HASP-UMN/2015/Subsystem Tests/Detector Testing/Amplifier_Waveforms.png

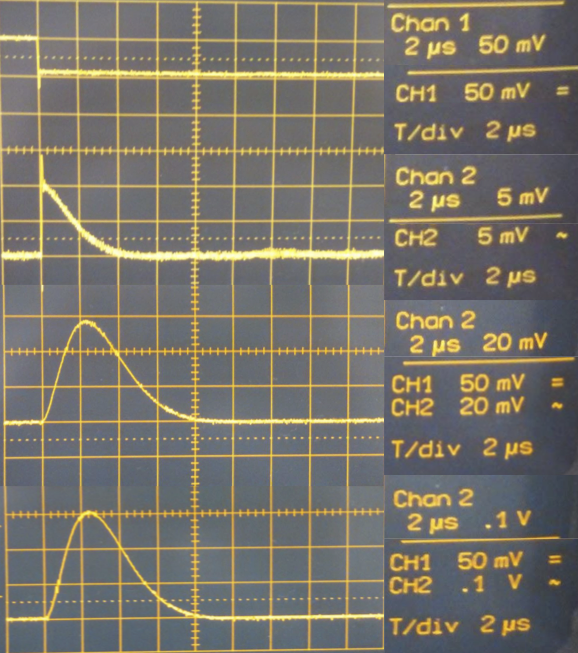
Subsystem Tests/Detector Testing/Amplifier_Waveforms.png
