HASP-UMN/2015/Hardware/TPP/timing_preprocessor.png

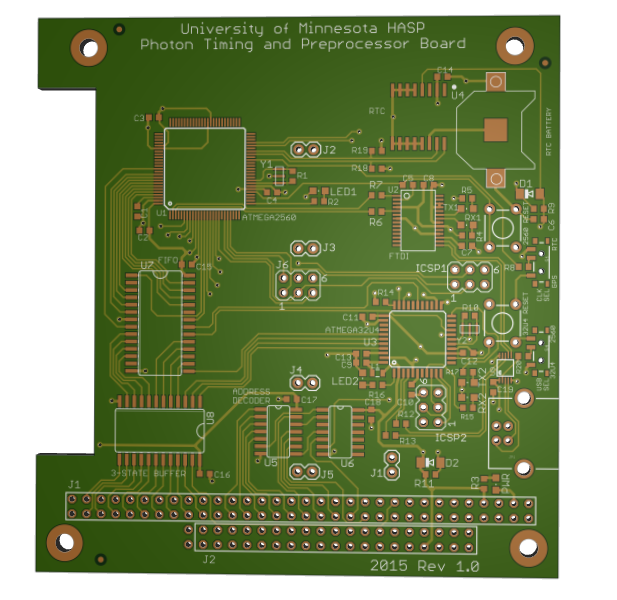
Hardware/TPP/timing_preprocessor.png
