HASP-UMN/2015/Hardware/Detector Front End/FE#1.png

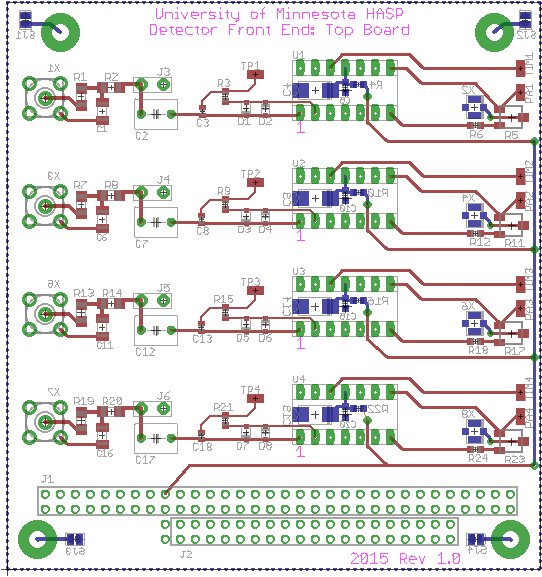
Hardware/Detector Front End/FE#1.png
