HASP-UMN/2015/Hardware/Detector Front End/FE#2.png

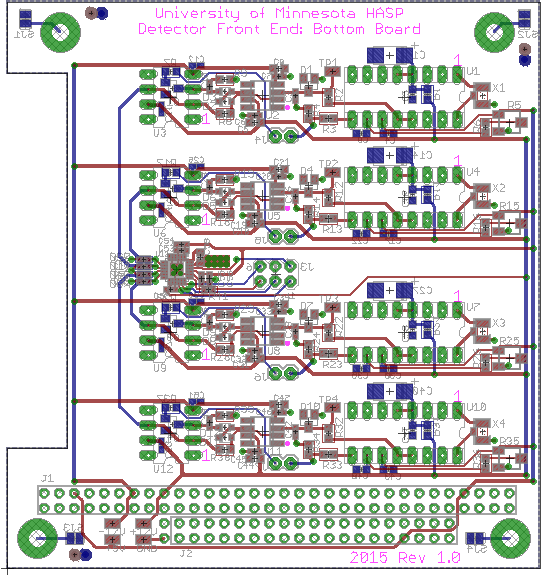
Hardware/Detector Front End/FE#2.png
