HASP-UMN/2015/Hardware/GNSS-IMU/GNSS_IMU.png

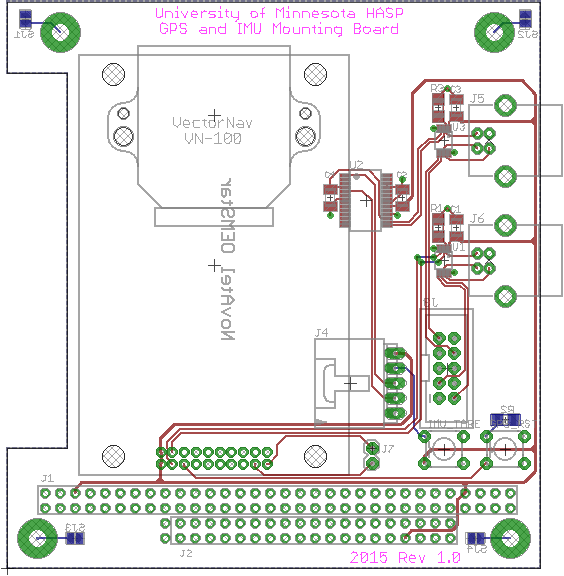
Hardware/GNSS-IMU/GNSS_IMU.png
