HASP-UMN/2015/Hardware/HVPS/HVPS.png

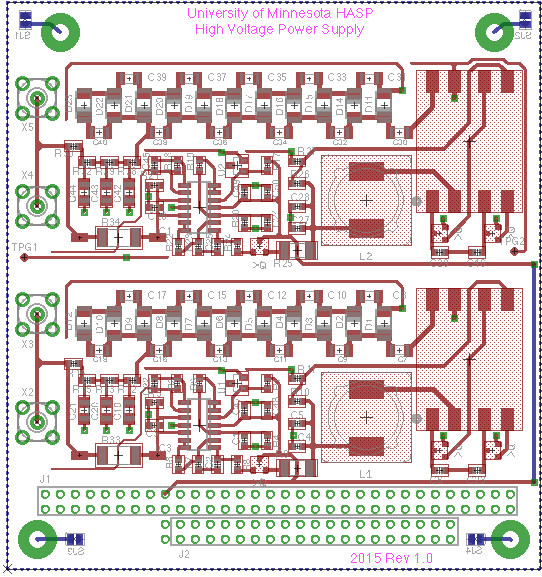
Hardware/HVPS/HVPS.png
