HASP-UMN/2015/Hardware/TPP/TPP.png

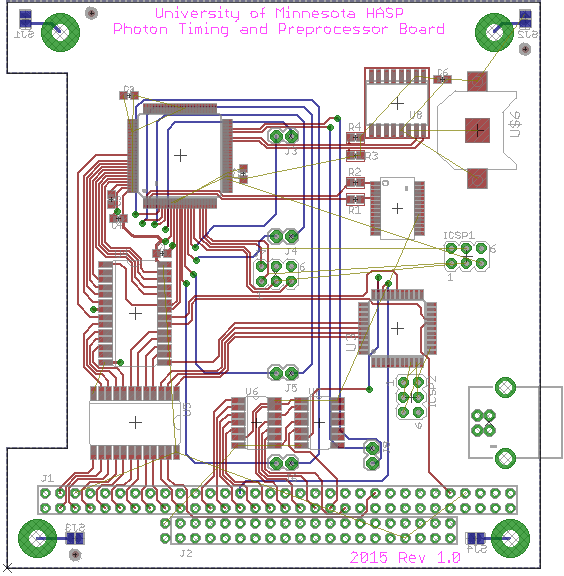
Hardware/TPP/TPP.png
