HASP-UMN/2015/Subsystem Tests/Detector Testing/Source Spectra/Am-241_1.png

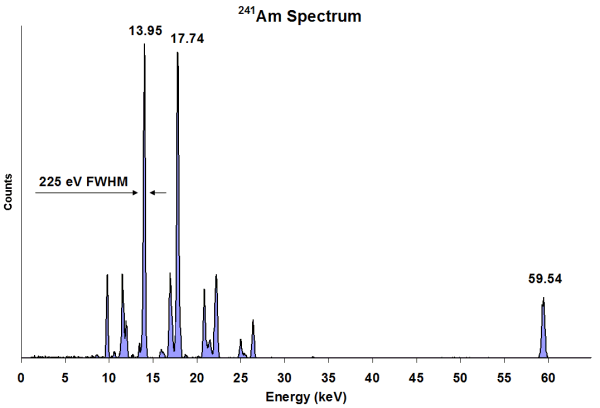
Subsystem Tests/Detector Testing/Source Spectra/Am-241_1.png
