HASP-UMN/2015/Subsystem Tests/Detector Testing/Source Spectra/Am-241_2.png

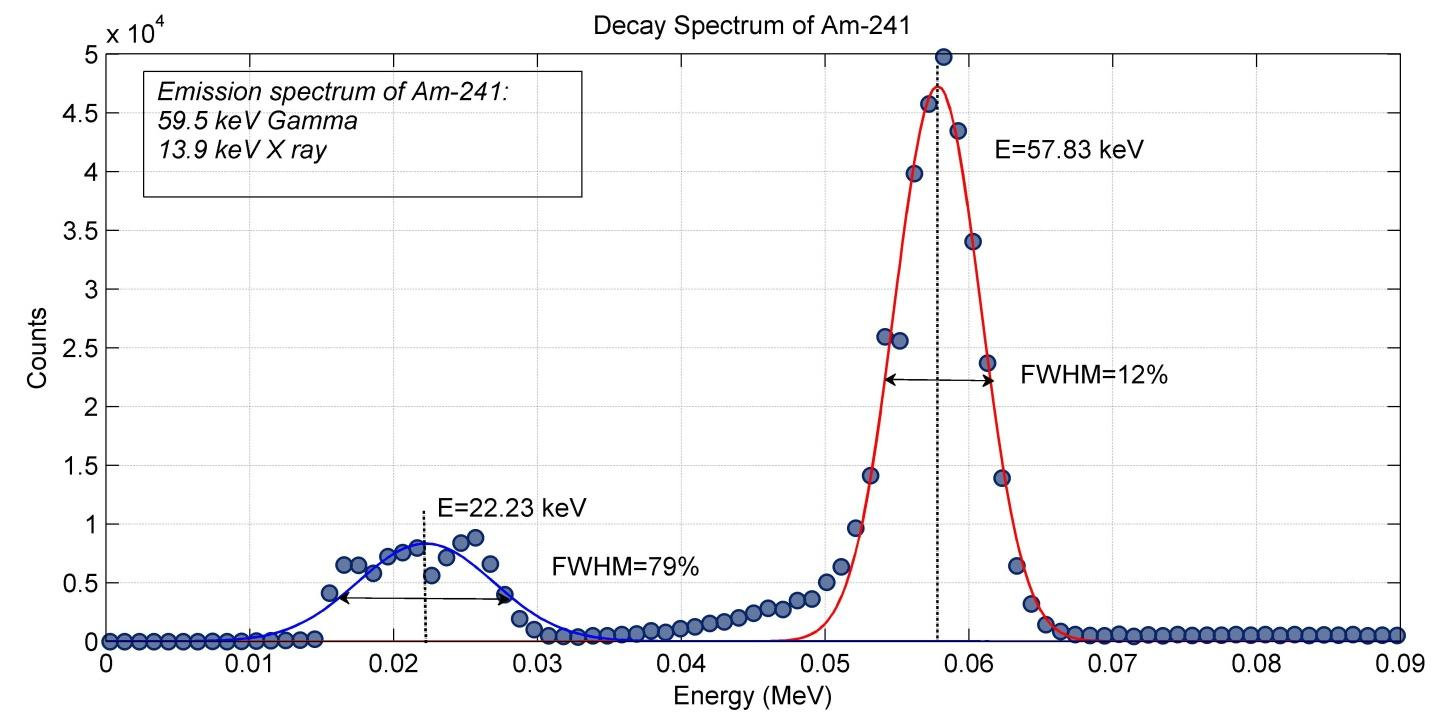
Subsystem Tests/Detector Testing/Source Spectra/Am-241_2.png
