HASP-UMN/2015/Subsystem Tests/Detector Testing/Source Spectra/Co-60_1.gif

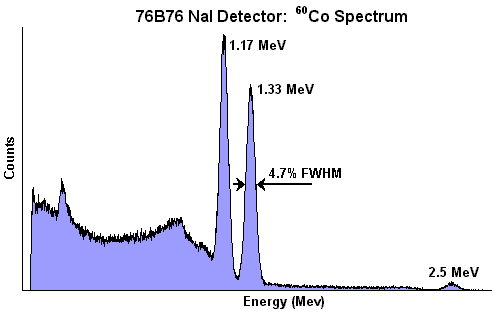
Subsystem Tests/Detector Testing/Source Spectra/Co-60_1.gif
