HASP-UMN/2015/Subsystem Tests/Detector Testing/Source Spectra/Cs-137_1.gif

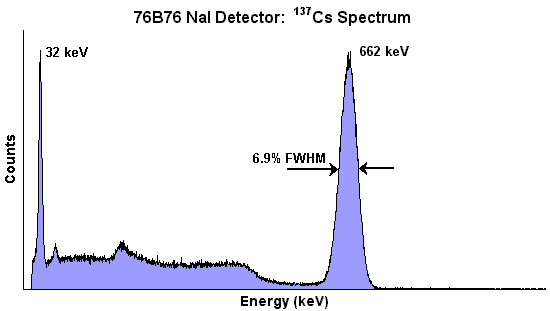
Subsystem Tests/Detector Testing/Source Spectra/Cs-137_1.gif
