HASP-UMN/2015/Subsystem Tests/Detector Testing/Cesium137.png

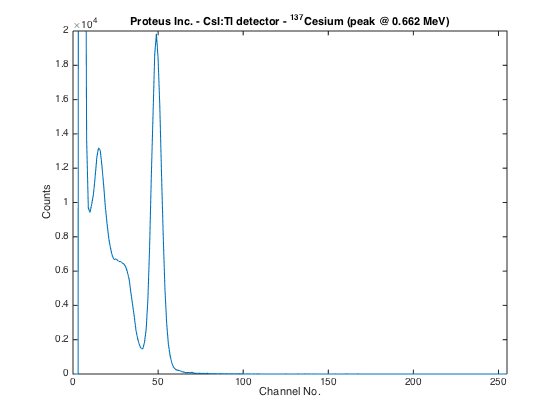
Subsystem Tests/Detector Testing/Cesium137.png
