HASP-UMN/2015/Subsystem Tests/Detector Testing/Cobalt60.png

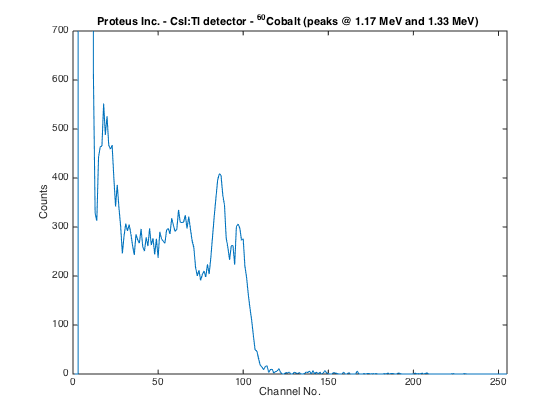
Subsystem Tests/Detector Testing/Cobalt60.png
