HASP-UMN/2015/Subsystem Tests/Detector Testing/GainFactor1.png

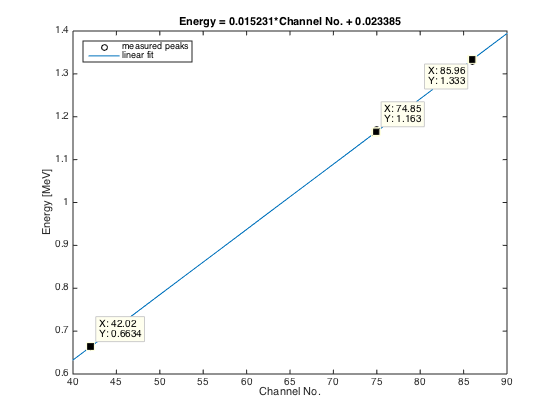
Subsystem Tests/Detector Testing/GainFactor1.png
