HASP-UMN/2015/Subsystem Tests/Detector Testing/Source Spectra/Am-241_3.pdf

## Page -1-

10⁶

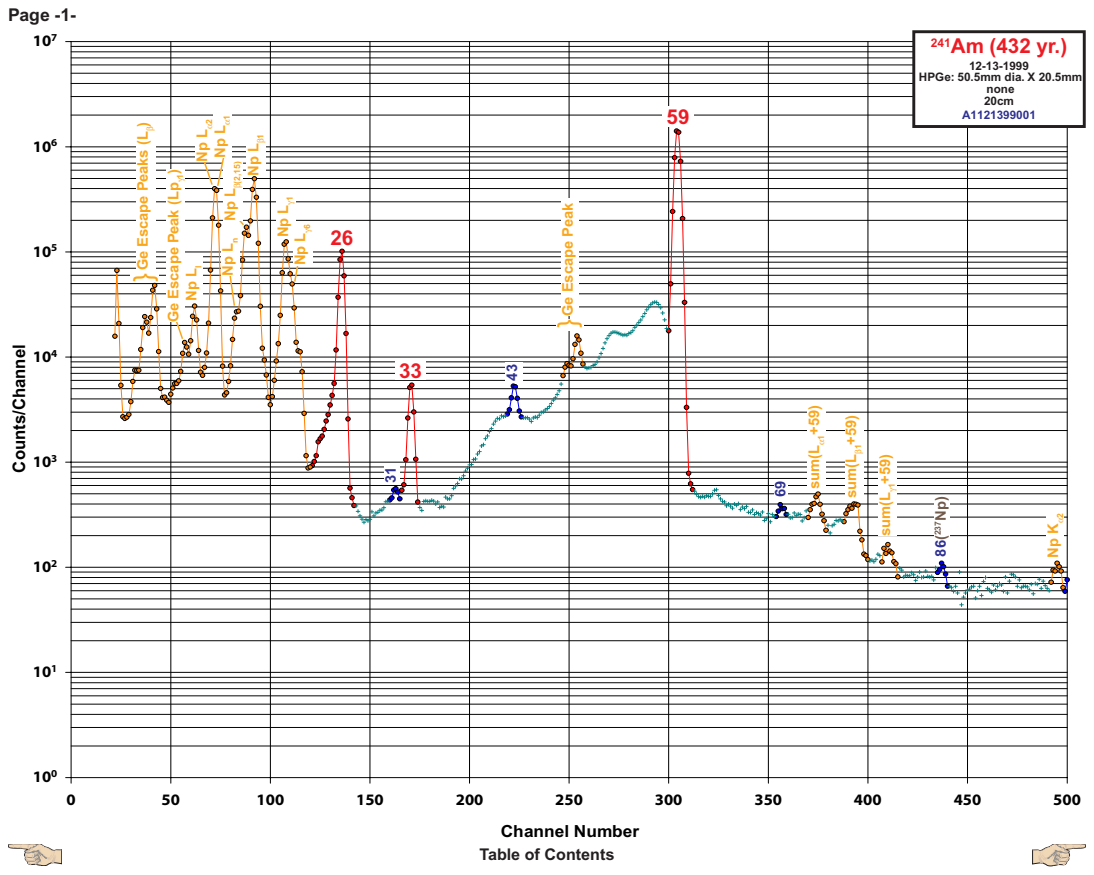
[picture p16: page 1]
Counts/Channel; 12-13-1999 HPGe: 50.5mm dia. X 20.5mm; sum(L

none
A1121399001 | 20cm

Ge Escape Peaks (L

Ge Escape Peak (Lp

Ge Escape Peak

Channel Number
Table of Contents

## Page -2-

## 241Am (432 yr.)

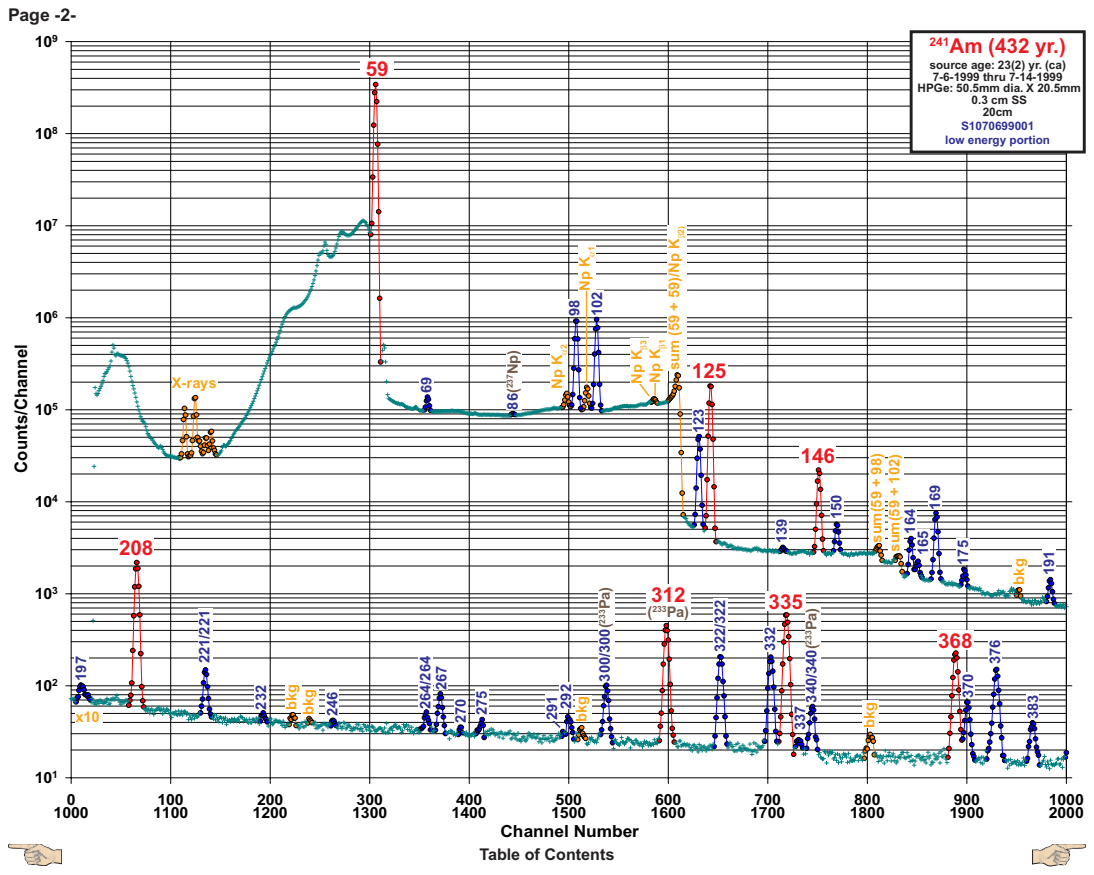
[picture p17: page 2]
Channel Number; Counts/Channel; HPGe: 50.5mm dia. X 20.5mm; X-rays; sum (59 + 59)/Np K; sum(59 + 98); sum(59 + 102); bkg

59 | source age: 23(2) yr. (ca)

7-6-1999 thru 7-14-1999

0.3 cm SS
S1070699001 | 20cm

low energy portion

## Page -3-

10⁴

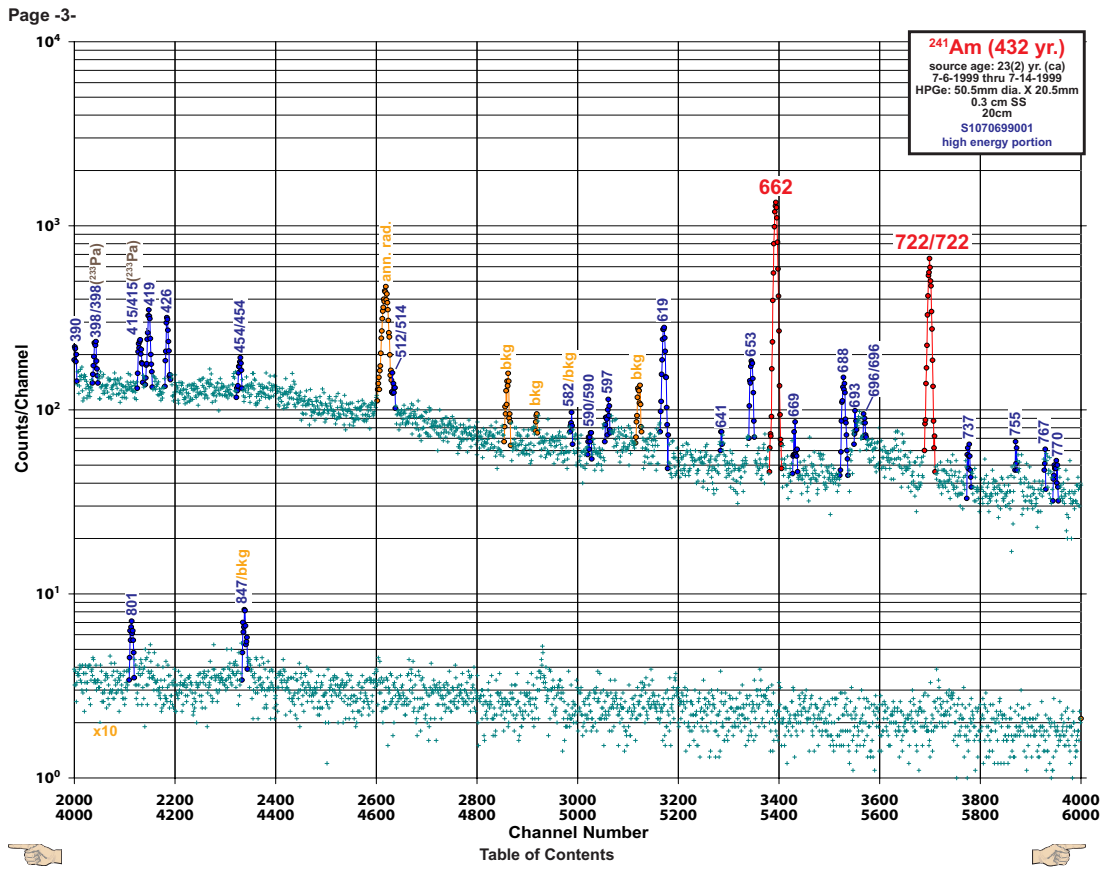
[picture p18: page 3]
Channel Number; Counts/Channel; ann. rad.; bkg; 582/bkg; 847/bkg

source age: 23(2) yr. (ca)
7-6-1999 thru 7-14-1999
HPGe: 50.5mm dia. X 20.5mm

S1070699001
high energy portion

## Page -4-

10⁵

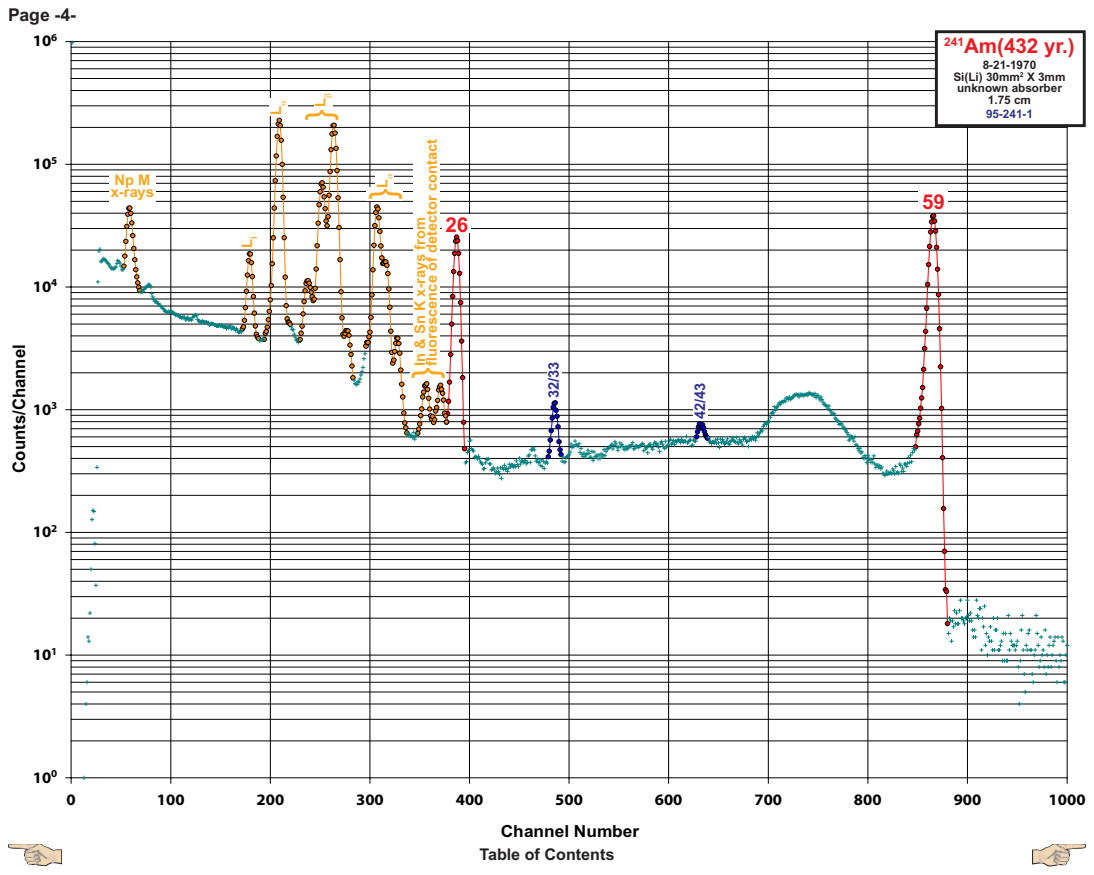
[picture p19: page 4]
Channel Number; Counts/Channel

8-21-1970
Si(Li) 30mm² X 3mm
unknown absorber
1.75 cm
95-241-1

In & Sn K x-rays from fl uorescence of detector contact

x-rays

## Page -5-

10⁶

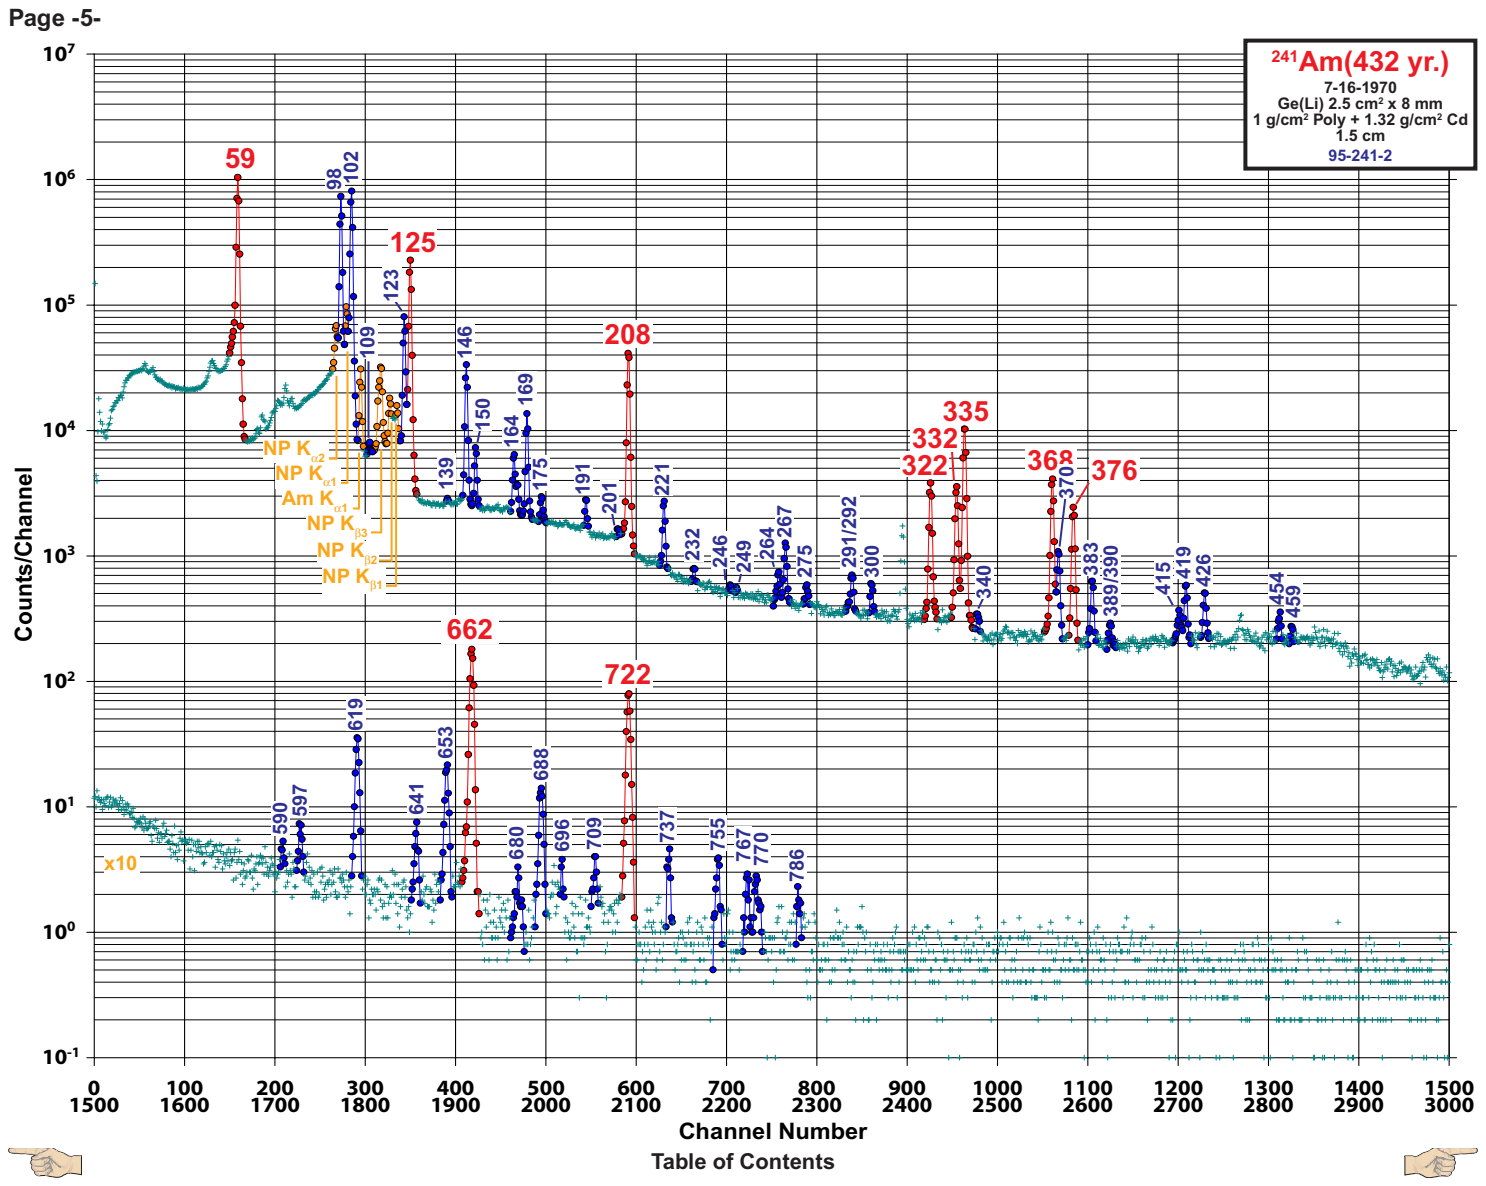
[picture p20: page 5]
Channel Number; Counts/Channel

Ge(Li) 2.5 cm² x 8 mm

1 g/cm² Poly + 1.32 g/cm² Cd

335
332
322 | | 376

NP K

## Page -6-

# 241Am Decay Chain

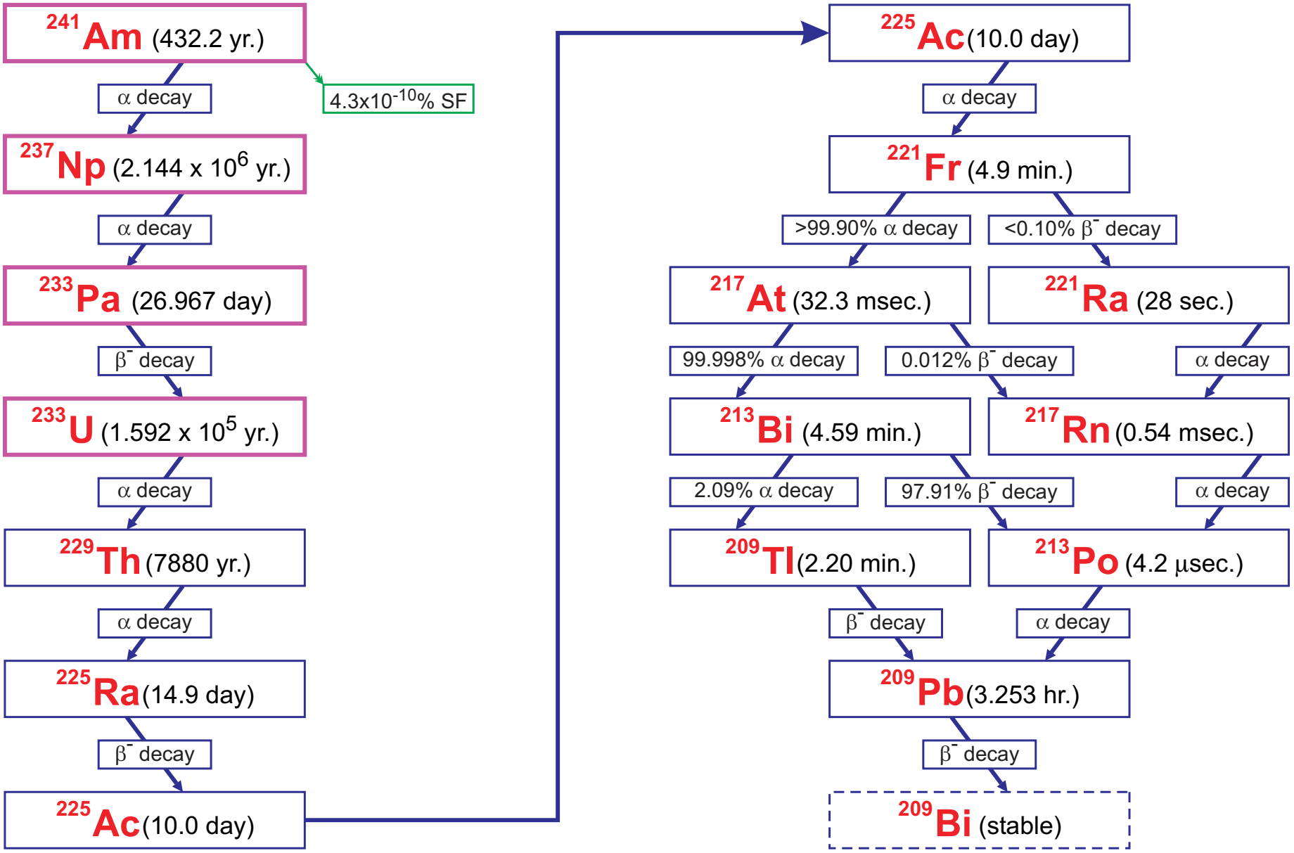
[picture p21: figure]
<0.10% -  decay; 0.012% -  decay; 97.91% -  decay; decay -; - decay; decay; Am ²⁴¹; Ra ²²¹; (28 sec.); Rn ²¹⁷; (0.54 msec.); Po ²¹³; (4.2 sec.) ; Np ²³⁷; Pa ²³³; (26.967 day); U ²³³ (1.592 x 10 yr.) ⁵; Th ²²⁹; Ra ²²⁵; (14.9 day); Ac ²²⁵; (10.0 day); Fr ²²¹; (4.9 min.); At ²¹⁷; (32.3 msec.); Bi ²¹³; (4.59 min.); Tl ²⁰⁹ (2.20 min.); Pb ²⁰⁹; Bi ²⁰⁹; (stable)

## Page -7-

432.2 yr.

# 241Am (432.2 yr.) Decay Scheme

## Part 1 of 4

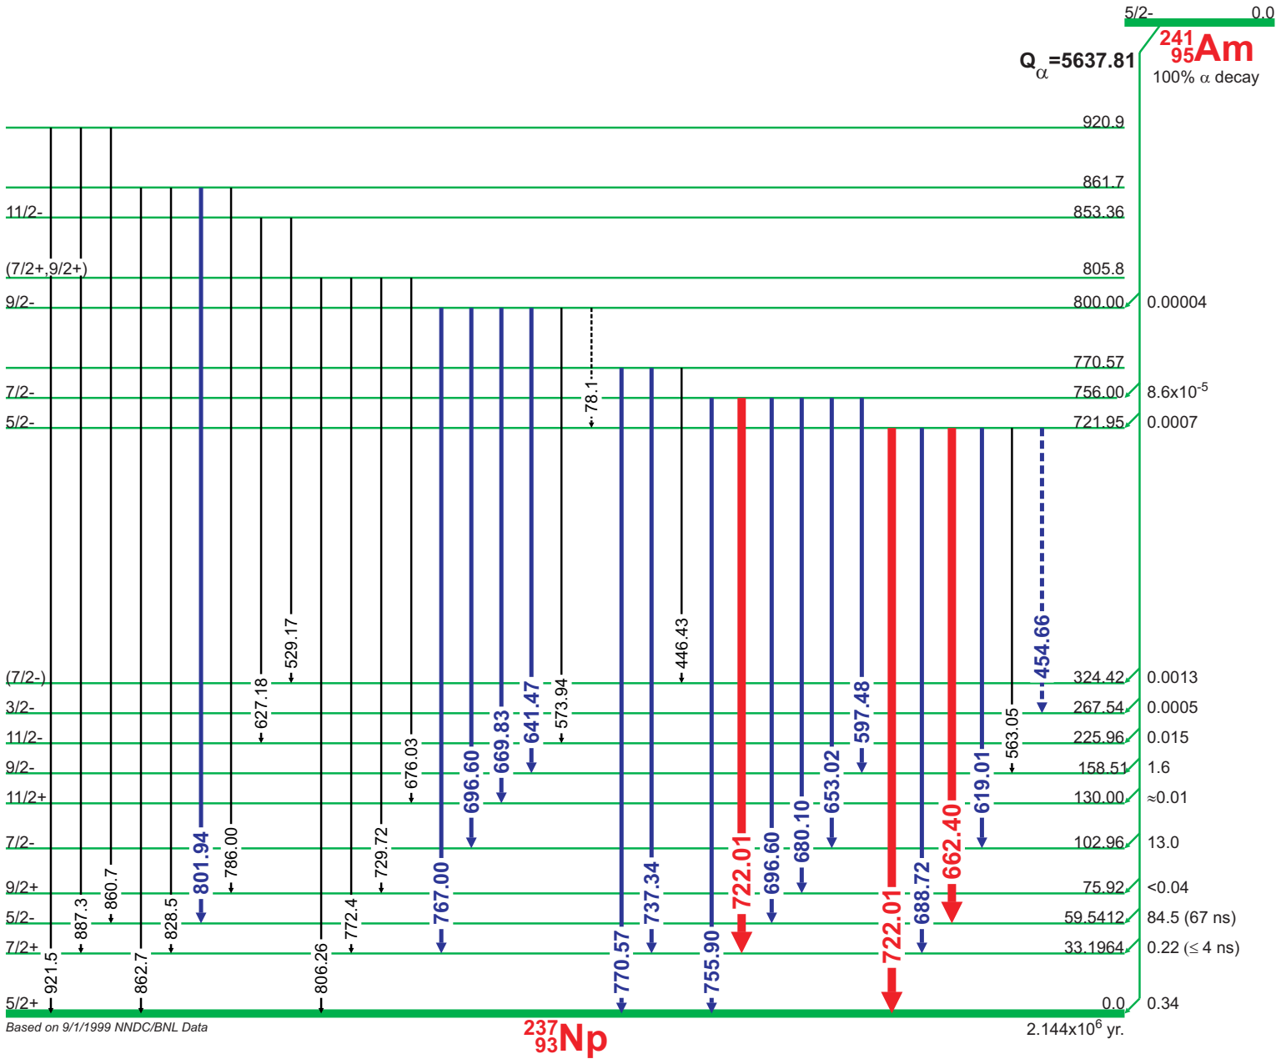
[picture p22: figure]
Np ²³⁷93; decay ; Based on 9/1/1999 NNDC/BNL Data

## Page -8-

432.2 yr.

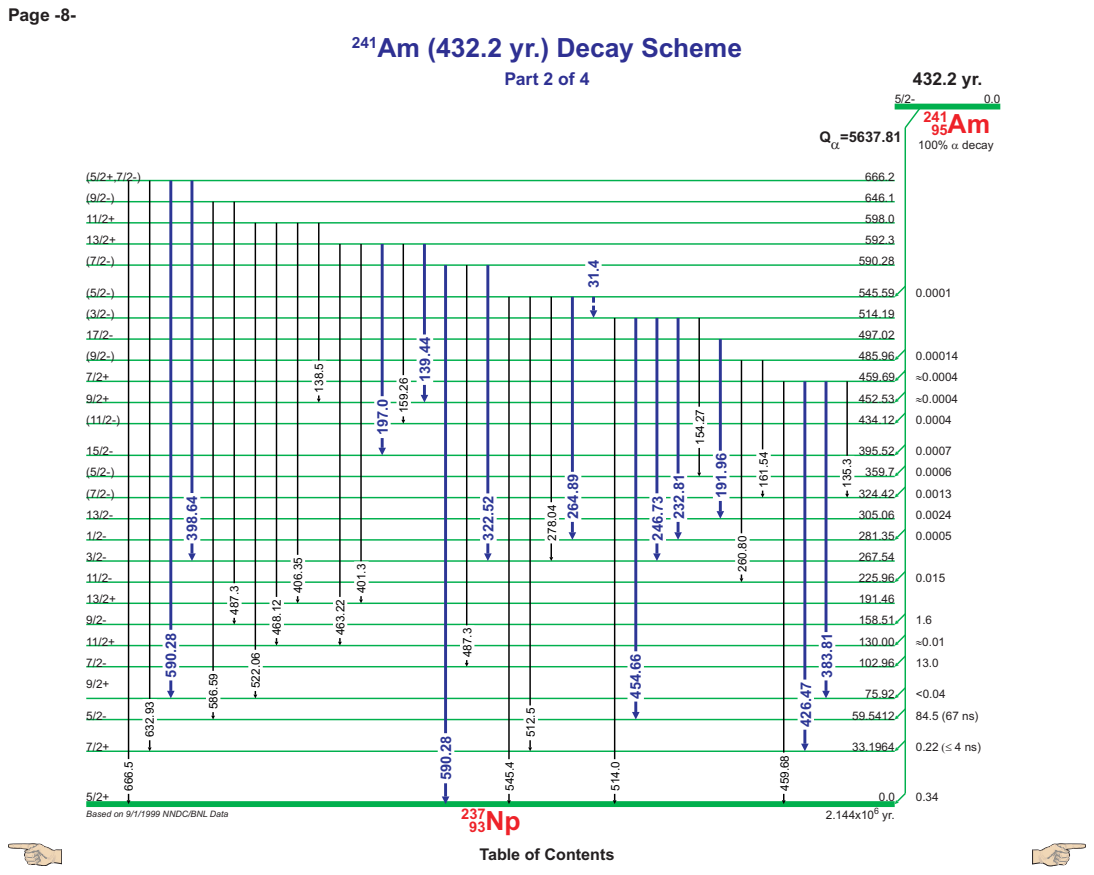
[picture p23: page 8]
decay ; Np ²³⁷93; Part 2 of 4

241Am (432.2 yr.) Decay Scheme

Based on 9/1/1999 NNDC/BNL Data

## Page -9-

432.2 yr.

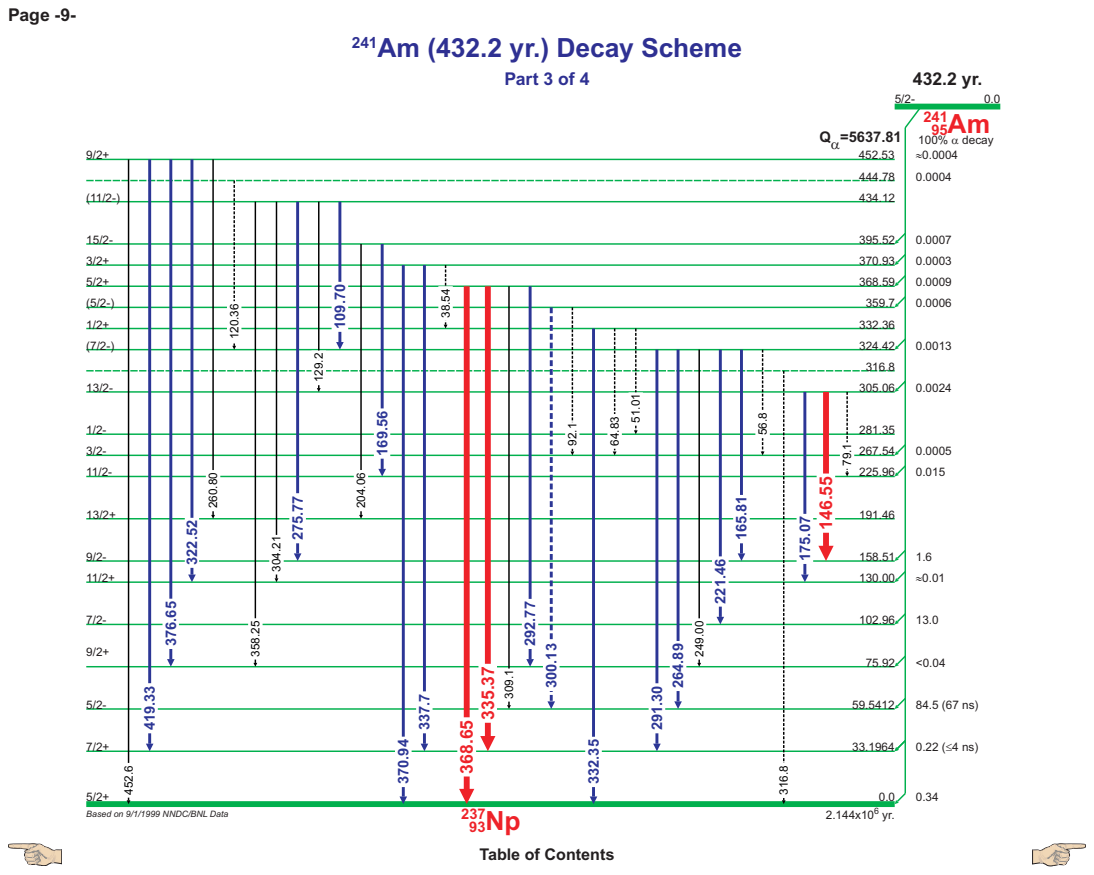
[picture p24: page 9]
decay ; Np ²³⁷93; Part 3 of 4

241Am (432.2 yr.) Decay Scheme

Based on 9/1/1999 NNDC/BNL Data

## Page -10-

432.2 yr.

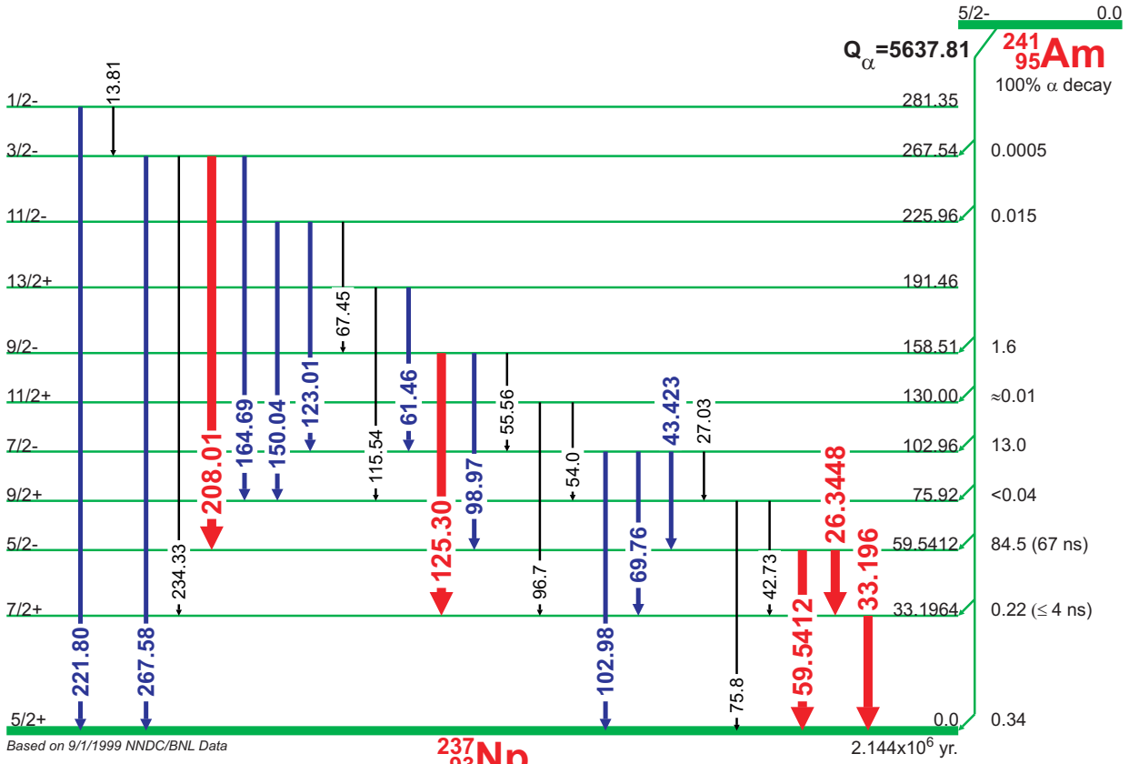
[picture p25: figure]
decay ; Based on 9/1/1999 NNDC/BNL Data

# Np ²³⁷93

# 241Am (432.2 yr.) Decay Scheme

## Part 4 of 4

## Page -11-

### GAMMA-RAY ENERGIES AND INTENSITIES (page 1 of 3)

Nuclide: 241Am | Eγ, σEγ, Iγ, σIγ, Levels- from ENSDF Database as of September 1, 1999 | Half Life: 432.2(7) yr.
Eγ ⁽keV) | σ Eγ | Iγ | -
σ Iγ | Level | Eγ ⁽keV) | σ Eγ | Iγ | -
σ Iγ | Level

These Iγ are per 100 Decays of 241Am.

For total uncertainty add systematic component of 1% in quadrature, based on the normalization factor 1.00x10⁻⁵(1)

13.81 | 0.02 | | | 281.35 | α
26.344 8 | 0.000 2 | 2.40 | 0.02 | 59.541 2 | α
27.03 | | | | 102.96 | α
31.4 | | | | 545.59 | α
32.183 | | 0.017 4 | 0.000 4 | | α
33.196 | 0.001 | 0.126 | 0.003 | 33.196 4 | α
38.54 | 0.03 | | | 370.93 | α
42.73 | 0.05 | 0.005 5 | 0.001 1 | 75.92 | α
43.423 | 0.010 | 0.073 | 0.008 | 102.96 | α
51.01 | 0.03 | 0.000 026 | 0.000 012 | 332.36 | α
54.0 | | | | 130 | α
55.56 | 0.02 | 0.018 1 | 0.001 8 | 158.51 | α
56.8 | | | | 324.42 | α
57.85 | 0.05 | 0.005 2 | 0.001 5 | | α
59.541 2 | 0.000 1 | 35.9 | 0.4 | 59.541 2 | α
61.46 | | | | 191.46 | α
64.83 | 0.02 | 0.000 145 | 0.000 018 | 332.36 | α
67.45 | 0.05 | 0.000 42 | 0.000 10 | 225.96 | α
69.76 | 0.03 | 0.002 90 | 0.000 40 | 102.96 | α
75.8 | 0.2 | 0.000 59 | ≈ | 75.92 | α
78.1 | | | | 800 | α
79.1 | | | | 305.06 | α
92.1 | | | | 359.7 | α
96.7 | 0.2 | | | 130 | α
98.97 | 0.02 | 0.020 3 | 0.000 4 | 158.51 | α
102.98 | 0.02 | 0.019 5 | 0.000 4 | 102.96 | α
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
912.4 | | 0.000 000 25 | 0.000 000 05 | | α
921.5 | 0.3 | 0.000 000 19 | 0.000 000 04 | 920.9 | α
928.8 | | 0.000 000 055 | 0.000 000 028 | | α
945.7 | | 0.000 000 056 | 0.000 000 028 | | α
955.7 | | 0.000 000 58 | 0.000 000 06 | | α
1,014.7 | 0.5 | 0.000 000 064 | 0.000 000 010 | | α
