HASP-UMN/2015/Hardware/GNSS-IMU/FT232R-Breakout_v37/FT232R-Breakout_v37.brd

## EAGLE design Hardware/GNSS-IMU/FT232R-Breakout_v37/FT232R-Breakout_v37.brd (2015-06-22)

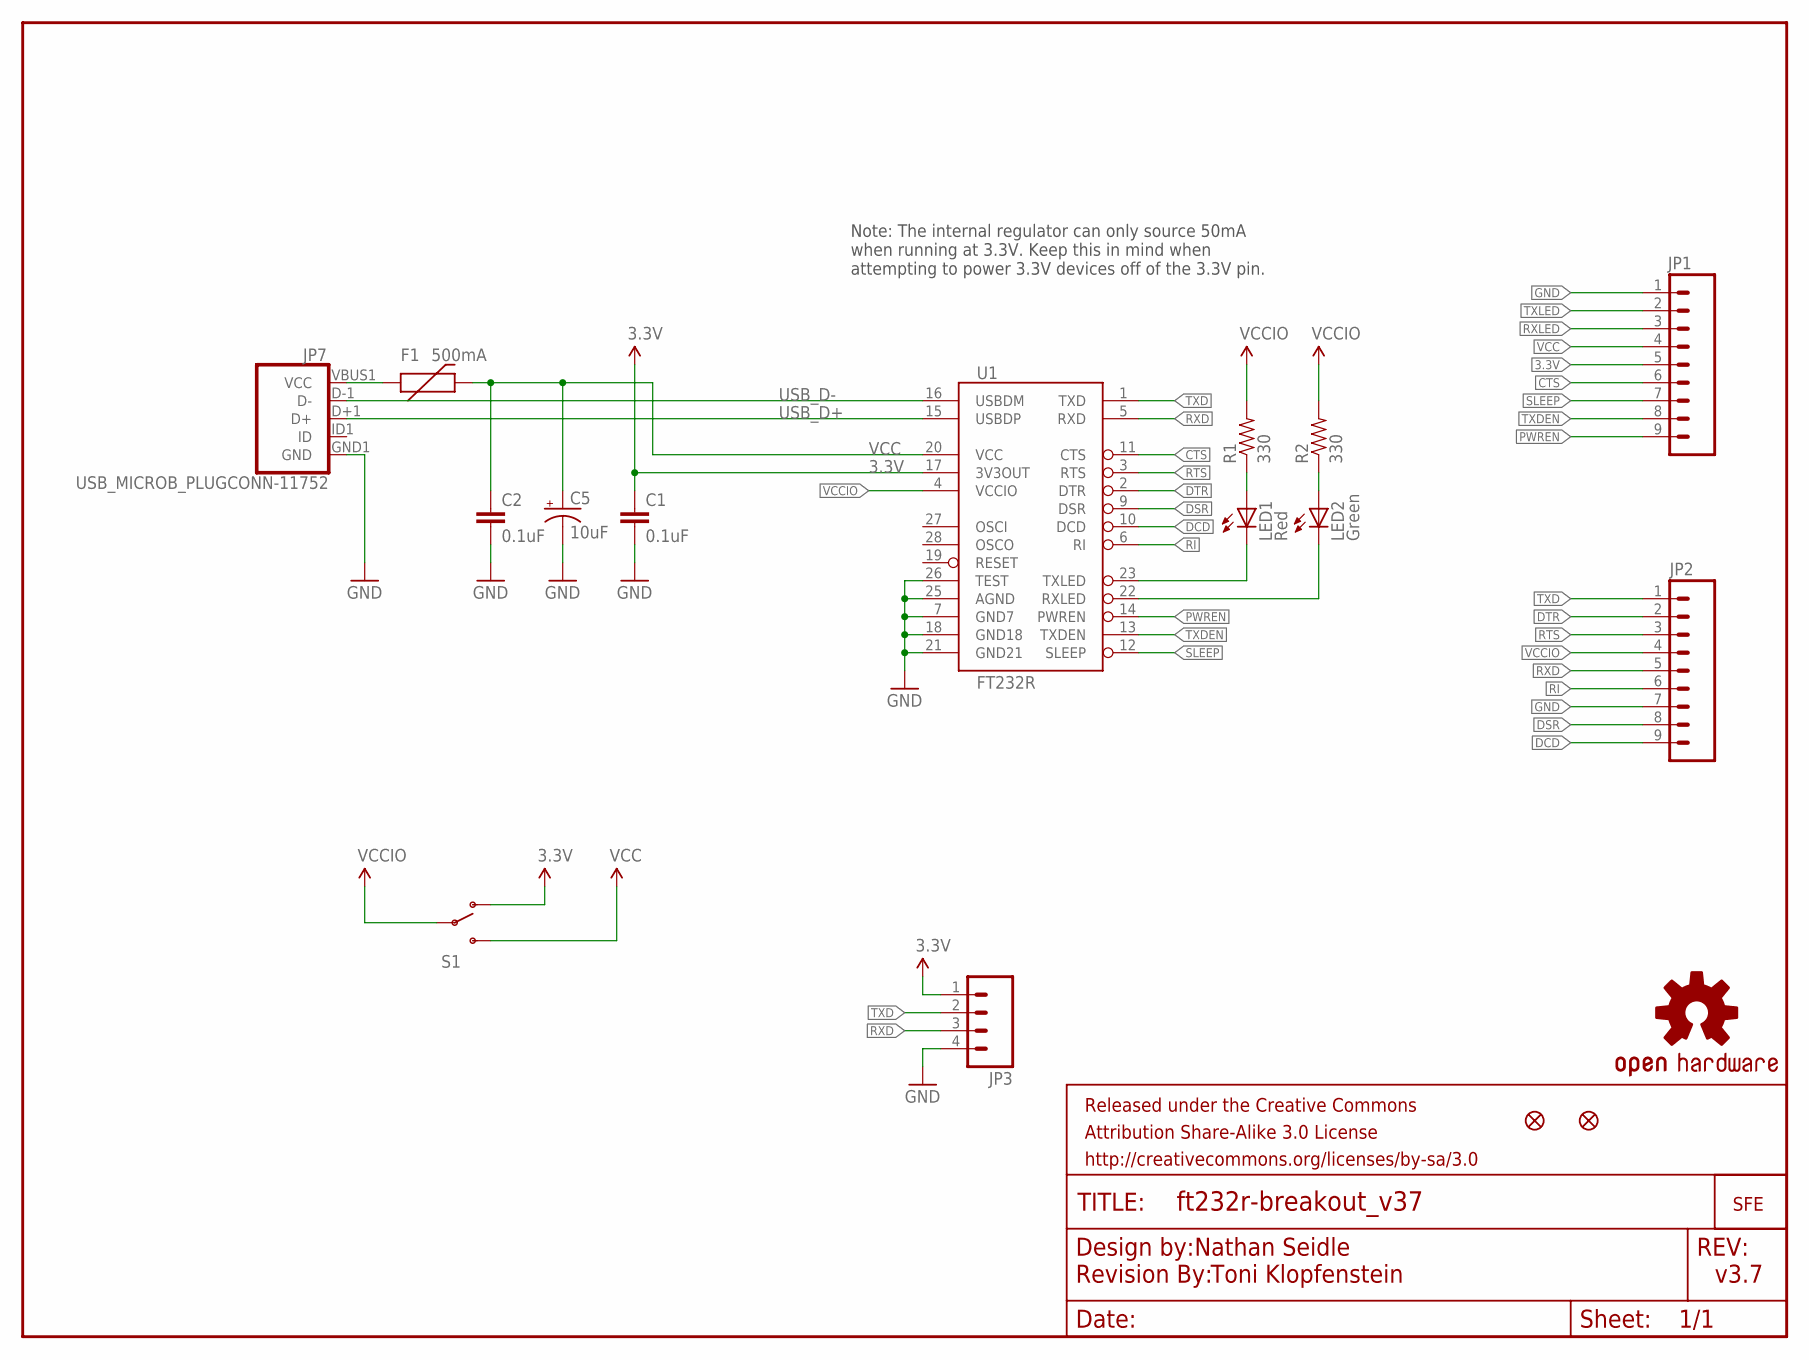
[picture p26: schematic FT232R-Breakout_v37.sch]

Parts:
C1, C2: 0.1uF; 0603-CAP
C5: 10uF; EIA3216
F1: 500mA; PTC-1206
FRAME1: FRAME-LETTER; CREATIVE_COMMONS
JP1, JP2: M09; 1X09
JP3: M04PTH; 1X04
JP5, JP6: FIDUCIAL1X2; FIDUCIAL-1X2
JP7: USB_MICROB_PLUGCONN-11752; USB-B-MICRO-SMD_V03
LED1: Red; LED-0603
LED2: Green; LED-0603
LOGO1: OSHW-LOGOS; OSHW-LOGO-S
R1, R2: 330; 0603-RES
S1: SWITCH-SPDTSMD; AYZ0202
U1: FT232R; SSOP28DB
U$1: REVISION
U$2: LOGO-SFENEW; SFE-NEW-WEBLOGO

Connections:
3.3V: C1.1, JP1.5, JP3.1, S1.1 (O), U1.17 (3V3OUT)
CTS: JP1.6, U1.11 (CTS)
DCD: JP2.9, U1.10 (DCD)
DSR: JP2.8, U1.9 (DSR)
DTR: JP2.2, U1.2 (DTR)
GND: C1.2, C2.2, C5.C (-), JP1.1, JP2.7, JP3.4, JP7.GND1 (GND), U1.7 (GND7), U1.18 (GND18), U1.21 (GND21), U1.25 (AGND), U1.26 (TEST)
unnamed: LED1.A, R1.1
unnamed: LED2.A, R2.1
unnamed: F1.1, JP7.VBUS1 (VCC)
PWREN: JP1.9, U1.14 (PWREN)
RI: JP2.6, U1.6 (RI)
RTS: JP2.3, U1.3 (RTS)
RXD: JP2.5, JP3.3, U1.5 (RXD)
RXLED: JP1.3, LED2.C, U1.22 (RXLED)
SLEEP: JP1.7, U1.12 (SLEEP)
TXD: JP2.1, JP3.2, U1.1 (TXD)
TXDEN: JP1.8, U1.13 (TXDEN)
TXLED: JP1.2, LED1.C, U1.23 (TXLED)
USB_D+: JP7.D+1 (D+), U1.15 (USBDP)
USB_D-: JP7.D-1 (D-), U1.16 (USBDM)
VCC: C2.1, C5.A (+), F1.2, JP1.4, S1.3 (S), U1.20 (VCC)
VCCIO: JP2.4, R1.2, R2.2, S1.2, U1.4 (VCCIO)

Notes on the sheet:
v3.7
Nathan Seidle
Toni Klopfenstein
Note: The internal regulator can only source 50mA when running at 3.3V. Keep this in mind when attempting to power 3.3V devices off of the 3.3V pin.

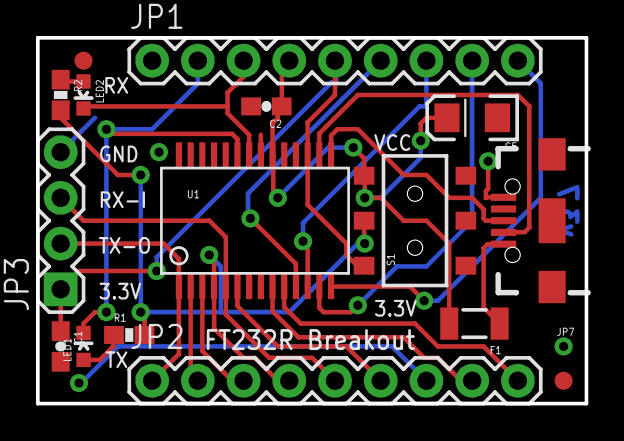
[picture p27: board FT232R-Breakout_v37.brd from above]

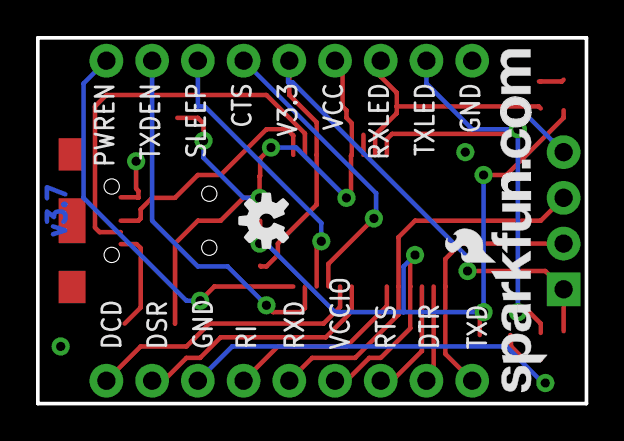
[picture p28: board FT232R-Breakout_v37.brd from below]

Board: 2 copper layers, 30.5 x 20.3 mm, 20 parts (2 on the bottom side), 22 nets.
