HASP-UMN/2015/Hardware/Detector Front End/UMN_HASP_2015_Front_End_Board2.brd

## EAGLE design Hardware/Detector Front End/UMN_HASP_2015_Front_End_Board2.brd (2015-06-22)

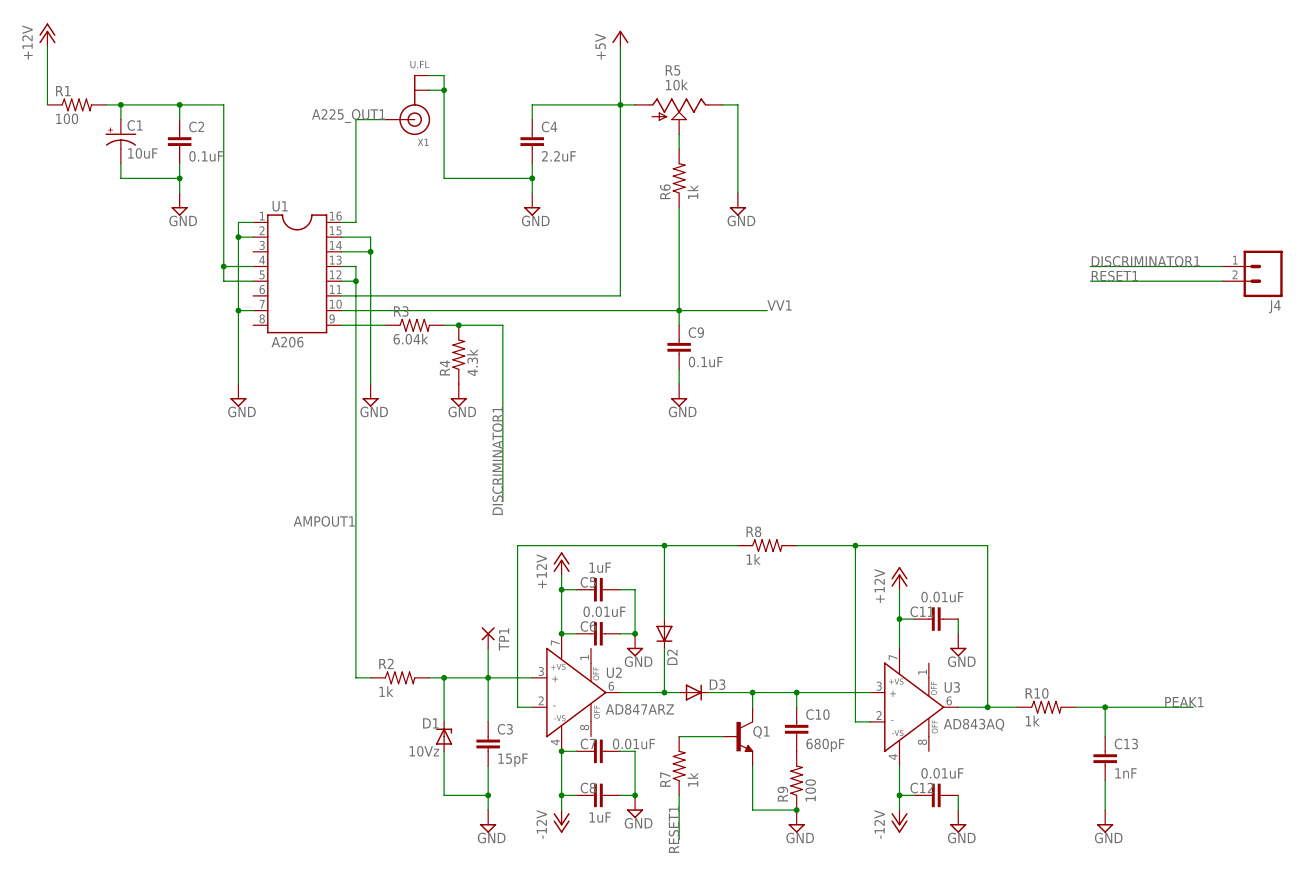
[picture p29: schematic UMN_HASP_2015_Front_End_Board2.sch, sheet 1, Channel 1]

Parts:
C1: 10uF; C/6032-28R
C2, C9: 0.1uF; C0603K
C3: 15pF; C0402K
C4: 2.2uF; C0603K
C5, C8: 1uF; C0603K
C6, C7, C11, C12: 0.01uF; C0402K
C10: 680pF; C0402K
C13: 1nF; C0402K
D1: 10Vz; SOT23
D2, D3: DIODE-SOD323-R; SOD323-R
J4: M02PTH; 1X02
Q1: -NPN-SOT23-EBC; SOT23-EBC
R1, R9: 100; R0603
R2, R6, R7, R8: 1k; R0603
R3: 6.04k; R0603
R4: 4.3k; R0603
R5: 10k; 3223J
R10: 1k; R0402
TP1: SMD2; SMD1,27-2,54
U1: A206; SOCKET-16
U2: AD847ARZ; SO8
U3: AD843AQ; DIL08
X1: U.FL

Connections:
+5V: C4.1, R5.1 (A), U1.11; also elsewhere on the board
+12V: C5.1, C6.1, C11.1, R1.1, U2.7 (+VS), U3.7 (+VS); also elsewhere on the board
-12V: C7.1, C8.1, C12.1, U2.4 (-VS), U3.4 (-VS); also elsewhere on the board
A225_OUT1: U1.16, X1.3 (SIGNAL)
AMPOUT1: R2.1, U1.12, U1.13
DISCRIMINATOR1: J4.1, R3.2, R4.2
GND: C1.-, C2.2, C3.2, C4.2, C5.2, C6.2, C7.2, C8.2, C9.2, C11.2, C12.2, C13.2, D1.1 (A), Q1.E, R4.1, R5.3 (E), R9.1, U1.1, U1.2, U1.7, U1.14, U1.15, X1.1 (GND), X1.2 (GND); also elsewhere on the board
unnamed: C1.+, C2.1, R1.2, U1.4, U1.5
unnamed: C3.1, D1.3 (C), R2.2, TP1.1, U2.3 (IN+)
unnamed: R3.1, U1.9
unnamed: D2.C, D3.A, U2.6 (OUT)
unnamed: R5.2 (S), R6.2
unnamed: D2.A, R8.1, U2.2 (IN-)
unnamed: C10.1, D3.C, Q1.C, U3.3 (IN+)
unnamed: C10.2, R9.2
unnamed: Q1.B, R7.2
unnamed: R8.2, R10.1, U3.2 (IN-), U3.6 (OUT)
PEAK1: C13.1, R10.2; also elsewhere on the board
RESET1: J4.2, R7.1
VV1: C9.1, R6.1, U1.10

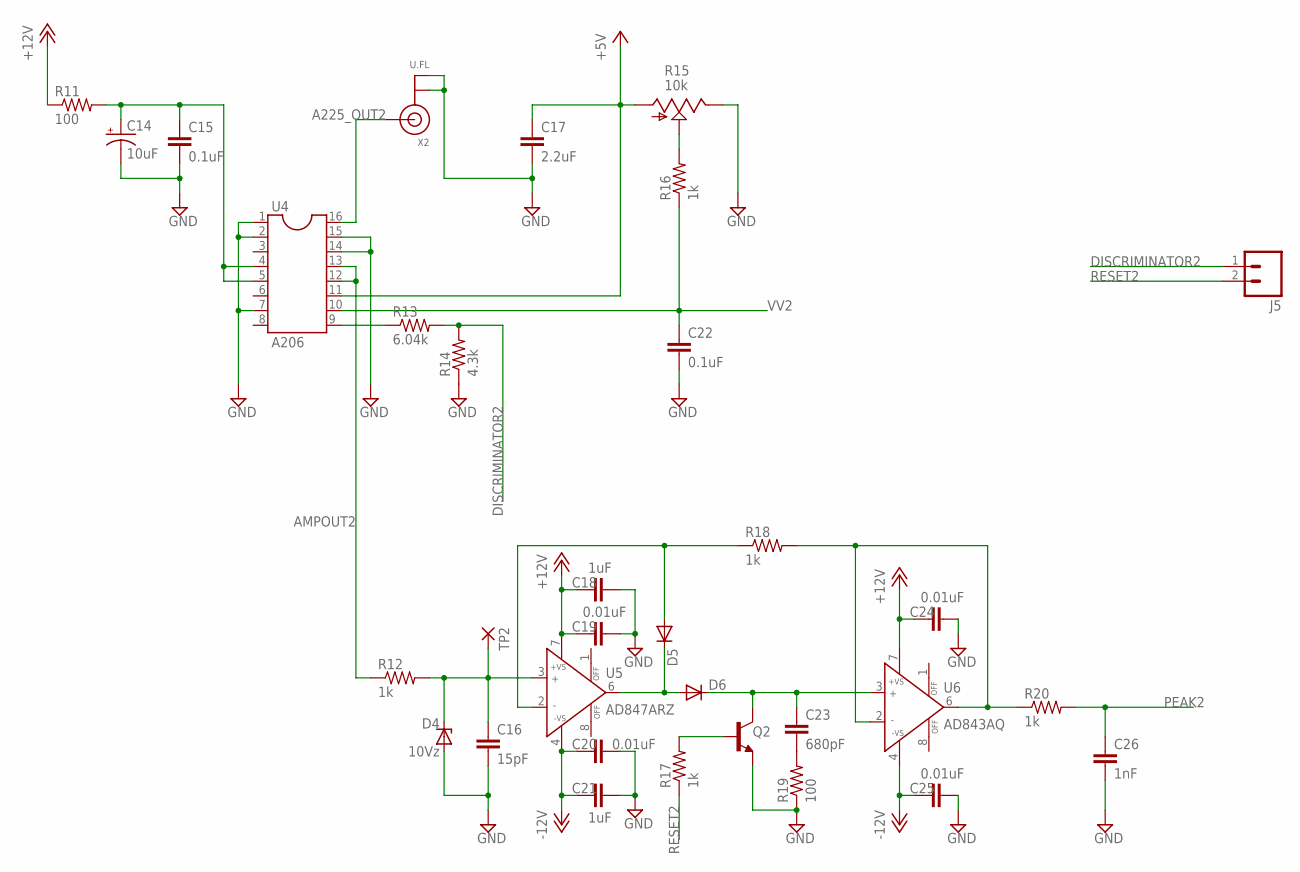
[picture p30: schematic UMN_HASP_2015_Front_End_Board2.sch, sheet 2, Channel 2]

Parts:
C14: 10uF; C/6032-28R
C15, C22: 0.1uF; C0603K
C16: 15pF; C0402K
C17: 2.2uF; C0603K
C18, C21: 1uF; C0603K
C19, C20, C24, C25: 0.01uF; C0402K
C23: 680pF; C0402K
C26: 1nF; C0402K
D4: 10Vz; SOT23
D5, D6: DIODE-SOD323-R; SOD323-R
J5: M02PTH; 1X02
Q2: -NPN-SOT23-EBC; SOT23-EBC
R11, R19: 100; R0603
R12, R16, R17, R18: 1k; R0603
R13: 6.04k; R0603
R14: 4.3k; R0603
R15: 10k; 3223J
R20: 1k; R0402
TP2: SMD2; SMD1,27-2,54
U4: A206; SOCKET-16
U5: AD847ARZ; SO8
U6: AD843AQ; DIL08
X2: U.FL

Connections:
+5V: C17.1, R15.1 (A), U4.11; also elsewhere on the board
+12V: C18.1, C19.1, C24.1, R11.1, U5.7 (+VS), U6.7 (+VS); also elsewhere on the board
-12V: C20.1, C21.1, C25.1, U5.4 (-VS), U6.4 (-VS); also elsewhere on the board
A225_OUT2: U4.16, X2.3 (SIGNAL)
AMPOUT2: R12.1, U4.12, U4.13
DISCRIMINATOR2: J5.1, R13.2, R14.2
GND: C14.-, C15.2, C16.2, C17.2, C18.2, C19.2, C20.2, C21.2, C22.2, C24.2, C25.2, C26.2, D4.1 (A), Q2.E, R14.1, R15.3 (E), R19.1, U4.1, U4.2, U4.7, U4.14, U4.15, X2.1 (GND), X2.2 (GND); also elsewhere on the board
unnamed: C14.+, C15.1, R11.2, U4.4, U4.5
unnamed: R13.1, U4.9
unnamed: R15.2 (S), R16.2
unnamed: C16.1, D4.3 (C), R12.2, TP2.1, U5.3 (IN+)
unnamed: D5.C, D6.A, U5.6 (OUT)
unnamed: D5.A, R18.1, U5.2 (IN-)
unnamed: C23.1, D6.C, Q2.C, U6.3 (IN+)
unnamed: C23.2, R19.2
unnamed: Q2.B, R17.2
unnamed: R18.2, R20.1, U6.2 (IN-), U6.6 (OUT)
PEAK2: C26.1, R20.2; also elsewhere on the board
RESET2: J5.2, R17.1
VV2: C22.1, R16.1, U4.10

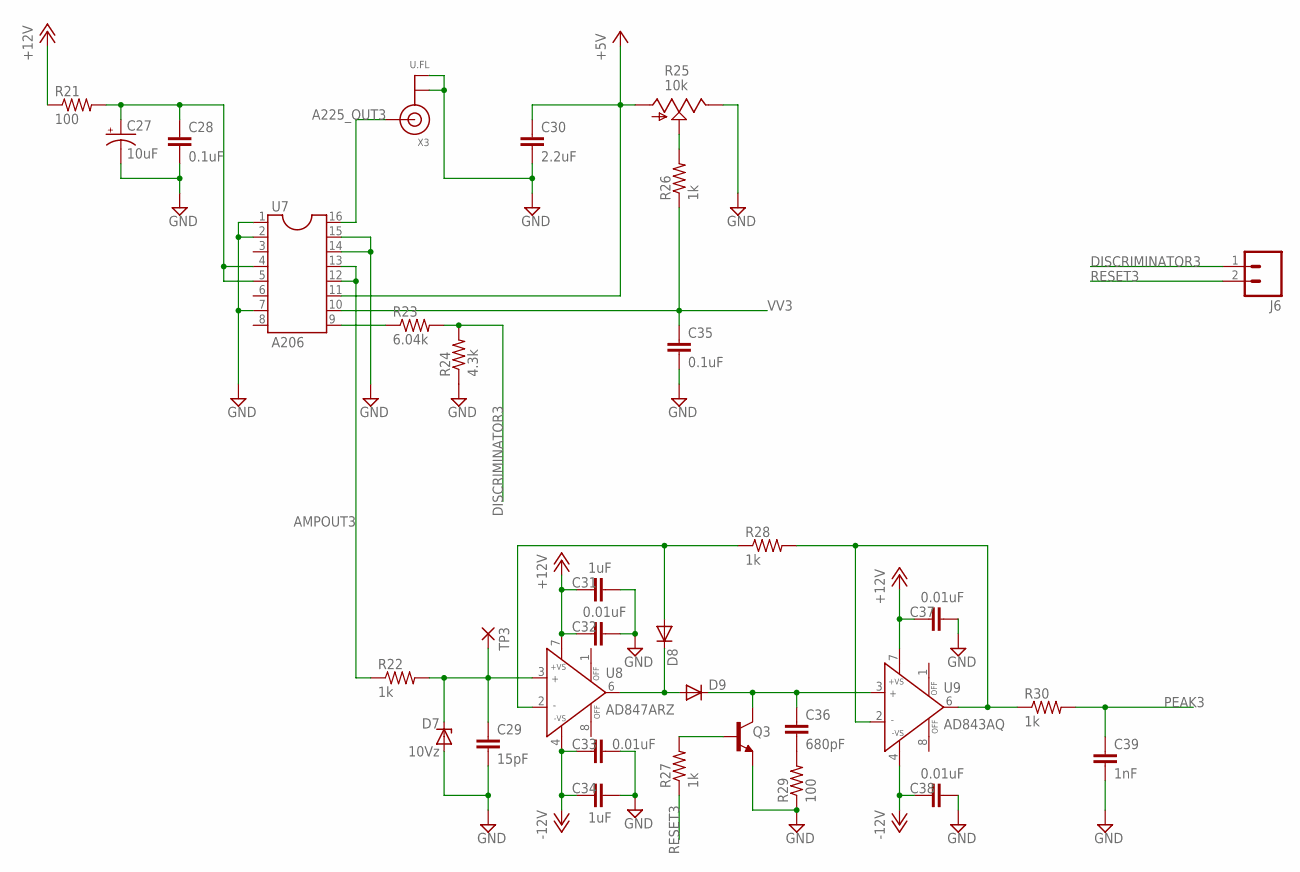
[picture p31: schematic UMN_HASP_2015_Front_End_Board2.sch, sheet 3, Channel 3]

Parts:
C27: 10uF; C/6032-28R
C28, C35: 0.1uF; C0603K
C29: 15pF; C0402K
C30: 2.2uF; C0603K
C31, C34: 1uF; C0603K
C32, C33, C37, C38: 0.01uF; C0402K
C36: 680pF; C0402K
C39: 1nF; C0402K
D7: 10Vz; SOT23
D8, D9: DIODE-SOD323-R; SOD323-R
J6: M02PTH; 1X02
Q3: -NPN-SOT23-EBC; SOT23-EBC
R21, R29: 100; R0603
R22, R26, R27, R28: 1k; R0603
R23: 6.04k; R0603
R24: 4.3k; R0603
R25: 10k; 3223J
R30: 1k; R0402
TP3: SMD2; SMD1,27-2,54
U7: A206; SOCKET-16
U8: AD847ARZ; SO8
U9: AD843AQ; DIL08
X3: U.FL

Connections:
+5V: C30.1, R25.1 (A), U7.11; also elsewhere on the board
+12V: C31.1, C32.1, C37.1, R21.1, U8.7 (+VS), U9.7 (+VS); also elsewhere on the board
-12V: C33.1, C34.1, C38.1, U8.4 (-VS), U9.4 (-VS); also elsewhere on the board
A225_OUT3: U7.16, X3.3 (SIGNAL)
AMPOUT3: R22.1, U7.12, U7.13
DISCRIMINATOR3: J6.1, R23.2, R24.2
GND: C27.-, C28.2, C29.2, C30.2, C31.2, C32.2, C33.2, C34.2, C35.2, C37.2, C38.2, C39.2, D7.1 (A), Q3.E, R24.1, R25.3 (E), R29.1, U7.1, U7.2, U7.7, U7.14, U7.15, X3.1 (GND), X3.2 (GND); also elsewhere on the board
unnamed: C27.+, C28.1, R21.2, U7.4, U7.5
unnamed: R23.1, U7.9
unnamed: R25.2 (S), R26.2
unnamed: C29.1, D7.3 (C), R22.2, TP3.1, U8.3 (IN+)
unnamed: D8.C, D9.A, U8.6 (OUT)
unnamed: D8.A, R28.1, U8.2 (IN-)
unnamed: C36.1, D9.C, Q3.C, U9.3 (IN+)
unnamed: C36.2, R29.2
unnamed: Q3.B, R27.2
unnamed: R28.2, R30.1, U9.2 (IN-), U9.6 (OUT)
PEAK3: C39.1, R30.2; also elsewhere on the board
RESET3: J6.2, R27.1
VV3: C35.1, R26.1, U7.10

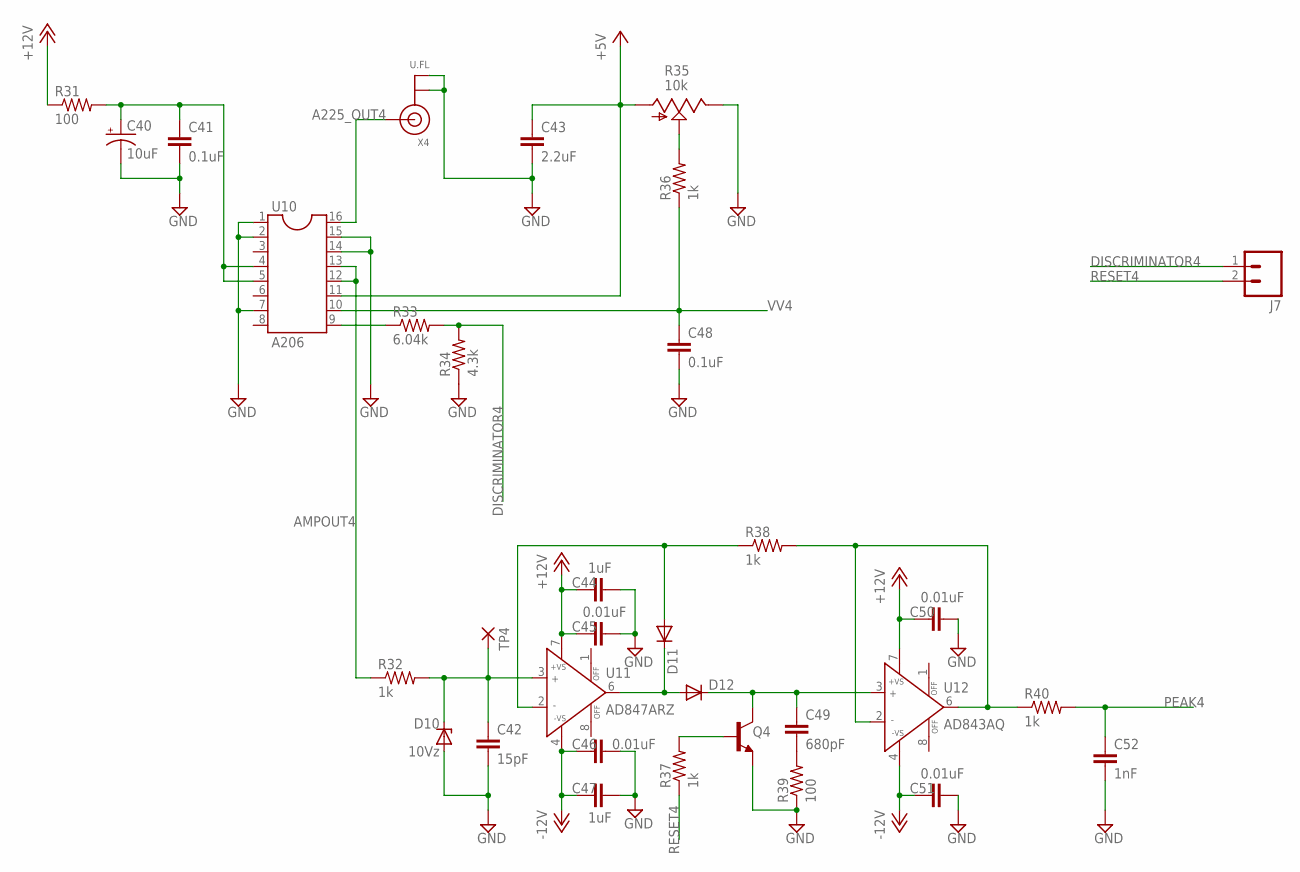
[picture p32: schematic UMN_HASP_2015_Front_End_Board2.sch, sheet 4, Channel 4]

Parts:
C40: 10uF; C/6032-28R
C41, C48: 0.1uF; C0603K
C42: 15pF; C0402K
C43: 2.2uF; C0603K
C44, C47: 1uF; C0603K
C45, C46, C50, C51: 0.01uF; C0402K
C49: 680pF; C0402K
C52: 1nF; C0402K
D10: 10Vz; SOT23
D11, D12: DIODE-SOD323-R; SOD323-R
J7: M02PTH; 1X02
Q4: -NPN-SOT23-EBC; SOT23-EBC
R31, R39: 100; R0603
R32, R36, R37, R38: 1k; R0603
R33: 6.04k; R0603
R34: 4.3k; R0603
R35: 10k; 3223J
R40: 1k; R0402
TP4: SMD2; SMD1,27-2,54
U10: A206; SOCKET-16
U11: AD847ARZ; SO8
U12: AD843AQ; DIL08
X4: U.FL

Connections:
+5V: C43.1, R35.1 (A), U10.11; also elsewhere on the board
+12V: C44.1, C45.1, C50.1, R31.1, U11.7 (+VS), U12.7 (+VS); also elsewhere on the board
-12V: C46.1, C47.1, C51.1, U11.4 (-VS), U12.4 (-VS); also elsewhere on the board
A225_OUT4: U10.16, X4.3 (SIGNAL)
AMPOUT4: R32.1, U10.12, U10.13
DISCRIMINATOR4: J7.1, R33.2, R34.2
GND: C40.-, C41.2, C42.2, C43.2, C44.2, C45.2, C46.2, C47.2, C48.2, C50.2, C51.2, C52.2, D10.1 (A), Q4.E, R34.1, R35.3 (E), R39.1, U10.1, U10.2, U10.7, U10.14, U10.15, X4.1 (GND), X4.2 (GND); also elsewhere on the board
unnamed: C40.+, C41.1, R31.2, U10.4, U10.5
unnamed: R33.1, U10.9
unnamed: R35.2 (S), R36.2
unnamed: C42.1, D10.3 (C), R32.2, TP4.1, U11.3 (IN+)
unnamed: D11.C, D12.A, U11.6 (OUT)
unnamed: D11.A, R38.1, U11.2 (IN-)
unnamed: C49.1, D12.C, Q4.C, U12.3 (IN+)
unnamed: C49.2, R39.2
unnamed: Q4.B, R37.2
unnamed: R38.2, R40.1, U12.2 (IN-), U12.6 (OUT)
PEAK4: C52.1, R40.2; also elsewhere on the board
RESET4: J7.2, R37.1
VV4: C48.1, R36.1, U10.10

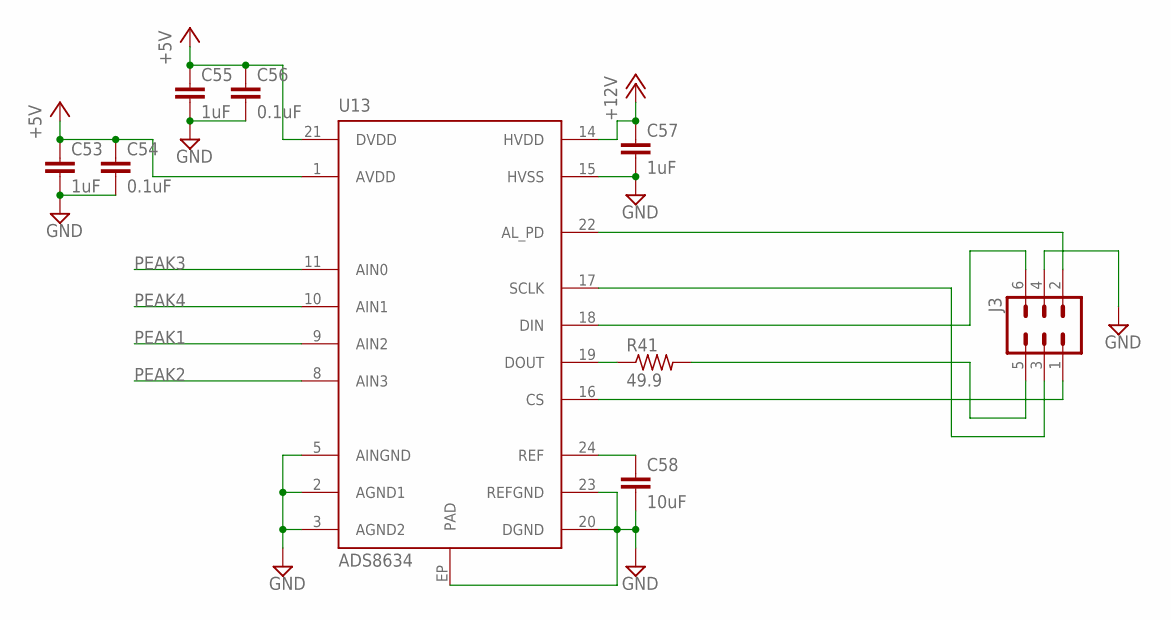
[picture p33: schematic UMN_HASP_2015_Front_End_Board2.sch, sheet 5, A/D Converter]

Parts:
C53, C55, C57: 1uF; C0402K
C54, C56: 0.1uF; C0402K
C58: 10uF; C0603K
J3: MA03-2
R41: 49.9; R0402
U13: ADS8634; QFN24

Connections:
+5V: C53.1, C54.1, C55.1, C56.1, U13.1 (AVDD), U13.21 (DVDD); also elsewhere on the board
+12V: C57.1, U13.14 (HVDD); also elsewhere on the board
AL_PD: J3.2, U13.22 (AL_PD)
CS: J3.1, U13.16 (CS)
DIN: J3.6, U13.18 (DIN)
DOUT: J3.5, R41.2
GND: C53.2, C54.2, C55.2, C56.2, C57.2, C58.2, J3.4, U13.2 (AGND1), U13.3 (AGND2), U13.5 (AINGND), U13.15 (HVSS), U13.20 (DGND), U13.23 (REFGND), U13.EP (PAD); also elsewhere on the board
unnamed: R41.1, U13.19 (DOUT)
PEAK1: U13.9 (AIN2); also elsewhere on the board
PEAK2: U13.8 (AIN3); also elsewhere on the board
PEAK3: U13.11 (AIN0); also elsewhere on the board
PEAK4: U13.10 (AIN1); also elsewhere on the board
REF: C58.1, U13.24 (REF)
SCLK: J3.3, U13.17 (SCLK)

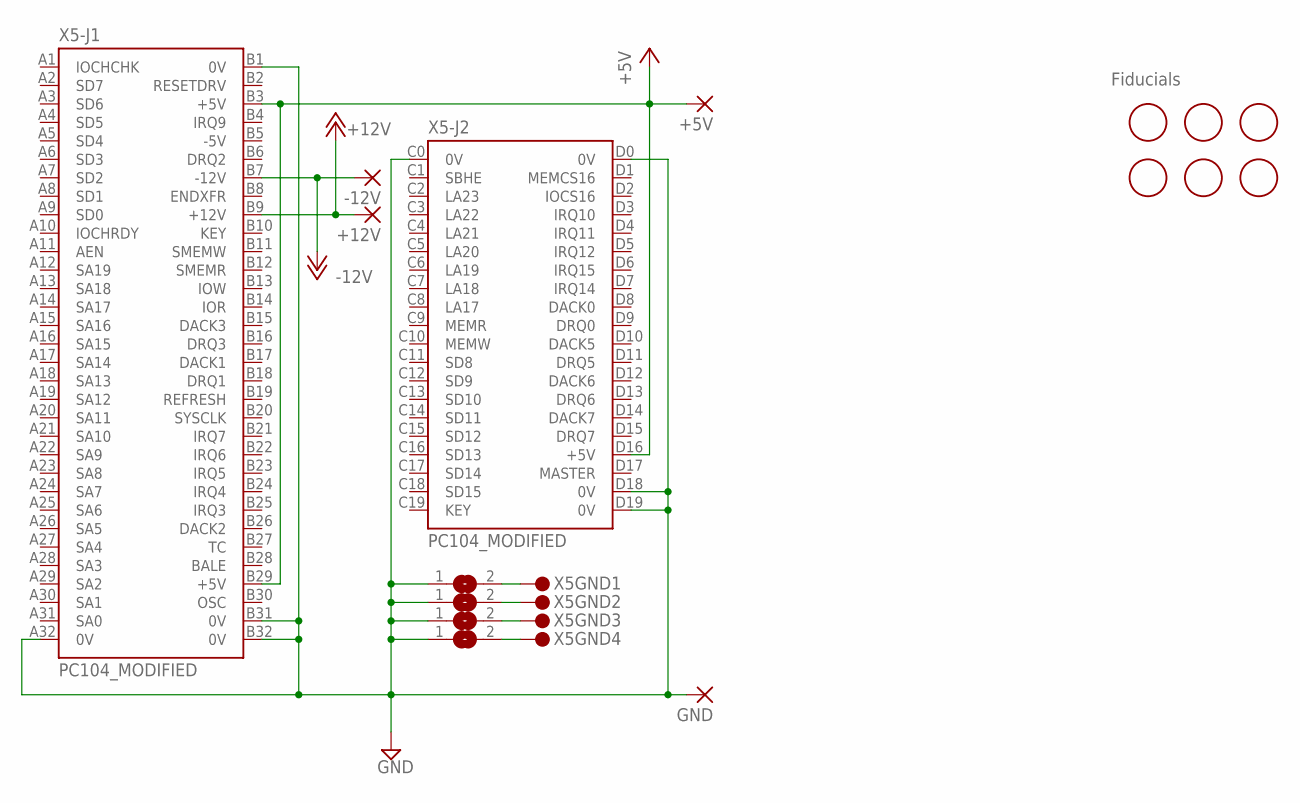
[picture p34: schematic UMN_HASP_2015_Front_End_Board2.sch, sheet 6, PC/104]

Parts:
+5V, +12V: SMD2; SMD1,27-2,54
-12V: SMD2; SMD1,27-2,54
F1, F2, F3, F4, F5, F6: FIDUCIAL; FIDUCIAL_1MM
GND: SMD2; SMD1,27-2,54
SJ1, SJ2, SJ3, SJ4: SJ
X5: PC104_MODIFIED

Connections:
+5V: +5V.1, X5.B3 (+5V), X5.B29 (+5V), X5.D16 (+5V); also elsewhere on the board
+12V: +12V.1, X5.B9 (+12V); also elsewhere on the board
-12V: -12V.1, X5.B7 (-12V); also elsewhere on the board
GND: GND.1, SJ1.1, SJ2.1, SJ3.1, SJ4.1, X5.A32 (0V), X5.B1 (0V), X5.B31 (0V), X5.B32 (0V), X5.C0 (0V), X5.D0 (0V), X5.D18 (0V), X5.D19 (0V); also elsewhere on the board
unnamed: SJ1.2, X5.GND@1 (1)
unnamed: SJ2.2, X5.GND@2 (1)
unnamed: SJ3.2, X5.GND@3 (1)
unnamed: SJ4.2, X5.GND@4 (1)

Notes on the sheet:
Fiducials

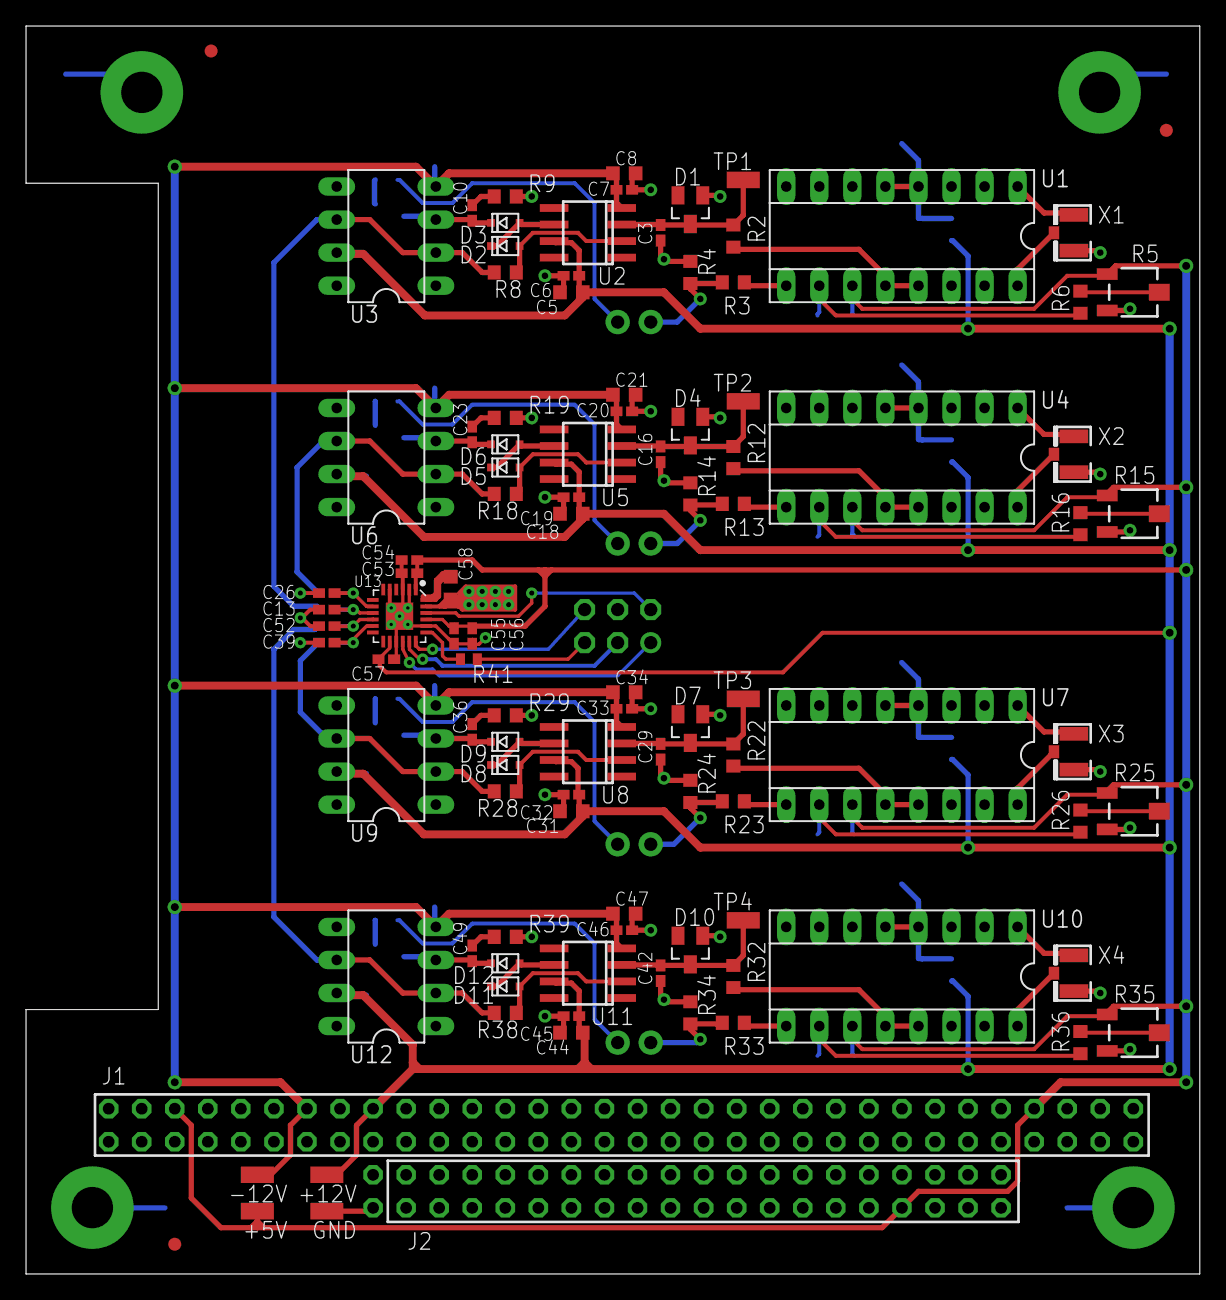
[picture p35: board UMN_HASP_2015_Front_End_Board2.brd from above]

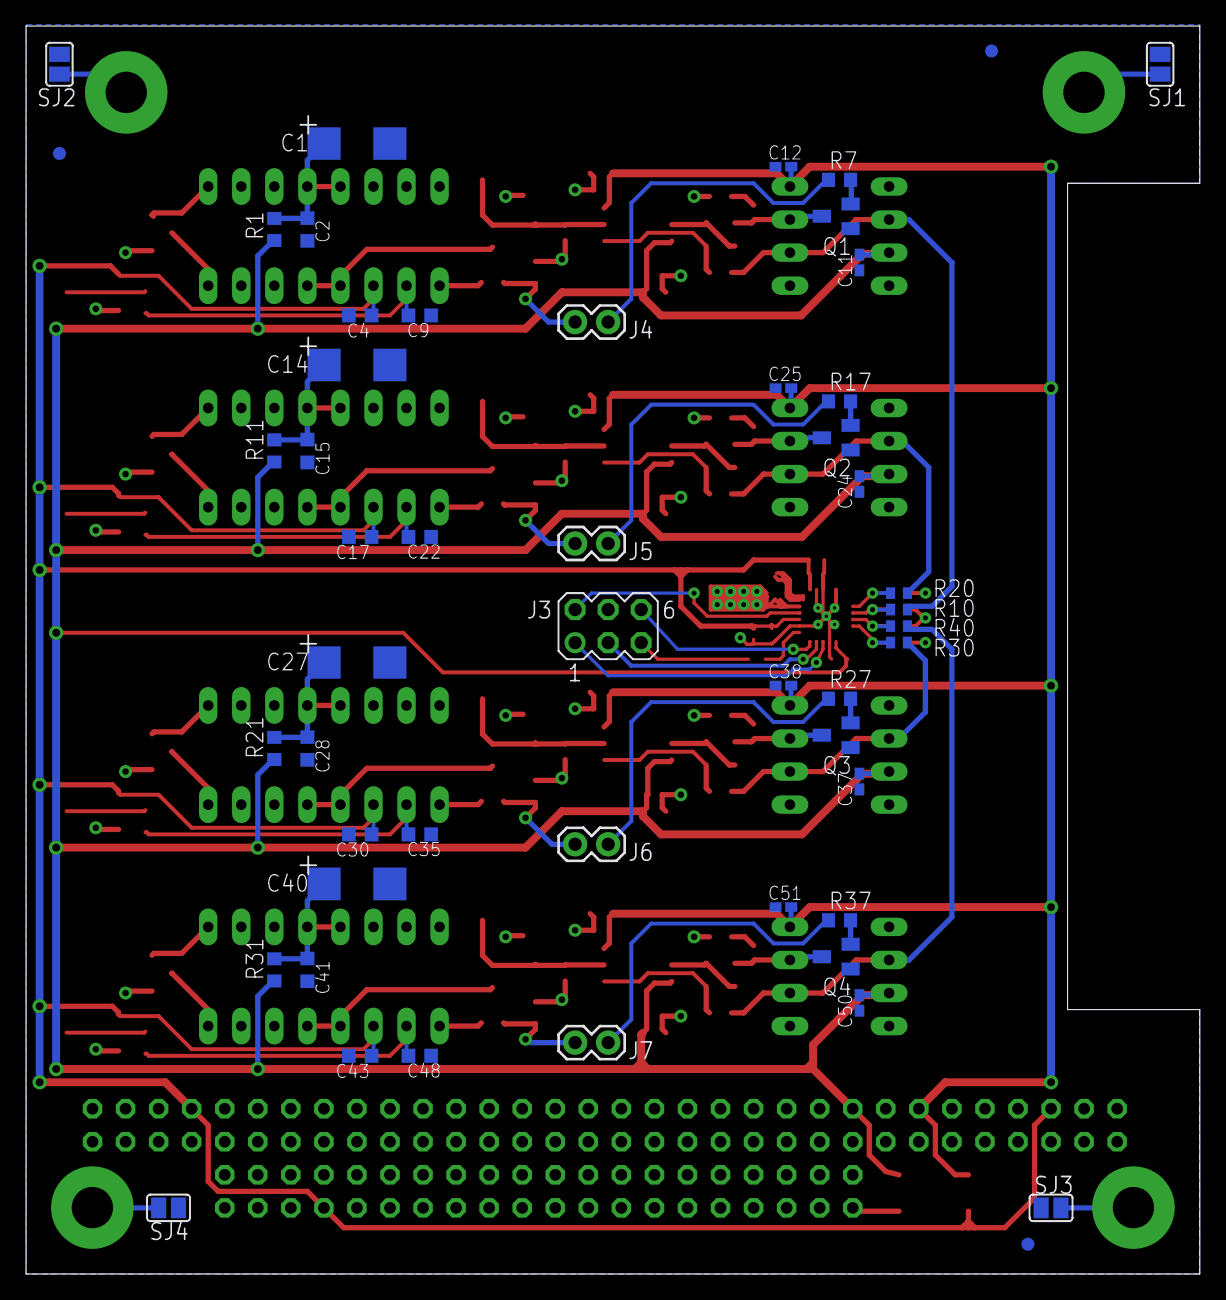
[picture p36: board UMN_HASP_2015_Front_End_Board2.brd from below]

Board: 2 copper layers, 90.2 x 95.9 mm, 156 parts (52 on the bottom side), 79 nets.
