HASP-UMN/2015/Hardware/TPP/UMN_HASP_2015_Photon_Preprocessor.brd

## EAGLE design Hardware/TPP/UMN_HASP_2015_Photon_Preprocessor.brd (2015-06-22)

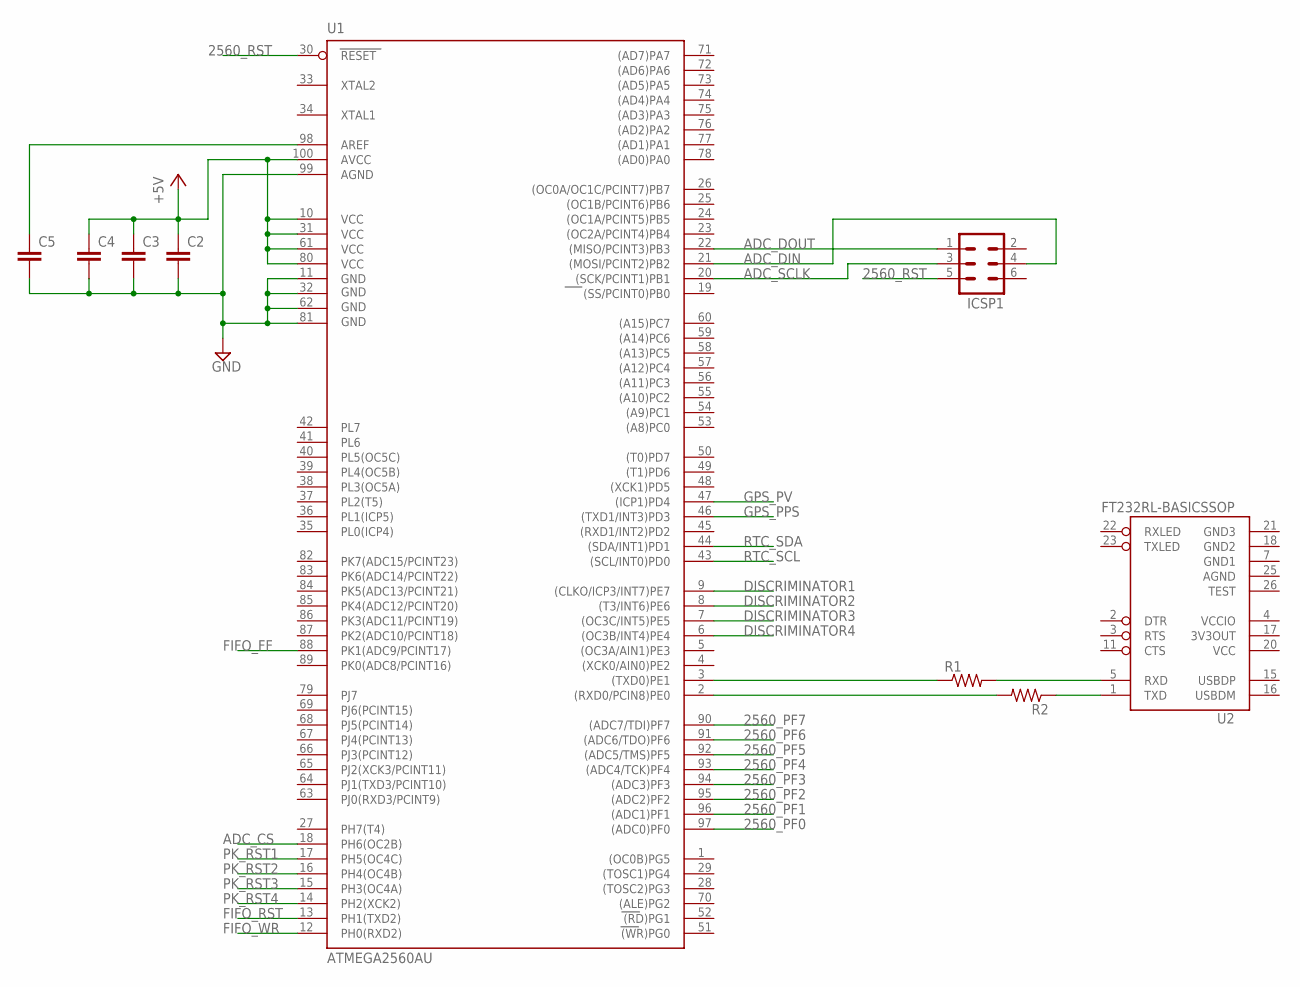
[picture p37: schematic UMN_HASP_2015_Photon_Preprocessor.sch, sheet 1, ATmega2560]

Parts:
C2, C3, C4, C5: C-EUC0603K; C0603K
ICSP1: MA03-2
R1, R2: R-US_R0603; R0603
U1: ATMEGA2560AU; TQFP100
U2: FT232RL-BASICSSOP; SSOP28DB

Connections:
2560_PF0: U1.97 ((ADC0)PF0); also elsewhere on the board
2560_PF1: U1.96 ((ADC1)PF1); also elsewhere on the board
2560_PF2: U1.95 ((ADC2)PF2); also elsewhere on the board
2560_PF3: U1.94 ((ADC3)PF3); also elsewhere on the board
2560_PF4: U1.93 ((ADC4/TCK)PF4); also elsewhere on the board
2560_PF5: U1.92 ((ADC5/TMS)PF5); also elsewhere on the board
2560_PF6: U1.91 ((ADC6/TDO)PF6); also elsewhere on the board
2560_PF7: U1.90 ((ADC7/TDI)PF7); also elsewhere on the board
2560_RST: ICSP1.5, U1.30 (RESET)
+5V: C2.1, C3.1, C4.1, U1.10 (VCC), U1.31 (VCC1), U1.61 (VCC2), U1.80 (VCC3), U1.100 (AVCC); also elsewhere on the board
ADC_CS: U1.18 (PH6(OC2B)); also elsewhere on the board
ADC_DIN: ICSP1.4, U1.21 ((MOSI/PCINT2)PB2); also elsewhere on the board
ADC_DOUT: ICSP1.1, U1.22 ((MISO/PCINT3)PB3); also elsewhere on the board
ADC_SCLK: ICSP1.3, U1.20 ((SCK/PCINT1)PB1); also elsewhere on the board
AGND: U2.25 (AGND)
DISCRIMINATOR1: U1.9 ((CLKO/ICP3/INT7)PE7); also elsewhere on the board
DISCRIMINATOR2: U1.8 ((T3/INT6)PE6); also elsewhere on the board
DISCRIMINATOR3: U1.7 ((OC3C/INT5)PE5); also elsewhere on the board
DISCRIMINATOR4: U1.6 ((OC3B/INT4)PE4); also elsewhere on the board
FIFO_FF: U1.88 (PK1(ADC9/PCINT17)); also elsewhere on the board
FIFO_RST: U1.13 (PH1(TXD2)); also elsewhere on the board
FIFO_WR: U1.12 (PH0(RXD2)); also elsewhere on the board
GND: C2.2, C3.2, C4.2, C5.2, U1.11 (GND), U1.32 (GND1), U1.62 (GND2), U1.81 (GND3), U1.99 (AGND); also elsewhere on the board
GND1: U2.7 (GND1)
GND2: U2.18 (GND2)
GND3: U2.21 (GND3)
GPS_PPS: U1.46 ((TXD1/INT3)PD3); also elsewhere on the board
GPS_PV: U1.47 ((ICP1)PD4); also elsewhere on the board
unnamed: R2.1, U2.1 (TXD)
unnamed: R1.2, U2.5 (RXD)
unnamed: C5.1, U1.98 (AREF)
unnamed: R2.2, U1.2 ((RXD0/PCIN8)PE0)
unnamed: R1.1, U1.3 ((TXD0)PE1)
PK_RST1: U1.17 (PH5(OC4C)); also elsewhere on the board
PK_RST2: U1.16 (PH4(OC4B)); also elsewhere on the board
PK_RST3: U1.15 (PH3(OC4A)); also elsewhere on the board
PK_RST4: U1.14 (PH2(XCK2)); also elsewhere on the board
RTC_SCL: U1.43 ((SCL/INT0)PD0); also elsewhere on the board
RTC_SDA: U1.44 ((SDA/INT1)PD1); also elsewhere on the board
VCC: U2.20 (VCC); also elsewhere on the board
VCCIO: U2.4 (VCCIO)

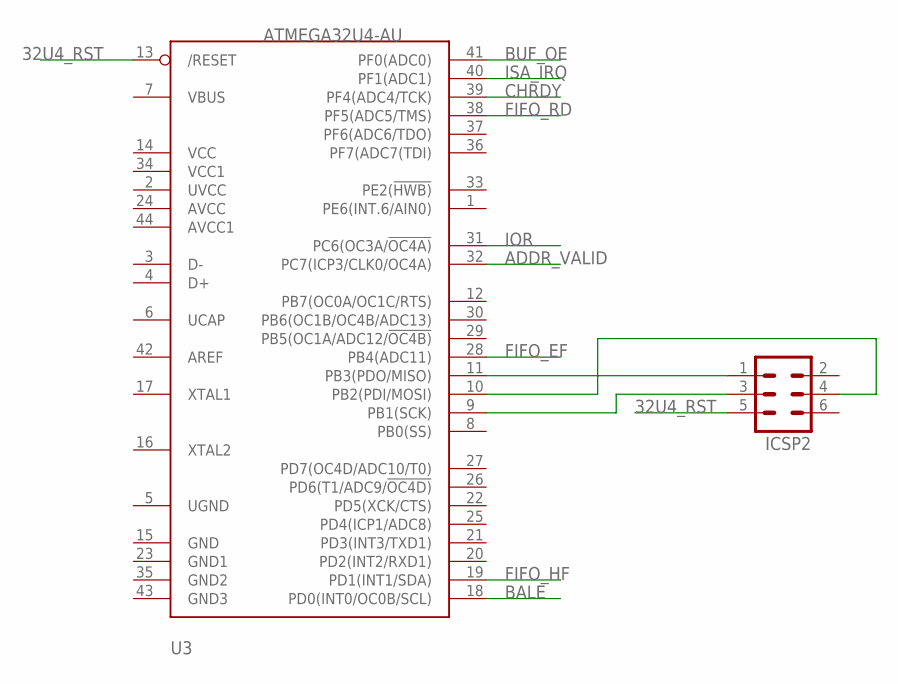
[picture p38: schematic UMN_HASP_2015_Photon_Preprocessor.sch, sheet 2, ATmega32u4]

Parts:
ICSP2: MA03-2
U3: ATMEGA32U4-AU; TQFP44

Connections:
32U4_RST: ICSP2.5, U3.13 (/RESET)
ADDR_VALID: U3.32 (PC7(ICP3/CLK0/OC4A)); also elsewhere on the board
BALE: U3.18 (PD0(INT0/OC0B/SCL)); also elsewhere on the board
BUF_OE: U3.41 (PF0(ADC0)); also elsewhere on the board
CHRDY: U3.39 (PF4(ADC4/TCK)); also elsewhere on the board
FIFO_EF: U3.28 (PB4(ADC11)); also elsewhere on the board
FIFO_HF: U3.19 (PD1(INT1/SDA)); also elsewhere on the board
FIFO_RD: U3.38 (PF5(ADC5/TMS)); also elsewhere on the board
IOR: U3.31 (PC6(OC3A/!OC4A)); also elsewhere on the board
ISA_IRQ: U3.40 (PF1(ADC1)); also elsewhere on the board
unnamed: ICSP2.1, U3.11 (PB3(PDO/MISO))
unnamed: ICSP2.3, U3.9 (PB1(SCK))
unnamed: ICSP2.4, U3.10 (PB2(PDI/MOSI))

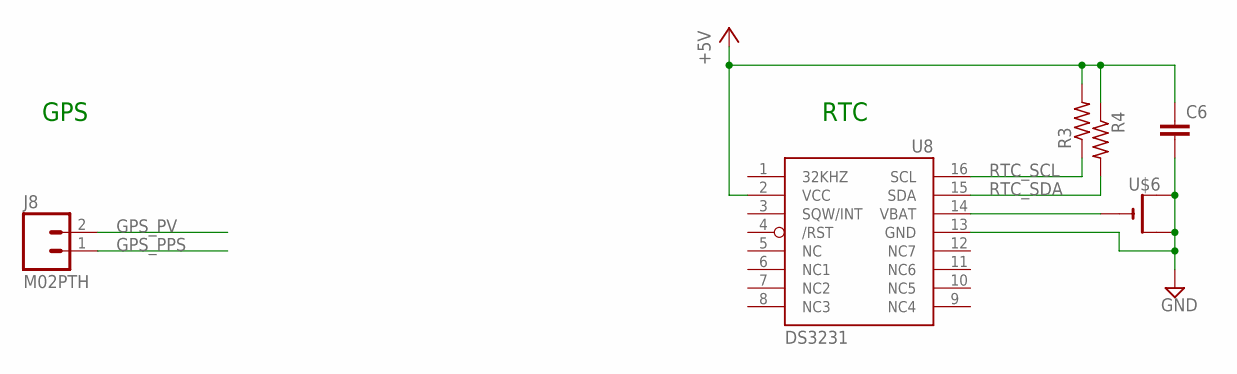
[picture p39: schematic UMN_HASP_2015_Photon_Preprocessor.sch, sheet 3, Timing]

Parts:
C6: C-EUC0603K; C0603K
J8: M02PTH; 1X02
R3, R4: R-US_R0603; R0603
U8: DS3231/SO; SO16W
U$6: CR1220SMT; CR1220-SMD

Connections:
+5V: C6.1, R3.2, R4.1, U8.2 (VCC); also elsewhere on the board
GND: C6.2, U8.13 (GND), U$6.+$1 (+), U$6.+$2 (+1); also elsewhere on the board
GPS_PPS: J8.1; also elsewhere on the board
GPS_PV: J8.2; also elsewhere on the board
unnamed: U8.14 (VBAT), U$6.-
RTC_SCL: R3.1, U8.16 (SCL); also elsewhere on the board
RTC_SDA: R4.2, U8.15 (SDA); also elsewhere on the board

Notes on the sheet:
GPS
RTC
