HASP-UMN/2015/Hardware/TPP/UMN_HASP_2015_Photon_Preprocessor.brd

## EAGLE design Hardware/TPP/UMN_HASP_2015_Photon_Preprocessor.brd (continued)

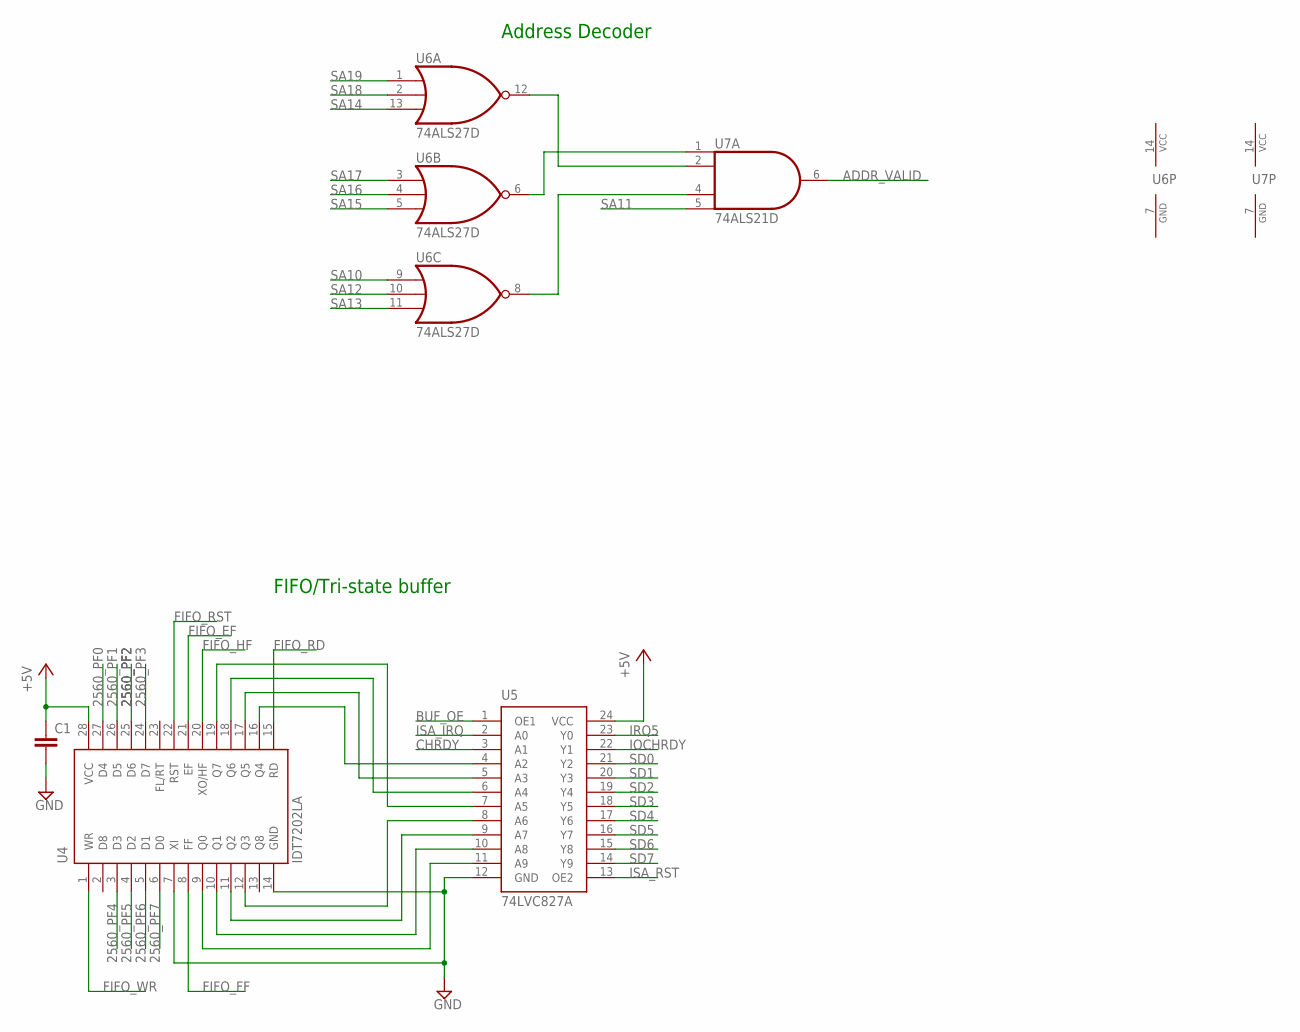
[picture p40: schematic UMN_HASP_2015_Photon_Preprocessor.sch, sheet 4, Logic]

Parts:
C1: C-EUC0603K; C0603K
U4: IDT7202LA; SO28W
U5: 74LVC827A; SO24W
U6: 74ALS27D; SO14
U7: 74ALS21D; SO14

Connections:
2560_PF0: U4.27 (D4); also elsewhere on the board
2560_PF1: U4.26 (D5); also elsewhere on the board
2560_PF2: U4.25 (D6); also elsewhere on the board
2560_PF3: U4.24 (D7); also elsewhere on the board
2560_PF4: U4.3 (D3); also elsewhere on the board
2560_PF5: U4.4 (D2); also elsewhere on the board
2560_PF6: U4.5 (D1); also elsewhere on the board
2560_PF7: U4.6 (D0); also elsewhere on the board
+5V: C1.1, U4.28 (VCC), U5.24 (VCC); also elsewhere on the board
ADDR_VALID: U7.6 (O); also elsewhere on the board
BUF_OE: U5.1 (OE1); also elsewhere on the board
CHRDY: U5.3 (A1); also elsewhere on the board
FIFO_EF: U4.21 (EF); also elsewhere on the board
FIFO_FF: U4.8 (FF); also elsewhere on the board
FIFO_HF: U4.20 (XO/HF); also elsewhere on the board
FIFO_RD: U4.15 (RD); also elsewhere on the board
FIFO_RST: U4.22 (RST); also elsewhere on the board
FIFO_WR: U4.1 (WR); also elsewhere on the board
GND: C1.2, U4.7 (XI), U4.14 (GND), U5.12 (GND), U6.7 (GND), U7.7 (GND); also elsewhere on the board
IOCHRDY: U5.22 (Y1); also elsewhere on the board
IRQ5: U5.23 (Y0); also elsewhere on the board
ISA_IRQ: U5.2 (A0); also elsewhere on the board
ISA_RST: U5.13 (OE2); also elsewhere on the board
unnamed: U6.12 (O), U7.2 (I1)
unnamed: U6.6 (O), U7.1 (I0)
unnamed: U6.8 (O), U7.4 (I2)
unnamed: U4.12 (Q3), U5.8 (A6)
unnamed: U4.11 (Q2), U5.9 (A7)
unnamed: U4.10 (Q1), U5.10 (A8)
unnamed: U4.9 (Q0), U5.11 (A9)
unnamed: U4.16 (Q4), U5.4 (A2)
unnamed: U4.19 (Q7), U5.7 (A5)
unnamed: U4.18 (Q6), U5.6 (A4)
unnamed: U4.17 (Q5), U5.5 (A3)
SA10: U6.9 (I0); also elsewhere on the board
SA11: U7.5 (I3); also elsewhere on the board
SA12: U6.10 (I1); also elsewhere on the board
SA13: U6.11 (I2); also elsewhere on the board
SA14: U6.13 (I2); also elsewhere on the board
SA15: U6.5 (I2); also elsewhere on the board
SA16: U6.4 (I1); also elsewhere on the board
SA17: U6.3 (I0); also elsewhere on the board
SA18: U6.2 (I1); also elsewhere on the board
SA19: U6.1 (I0); also elsewhere on the board
SD0: U5.21 (Y2); also elsewhere on the board
SD1: U5.20 (Y3); also elsewhere on the board
SD2: U5.19 (Y4); also elsewhere on the board
SD3: U5.18 (Y5); also elsewhere on the board
SD4: U5.17 (Y6); also elsewhere on the board
SD5: U5.16 (Y7); also elsewhere on the board
SD6: U5.15 (Y8); also elsewhere on the board
SD7: U5.14 (Y9); also elsewhere on the board
VCC: U6.14 (VCC), U7.14 (VCC); also elsewhere on the board

Notes on the sheet:
Address Decoder
FIFO/Tri-state buffer

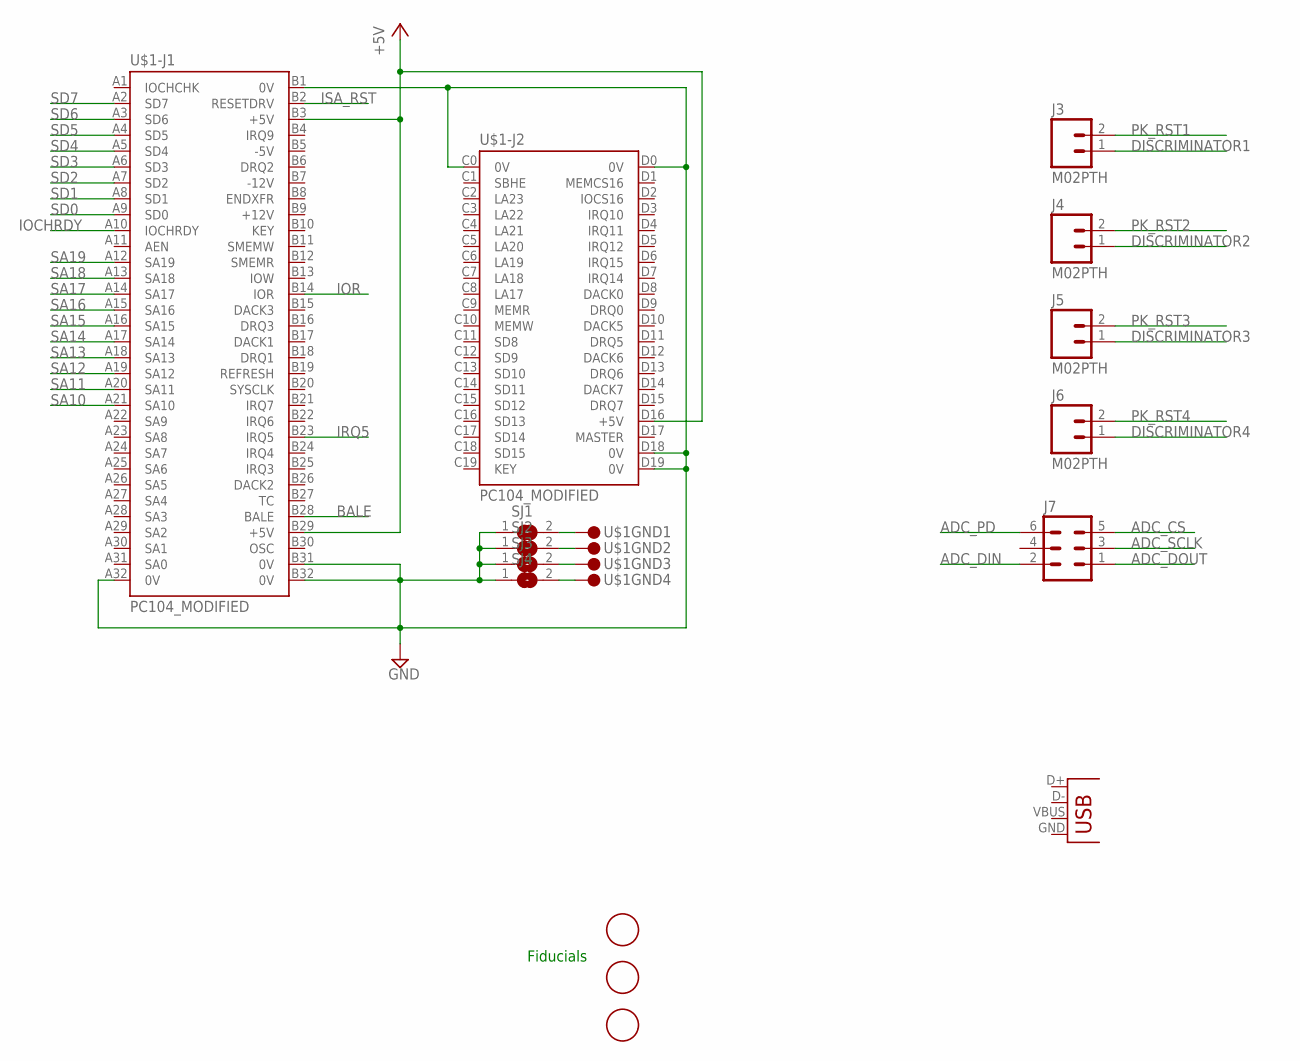
[picture p41: schematic UMN_HASP_2015_Photon_Preprocessor.sch, sheet 5, PC/104]

Parts:
J3, J4, J5, J6: M02PTH; 1X02
J7: MA03-2
JP5: USB-B; USB-B-PTH
SJ1, SJ2, SJ3, SJ4: SJ
U$1: PC104_MODIFIED
U$2, U$3, U$4: FIDUCIAL; FIDUCIAL_1MM

Connections:
+5V: U$1.B3 (+5V), U$1.B29 (+5V), U$1.D16 (+5V); also elsewhere on the board
ADC_CS: J7.5; also elsewhere on the board
ADC_DIN: J7.2; also elsewhere on the board
ADC_DOUT: J7.1; also elsewhere on the board
ADC_PD: J7.6
ADC_SCLK: J7.3; also elsewhere on the board
BALE: U$1.B28 (BALE); also elsewhere on the board
DISCRIMINATOR1: J3.1; also elsewhere on the board
DISCRIMINATOR2: J4.1; also elsewhere on the board
DISCRIMINATOR3: J5.1; also elsewhere on the board
DISCRIMINATOR4: J6.1; also elsewhere on the board
GND: SJ1.1, SJ2.1, SJ3.1, SJ4.1, U$1.A32 (0V), U$1.B1 (0V), U$1.B31 (0V), U$1.B32 (0V), U$1.C0 (0V), U$1.D0 (0V), U$1.D18 (0V), U$1.D19 (0V); also elsewhere on the board
IOCHRDY: U$1.A10 (IOCHRDY); also elsewhere on the board
IOR: U$1.B14 (IOR); also elsewhere on the board
IRQ5: U$1.B23 (IRQ5); also elsewhere on the board
ISA_RST: U$1.B2 (RESETDRV); also elsewhere on the board
unnamed: SJ1.2, U$1.GND@1 (1)
unnamed: SJ2.2, U$1.GND@2 (1)
unnamed: SJ3.2, U$1.GND@3 (1)
unnamed: SJ4.2, U$1.GND@4 (1)
PK_RST1: J3.2; also elsewhere on the board
PK_RST2: J4.2; also elsewhere on the board
PK_RST3: J5.2; also elsewhere on the board
PK_RST4: J6.2; also elsewhere on the board
SA10: U$1.A21 (SA10); also elsewhere on the board
SA11: U$1.A20 (SA11); also elsewhere on the board
SA12: U$1.A19 (SA12); also elsewhere on the board
SA13: U$1.A18 (SA13); also elsewhere on the board
SA14: U$1.A17 (SA14); also elsewhere on the board
SA15: U$1.A16 (SA15); also elsewhere on the board
SA16: U$1.A15 (SA16); also elsewhere on the board
SA17: U$1.A14 (SA17); also elsewhere on the board
SA18: U$1.A13 (SA18); also elsewhere on the board
SA19: U$1.A12 (SA19); also elsewhere on the board
SD0: U$1.A9 (SD0); also elsewhere on the board
SD1: U$1.A8 (SD1); also elsewhere on the board
SD2: U$1.A7 (SD2); also elsewhere on the board
SD3: U$1.A6 (SD3); also elsewhere on the board
SD4: U$1.A5 (SD4); also elsewhere on the board
SD5: U$1.A4 (SD5); also elsewhere on the board
SD6: U$1.A3 (SD6); also elsewhere on the board
SD7: U$1.A2 (SD7); also elsewhere on the board

Notes on the sheet:
Fiducials

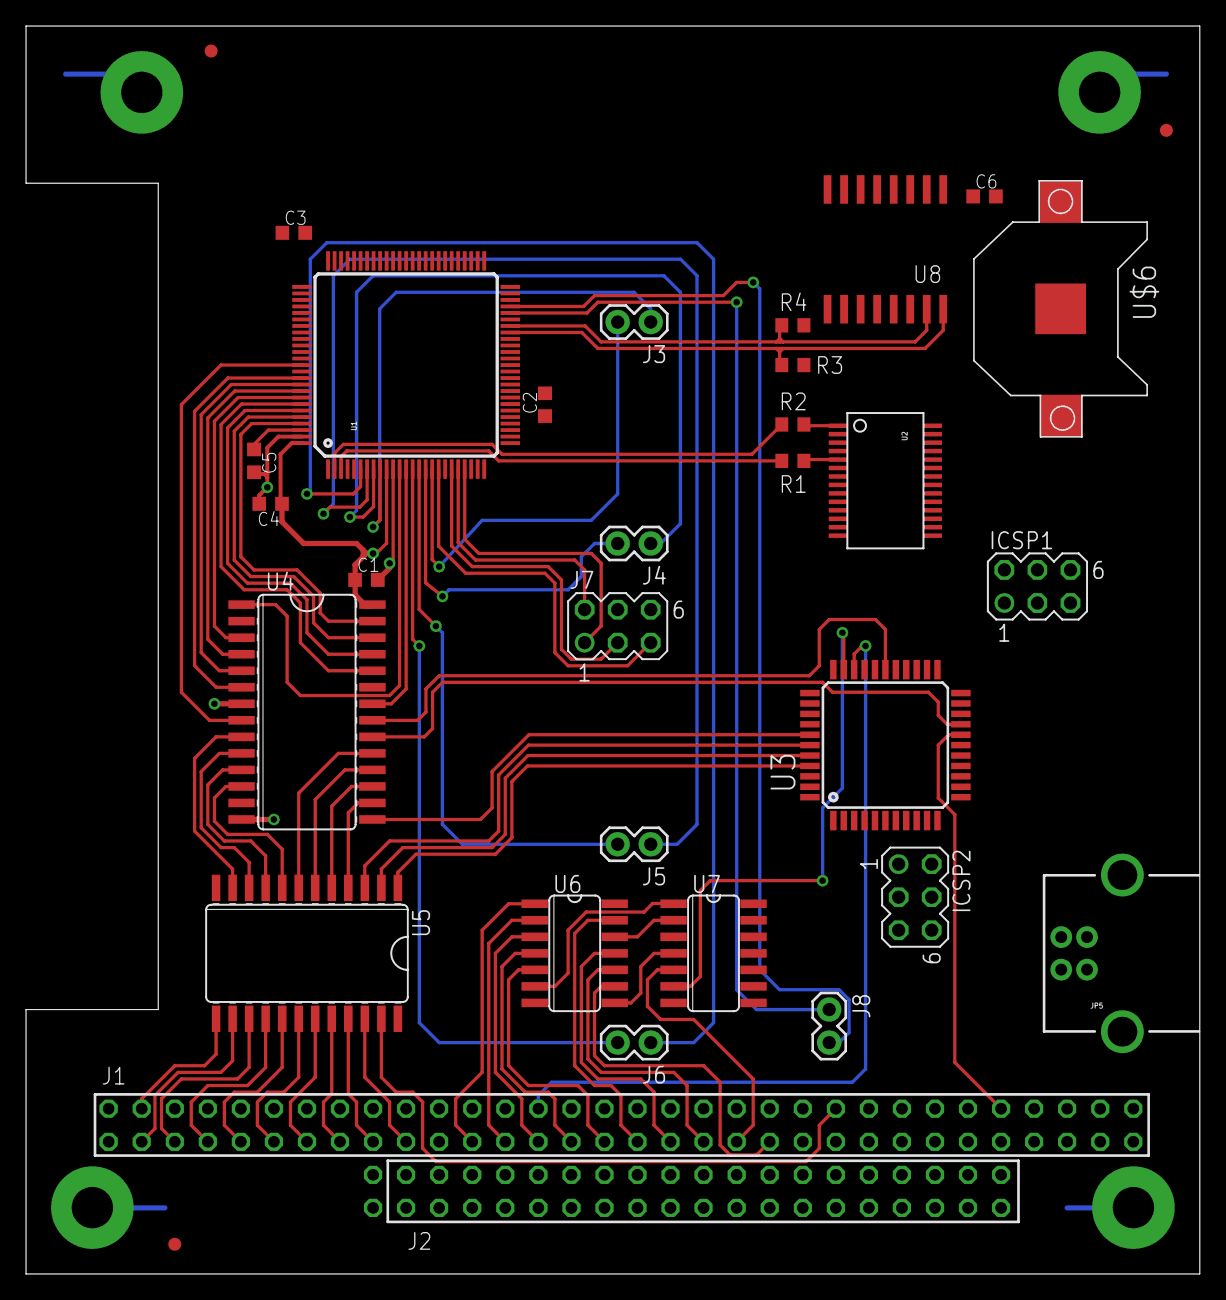
[picture p42: board UMN_HASP_2015_Photon_Preprocessor.brd from above]

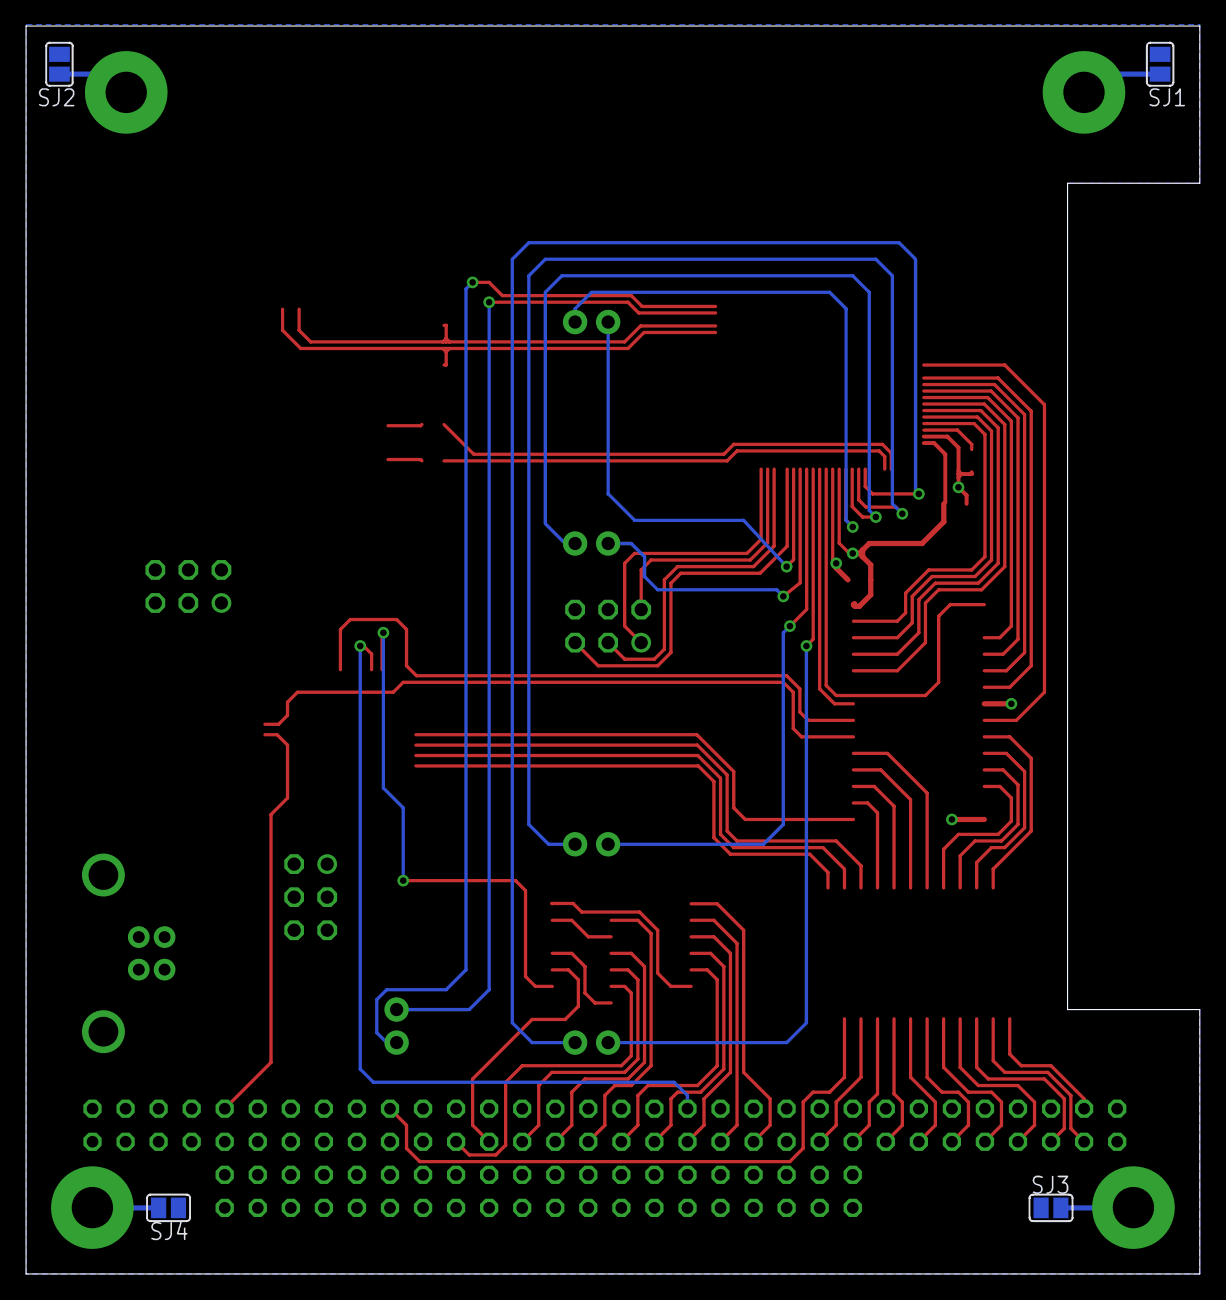
[picture p43: board UMN_HASP_2015_Photon_Preprocessor.brd from below]

Board: 2 copper layers, 90.2 x 95.9 mm, 36 parts (4 on the bottom side), 86 nets.
