HASP-UMN/2015/Hardware/Detector Front End/UMN_HASP_2015_Front_End_Board1.brd

## EAGLE design Hardware/Detector Front End/UMN_HASP_2015_Front_End_Board1.brd (2015-06-22)

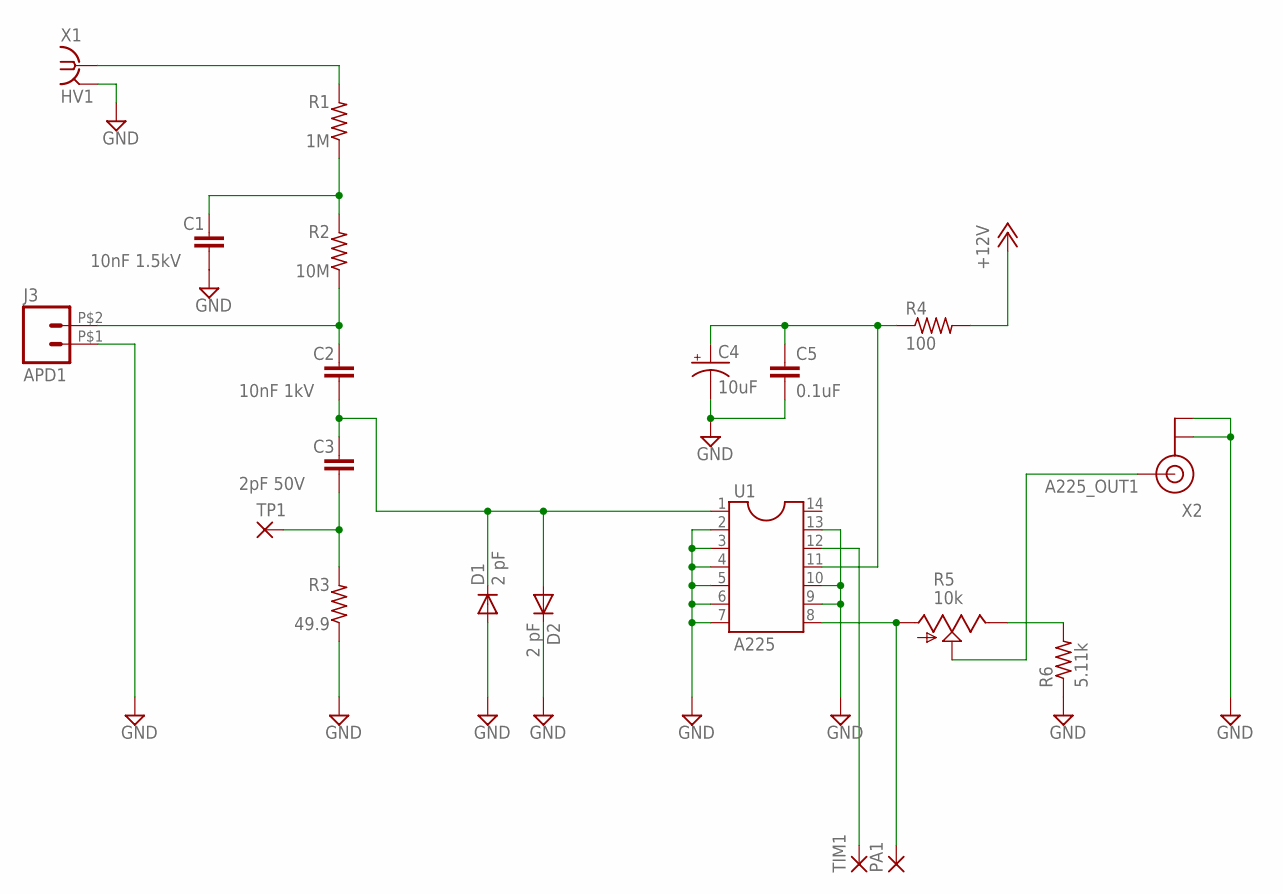
[picture p44: schematic UMN_HASP_2015_Front_End_Board1.sch, sheet 1, Channel 1]

Parts:
C1: 10nF 1.5kV; C1206K
C2: 10nF 1kV; C050-050X075
C3: 2pF 50V; C0402
C4: 10uF; C/6032-28R
C5: 0.1uF; C0603K
D1, D2: 2 pF; SOD323-R
J3: M02PTH2; 1X02_BIG
PA1: WIREPADSMD1,27-254; SMD1,27-2,54
R1: 1M; R1206
R2: 10M; R1206
R3: 49.9; R0603
R4: 100; R0603
R5: 10k; 3223J
R6: 5.11k; R0603
TIM1: WIREPADSMD1,27-254; SMD1,27-2,54
TP1: WIREPADSMD1,27-254; SMD1,27-2,54
U1: A225; SOCKET-14
X1: HV1; BU-SMA-V
X2: U.FL

Connections:
+12V: R4.2; also elsewhere on the board
A225_OUT1: R5.2 (S), X2.P$3 (SIGNAL)
APD1: C2.1, J3.P$2 (2), R2.1
GND: C1.2, C4.-, C5.2, D1.A, D2.C, J3.P$1 (1), R3.1, R6.1, U1.2, U1.3, U1.4, U1.5, U1.6, U1.7, U1.9, U1.10, U1.13, X1.2 (GND), X1.3 (GND), X1.4 (GND), X1.5 (GND), X2.P$1 (GND), X2.P$2 (GND); also elsewhere on the board
HV1: R1.2, X1.1
unnamed: C1.1, R1.1, R2.2
unnamed: C2.2, C3.1, D1.C, D2.A, U1.1
unnamed: R5.3 (E), R6.2
unnamed: C4.+, C5.1, R4.1, U1.11
PREAMPOUT1: PA1.1, R5.1 (A), U1.8
TIMING1: TIM1.1, U1.12
TP1: C3.2, R3.2, TP1.1

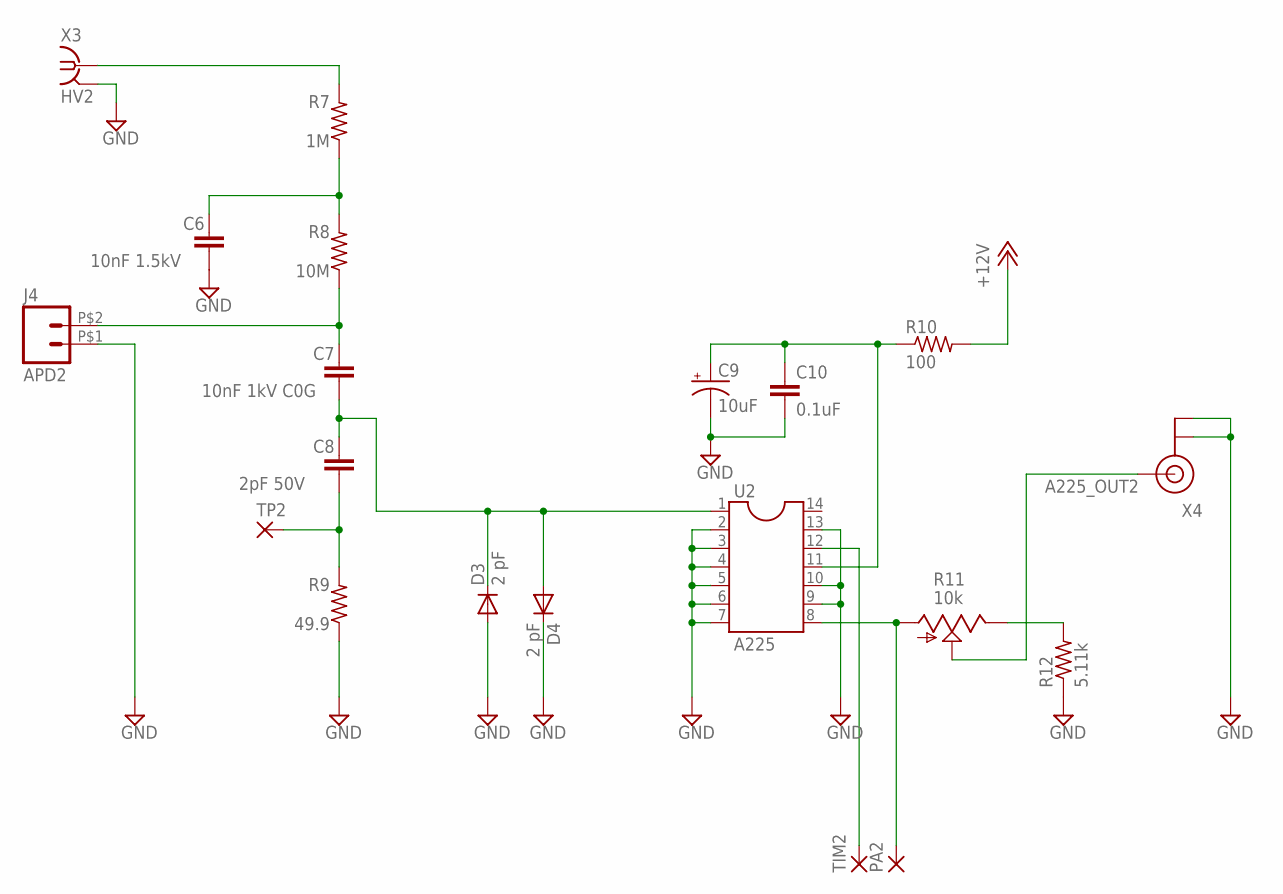
[picture p45: schematic UMN_HASP_2015_Front_End_Board1.sch, sheet 2, Channel 2]

Parts:
C6: 10nF 1.5kV; C1206K
C7: 10nF 1kV C0G; C050-050X075
C8: 2pF 50V; C0402
C9: 10uF; C/6032-28R
C10: 0.1uF; C0603K
D3, D4: 2 pF; SOD323-R
J4: M02PTH2; 1X02_BIG
PA2: WIREPADSMD1,27-254; SMD1,27-2,54
R7: 1M; R1206
R8: 10M; R1206
R9: 49.9; R0603
R10: 100; R0603
R11: 10k; 3223J
R12: 5.11k; R0603
TIM2: WIREPADSMD1,27-254; SMD1,27-2,54
TP2: WIREPADSMD1,27-254; SMD1,27-2,54
U2: A225; SOCKET-14
X3: HV2; BU-SMA-V
X4: U.FL

Connections:
+12V: R10.2; also elsewhere on the board
A225_OUT2: R11.2 (S), X4.P$3 (SIGNAL)
APD2: C7.1, J4.P$2 (2), R8.1
GND: C6.2, C9.-, C10.2, D3.A, D4.C, J4.P$1 (1), R9.1, R12.1, U2.2, U2.3, U2.4, U2.5, U2.6, U2.7, U2.9, U2.10, U2.13, X3.2 (GND), X3.3 (GND), X3.4 (GND), X3.5 (GND), X4.P$1 (GND), X4.P$2 (GND); also elsewhere on the board
HV2: R7.2, X3.1
unnamed: C9.+, C10.1, R10.1, U2.11
unnamed: C6.1, R7.1, R8.2
unnamed: C7.2, C8.1, D3.C, D4.A, U2.1
unnamed: R11.3 (E), R12.2
PREAMPOUT2: PA2.1, R11.1 (A), U2.8
TIMING2: TIM2.1, U2.12
TP2: C8.2, R9.2, TP2.1

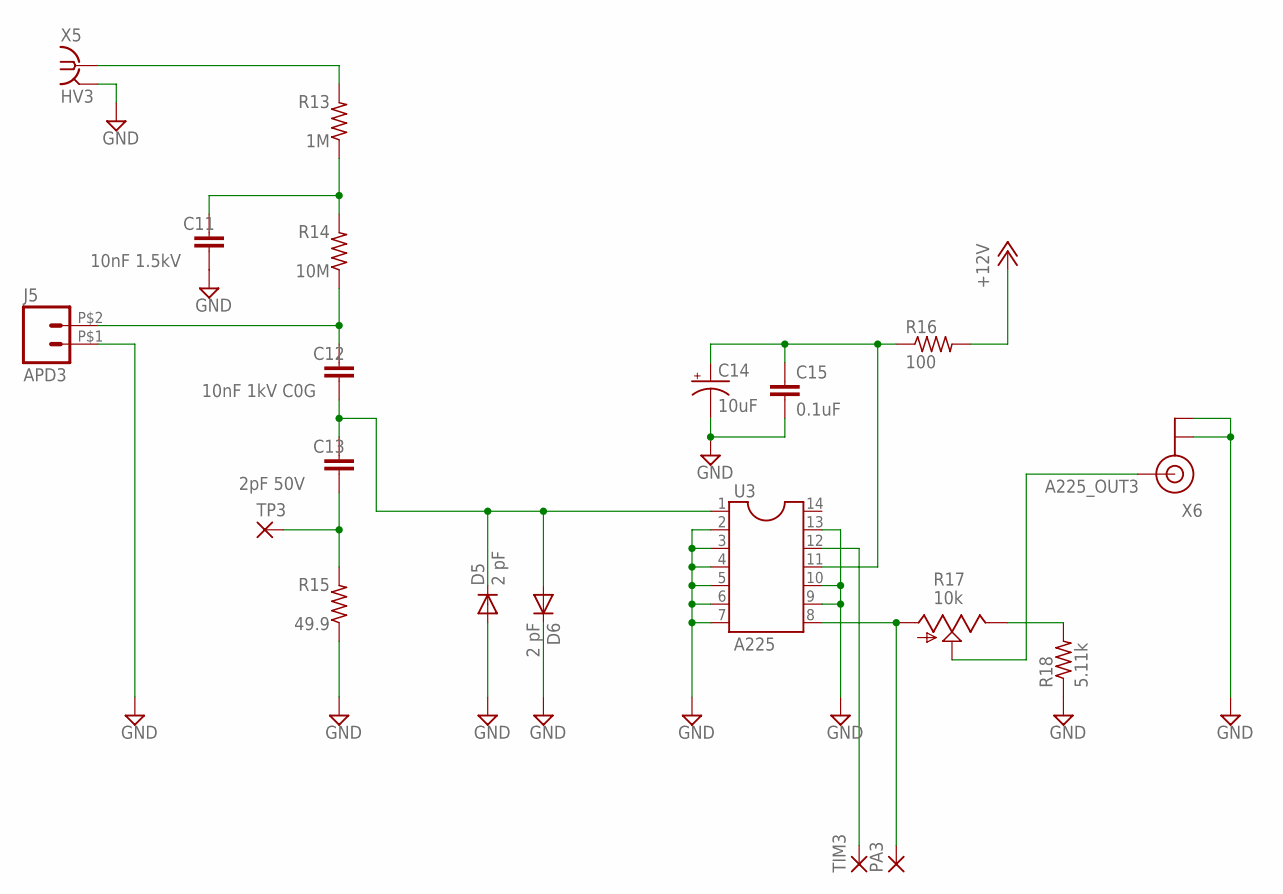
[picture p46: schematic UMN_HASP_2015_Front_End_Board1.sch, sheet 3, Channel 3]

Parts:
C11: 10nF 1.5kV; C1206K
C12: 10nF 1kV C0G; C050-050X075
C13: 2pF 50V; C0402
C14: 10uF; C/6032-28R
C15: 0.1uF; C0603K
D5, D6: 2 pF; SOD323-R
J5: M02PTH2; 1X02_BIG
PA3: WIREPADSMD1,27-254; SMD1,27-2,54
R13: 1M; R1206
R14: 10M; R1206
R15: 49.9; R0603
R16: 100; R0603
R17: 10k; 3223J
R18: 5.11k; R0603
TIM3: WIREPADSMD1,27-254; SMD1,27-2,54
TP3: WIREPADSMD1,27-254; SMD1,27-2,54
U3: A225; SOCKET-14
X5: HV3; BU-SMA-V
X6: U.FL

Connections:
+12V: R16.2; also elsewhere on the board
A225_OUT3: R17.2 (S), X6.P$3 (SIGNAL)
APD3: C12.1, J5.P$2 (2), R14.1
GND: C11.2, C14.-, C15.2, D5.A, D6.C, J5.P$1 (1), R15.1, R18.1, U3.2, U3.3, U3.4, U3.5, U3.6, U3.7, U3.9, U3.10, U3.13, X5.2 (GND), X5.3 (GND), X5.4 (GND), X5.5 (GND), X6.P$1 (GND), X6.P$2 (GND); also elsewhere on the board
HV3: R13.2, X5.1
unnamed: C11.1, R13.1, R14.2
unnamed: C12.2, C13.1, D5.C, D6.A, U3.1
unnamed: R17.3 (E), R18.2
unnamed: C14.+, C15.1, R16.1, U3.11
PREAMPOUT3: PA3.1, R17.1 (A), U3.8
TIMING3: TIM3.1, U3.12
TP3: C13.2, R15.2, TP3.1

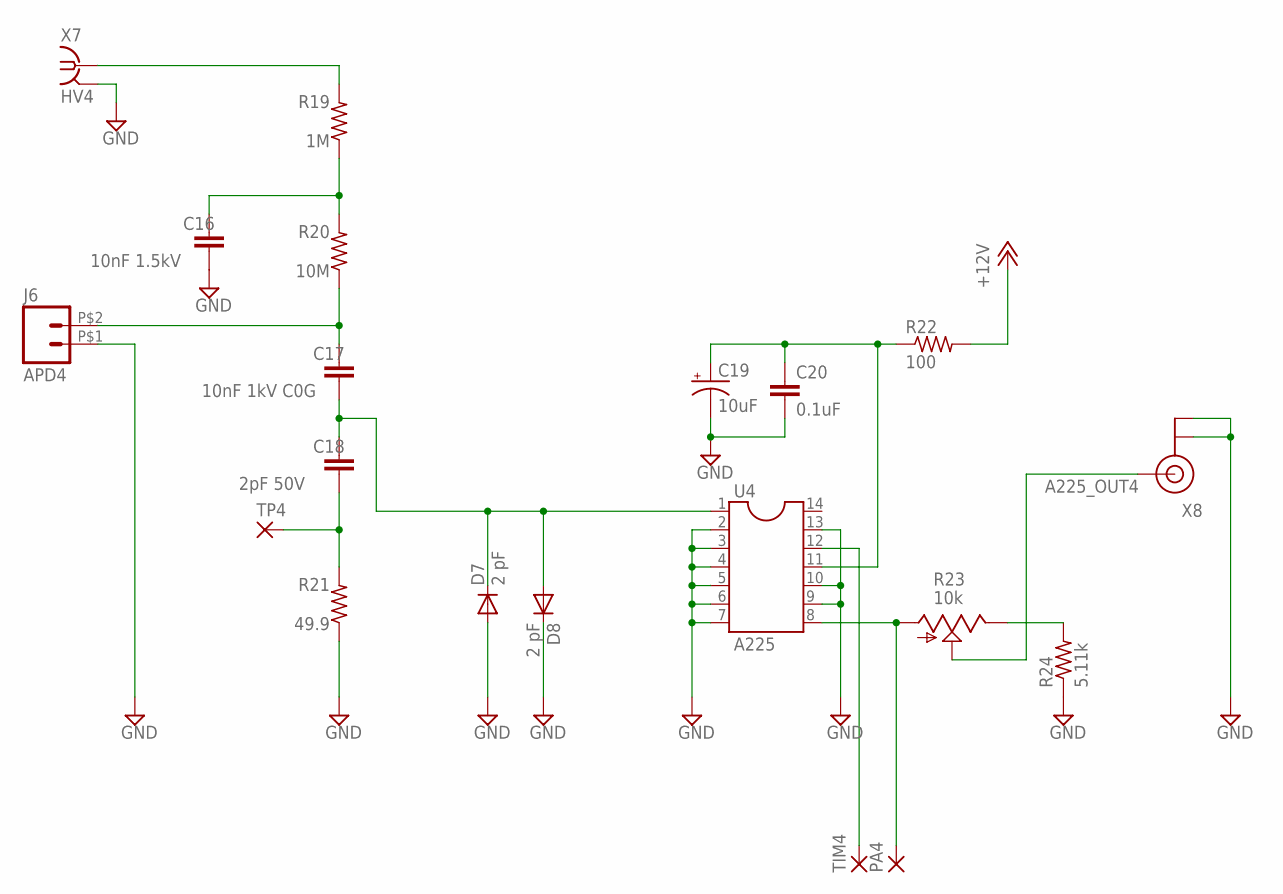
[picture p47: schematic UMN_HASP_2015_Front_End_Board1.sch, sheet 4, Channel 4]

Parts:
C16: 10nF 1.5kV; C1206K
C17: 10nF 1kV C0G; C050-050X075
C18: 2pF 50V; C0402
C19: 10uF; C/6032-28R
C20: 0.1uF; C0603K
D7, D8: 2 pF; SOD323-R
J6: M02PTH2; 1X02_BIG
PA4: WIREPADSMD1,27-254; SMD1,27-2,54
R19: 1M; R1206
R20: 10M; R1206
R21: 49.9; R0603
R22: 100; R0603
R23: 10k; 3223J
R24: 5.11k; R0603
TIM4: WIREPADSMD1,27-254; SMD1,27-2,54
TP4: WIREPADSMD1,27-254; SMD1,27-2,54
U4: A225; SOCKET-14
X7: HV4; BU-SMA-V
X8: U.FL

Connections:
+12V: R22.2; also elsewhere on the board
A225_OUT4: R23.2 (S), X8.P$3 (SIGNAL)
APD4: C17.1, J6.P$2 (2), R20.1
GND: C16.2, C19.-, C20.2, D7.A, D8.C, J6.P$1 (1), R21.1, R24.1, U4.2, U4.3, U4.4, U4.5, U4.6, U4.7, U4.9, U4.10, U4.13, X7.2 (GND), X7.3 (GND), X7.4 (GND), X7.5 (GND), X8.P$1 (GND), X8.P$2 (GND); also elsewhere on the board
HV4: R19.2, X7.1
unnamed: C19.+, C20.1, R22.1, U4.11
unnamed: C16.1, R19.1, R20.2
unnamed: C17.2, C18.1, D7.C, D8.A, U4.1
unnamed: R23.3 (E), R24.2
PREAMPOUT4: PA4.1, R23.1 (A), U4.8
TIMING4: TIM4.1, U4.12
TP4: C18.2, R21.2, TP4.1

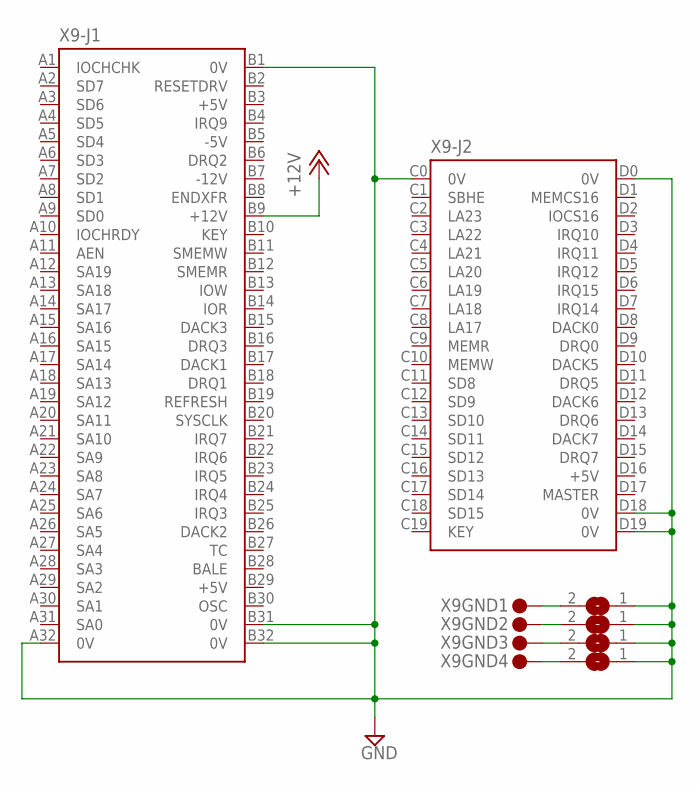
[picture p48: schematic UMN_HASP_2015_Front_End_Board1.sch, sheet 5, PC/104]

Parts:
SJ1, SJ2, SJ3, SJ4: SJ
X9: PC104_STANDARD1; PC104-STANDARD

Connections:
+12V: X9.B9 (+12V); also elsewhere on the board
GND: SJ1.1, SJ2.1, SJ3.1, SJ4.1, X9.A32 (0V), X9.B1 (0V), X9.B31 (0V), X9.B32 (0V), X9.C0 (0V), X9.D0 (0V), X9.D18 (0V), X9.D19 (0V); also elsewhere on the board
unnamed: SJ4.2, X9.GND@4 (1)
unnamed: SJ3.2, X9.GND@3 (1)
unnamed: SJ2.2, X9.GND@2 (1)
unnamed: SJ1.2, X9.GND@1 (1)

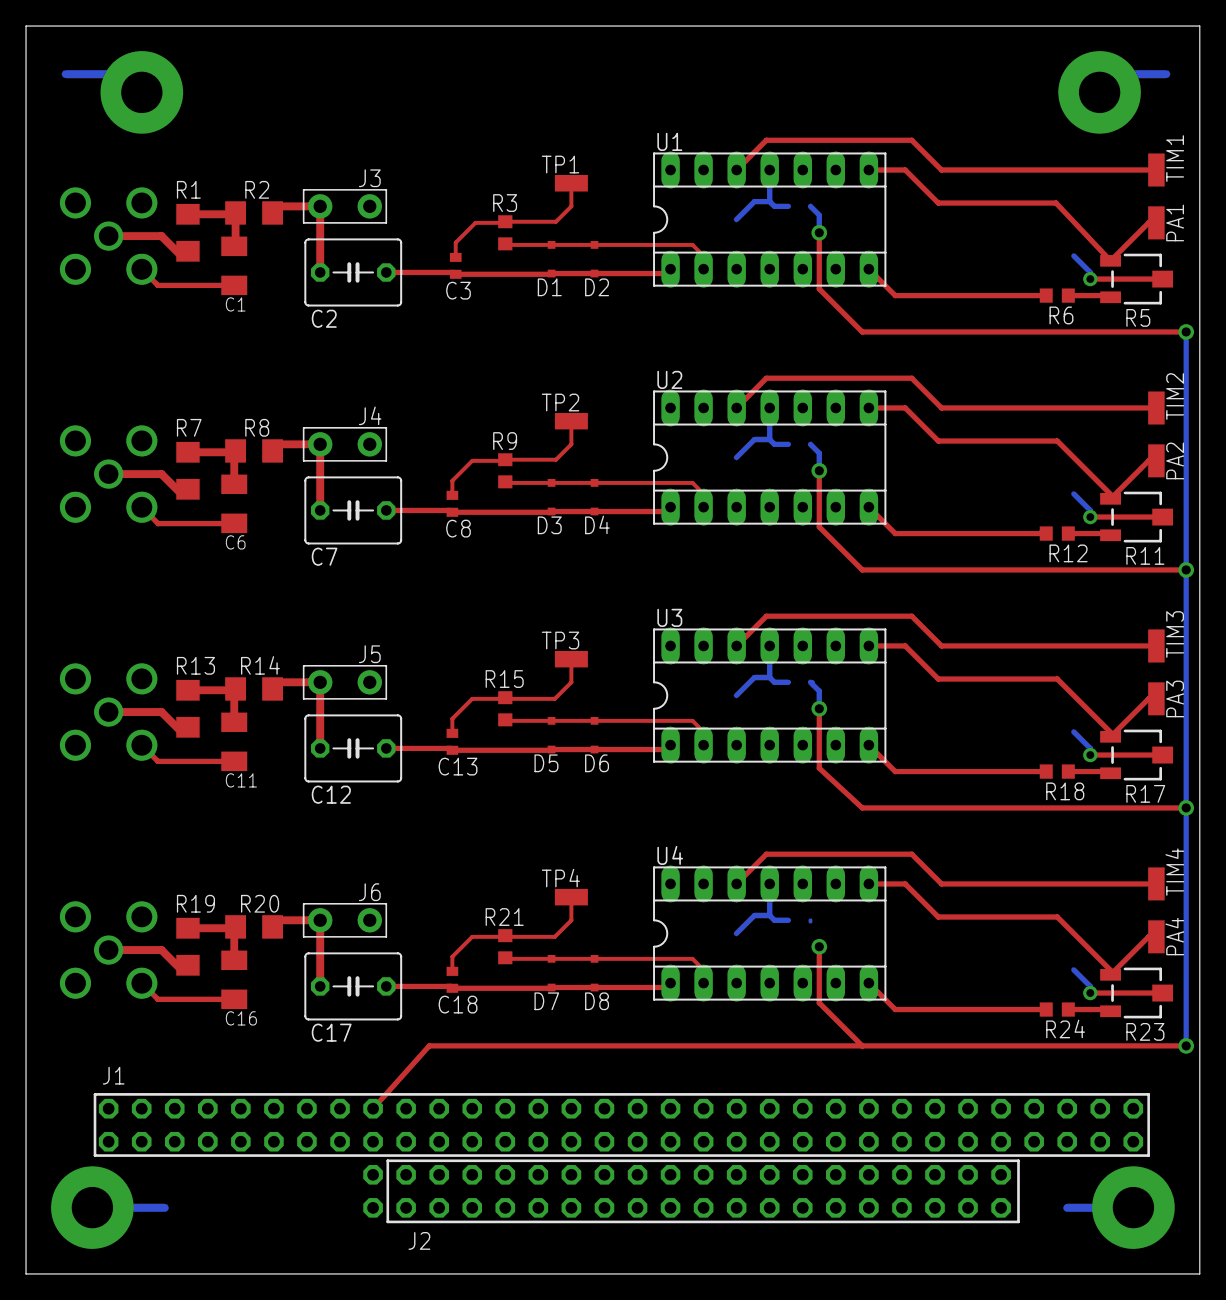
[picture p49: board UMN_HASP_2015_Front_End_Board1.brd from above]

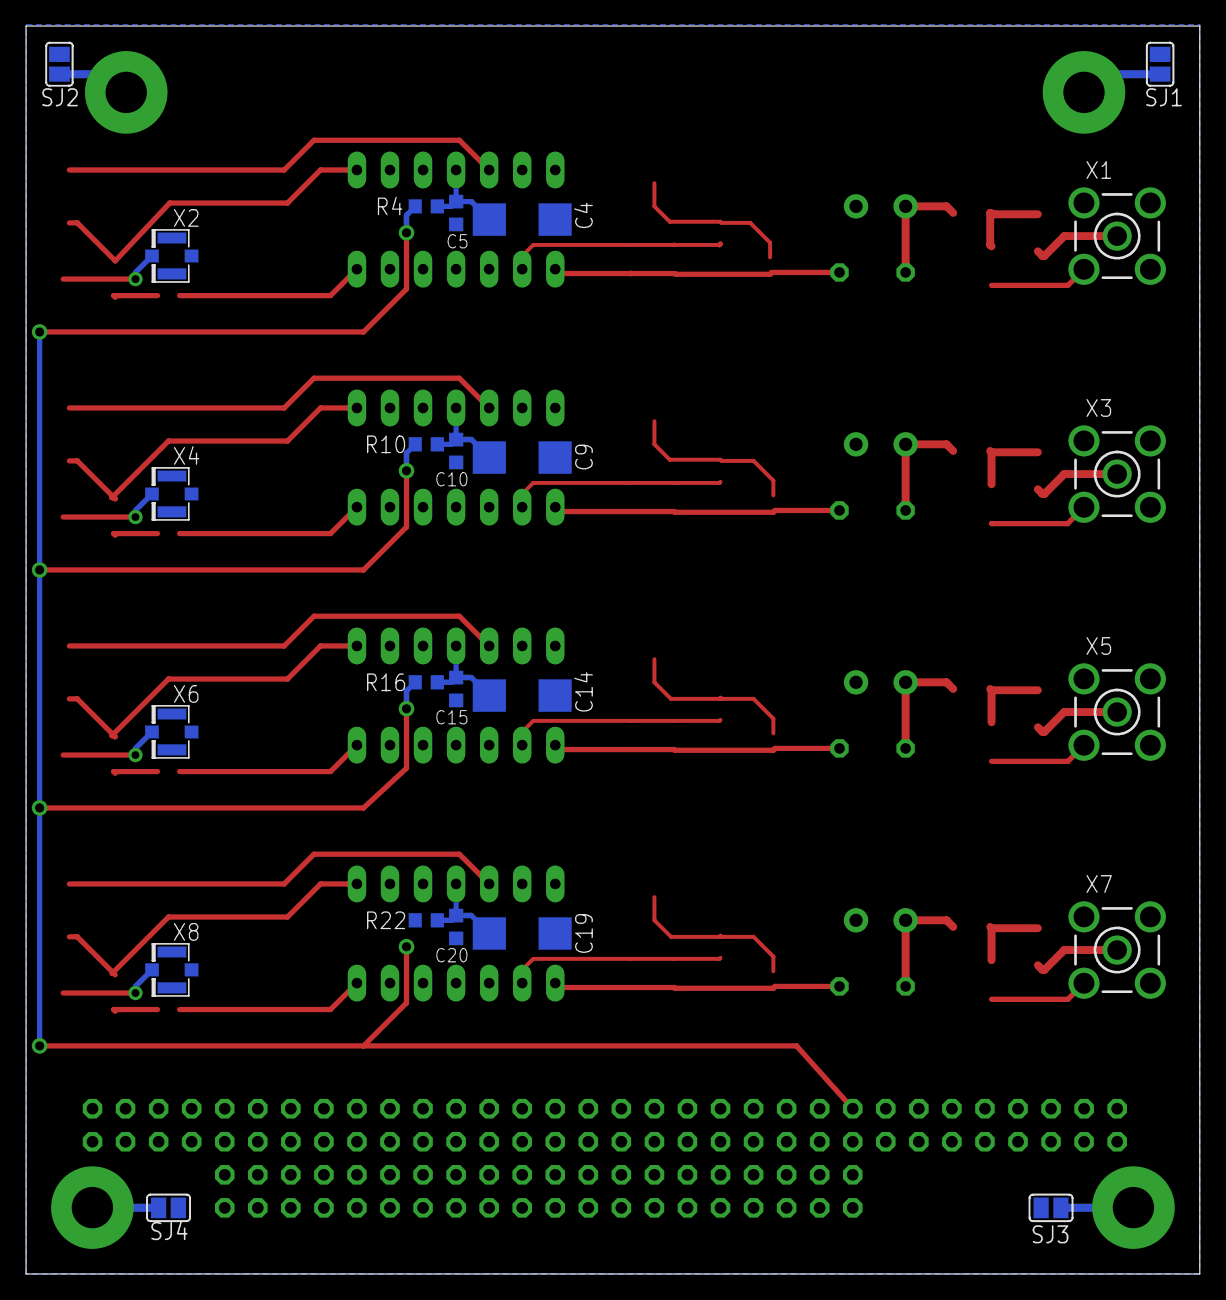
[picture p50: board UMN_HASP_2015_Front_End_Board1.brd from below]

Board: 2 copper layers, 90.2 x 95.9 mm, 85 parts (24 on the bottom side), 46 nets.
