HASP-UMN/2015/Hardware/GNSS-IMU/UMN_HASP_2015_GPS-IMU_Board.brd

## EAGLE design Hardware/GNSS-IMU/UMN_HASP_2015_GPS-IMU_Board.brd (2015-06-22)

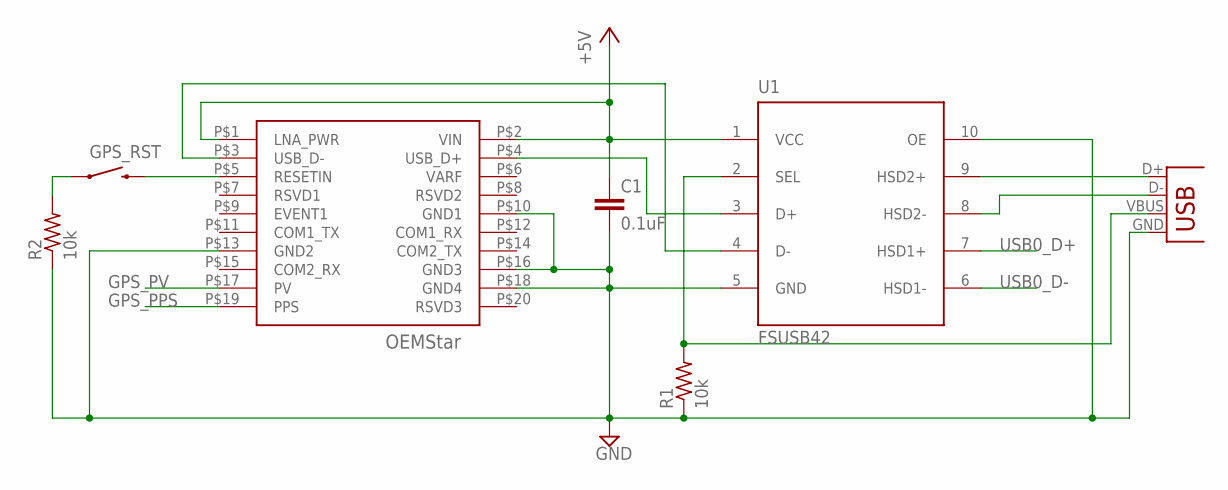
[picture p51: schematic UMN_HASP_2015_GPS-IMU_Board.sch, sheet 1, GPS]

Parts:
C1: 0.1uF; C1206K
GPS_RST: SWITCH-MOMENTARY-2PTH; TACTILE-PTH
J6: USB-B; USB-B-PTH
R1, R2: 10k; R1206
U1: FSUSB42; MSOP10
U$2: OEMSTAR

Connections:
+5V: C1.1, U1.1 (VCC), U$2.P$1 (LNA_PWR), U$2.P$2 (VIN); also elsewhere on the board
GND: C1.2, J6.GND, R1.1, R2.1, U1.5 (GND), U1.10 (OE), U$2.P$10 (GND1), U$2.P$13 (GND2), U$2.P$16 (GND3), U$2.P$18 (GND4); also elsewhere on the board
GPS_PPS: U$2.P$19 (PPS); also elsewhere on the board
GPS_PV: U$2.P$17 (PV); also elsewhere on the board
unnamed: GPS_RST.1, R2.2
unnamed: J6.D-, U1.8 (HSD2-)
unnamed: J6.VBUS, R1.2, U1.2 (SEL)
unnamed: GPS_RST.3 (2), U$2.P$5 (RESETIN)
unnamed: U1.3 (D+), U$2.P$4 (USB_D+)
unnamed: U1.4 (D-), U$2.P$3 (USB_D-)
unnamed: J6.D+, U1.9 (HSD2+)
USB0_D+: U1.7 (HSD1+); also elsewhere on the board
USB0_D-: U1.6 (HSD1-); also elsewhere on the board

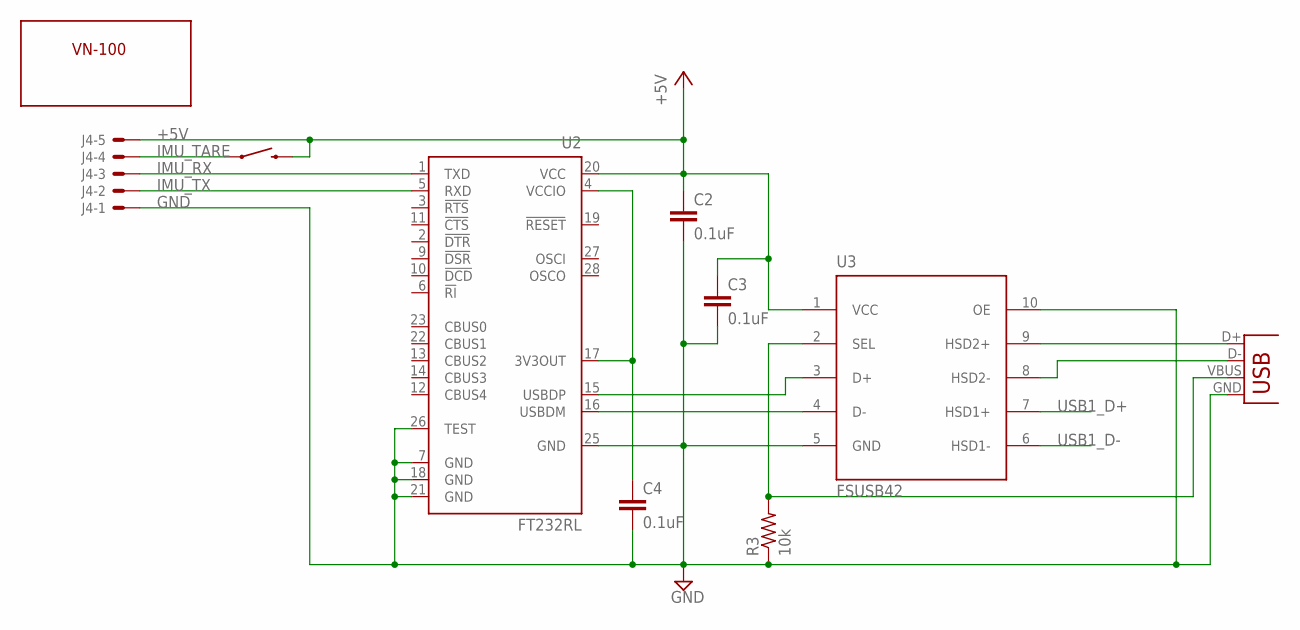
[picture p52: schematic UMN_HASP_2015_GPS-IMU_Board.sch, sheet 2, IMU]

Parts:
C2, C3, C4: 0.1uF; C1206K
IMU_TARE: SWITCH-MOMENTARY-2PTH; TACTILE-PTH
J4: C-GRID-05-70553; 70553-05
J5: USB-B; USB-B-PTH
R3: 10k; R1206
U2: FT232RL; SSOP28
U3: FSUSB42; MSOP10
U$3: VN-100

Connections:
+5V: C2.1, C3.1, IMU_TARE.3 (2), J4.5, U2.20 (VCC), U3.1 (VCC); also elsewhere on the board
GND: C2.2, C3.2, C4.2, J4.1, J5.GND, R3.1, U2.7 (GND), U2.18 (GND), U2.21 (GND), U2.25 (GND), U2.26 (TEST), U3.5 (GND), U3.10 (OE); also elsewhere on the board
IMU_RX: J4.3, U2.1 (TXD)
IMU_TARE: IMU_TARE.1, J4.4
IMU_TX: J4.2, U2.5 (RXD)
unnamed: J5.D+, U3.9 (HSD2+)
unnamed: U2.16 (USBDM), U3.4 (D-)
unnamed: U2.15 (USBDP), U3.3 (D+)
unnamed: J5.D-, U3.8 (HSD2-)
unnamed: J5.VBUS, R3.2, U3.2 (SEL)
unnamed: C4.1, U2.4 (VCCIO), U2.17 (3V3OUT)
USB1_D+: U3.7 (HSD1+); also elsewhere on the board
USB1_D-: U3.6 (HSD1-); also elsewhere on the board
