HASP-UMN/2015/Hardware/GNSS-IMU/UMN_HASP_2015_GPS-IMU_Board.brd

## EAGLE design Hardware/GNSS-IMU/UMN_HASP_2015_GPS-IMU_Board.brd (continued)

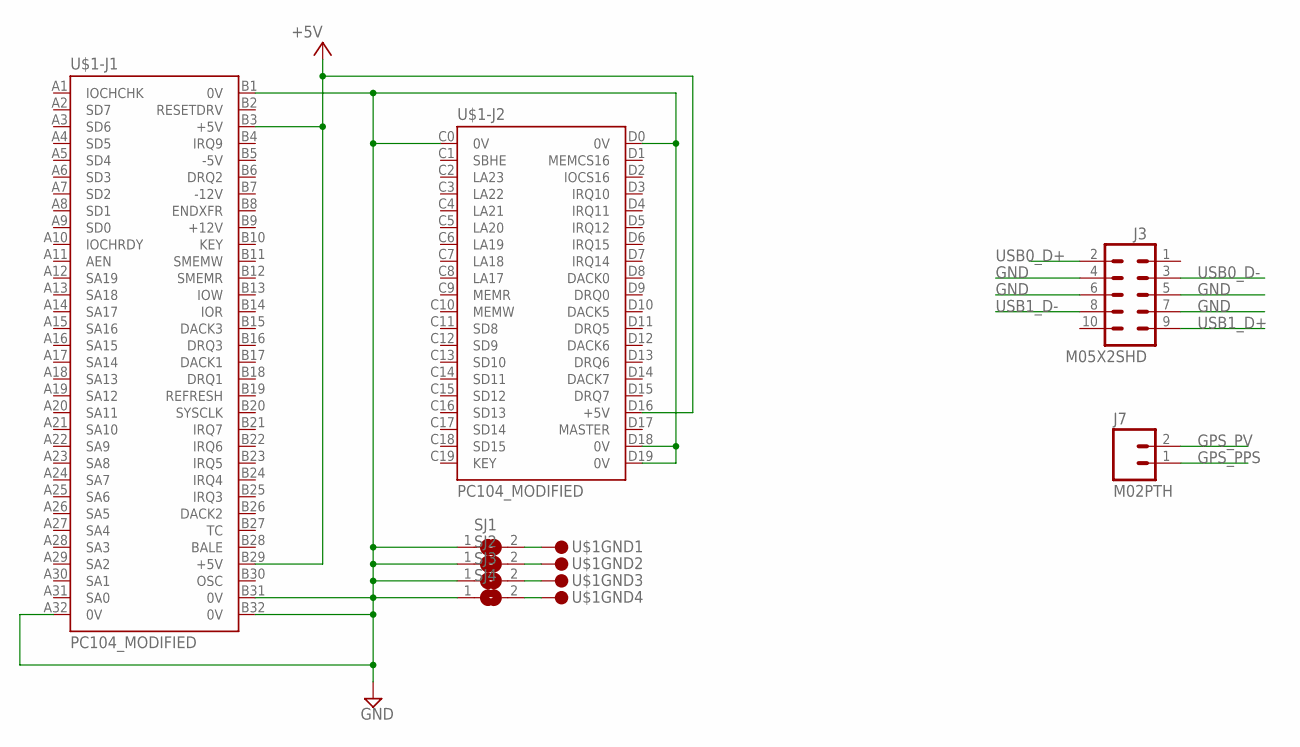
[picture p53: schematic UMN_HASP_2015_GPS-IMU_Board.sch, sheet 3, PC/104]

Parts:
J3: M05X2SHD; 2X5-SHROUDED
J7: M02PTH; 1X02
SJ1, SJ2, SJ3, SJ4: SJ
U$1: PC104_MODIFIED

Connections:
+5V: U$1.B3 (+5V), U$1.B29 (+5V), U$1.D16 (+5V); also elsewhere on the board
GND: J3.4, J3.5, J3.6, J3.7, SJ1.1, SJ2.1, SJ3.1, SJ4.1, U$1.A32 (0V), U$1.B1 (0V), U$1.B31 (0V), U$1.B32 (0V), U$1.C0 (0V), U$1.D0 (0V), U$1.D18 (0V), U$1.D19 (0V); also elsewhere on the board
GPS_PPS: J7.1; also elsewhere on the board
GPS_PV: J7.2; also elsewhere on the board
unnamed: SJ1.2, U$1.GND@1 (1)
unnamed: SJ2.2, U$1.GND@2 (1)
unnamed: SJ3.2, U$1.GND@3 (1)
unnamed: SJ4.2, U$1.GND@4 (1)
USB0_D+: J3.2; also elsewhere on the board
USB0_D-: J3.3; also elsewhere on the board
USB1_D+: J3.9; also elsewhere on the board
USB1_D-: J3.8; also elsewhere on the board

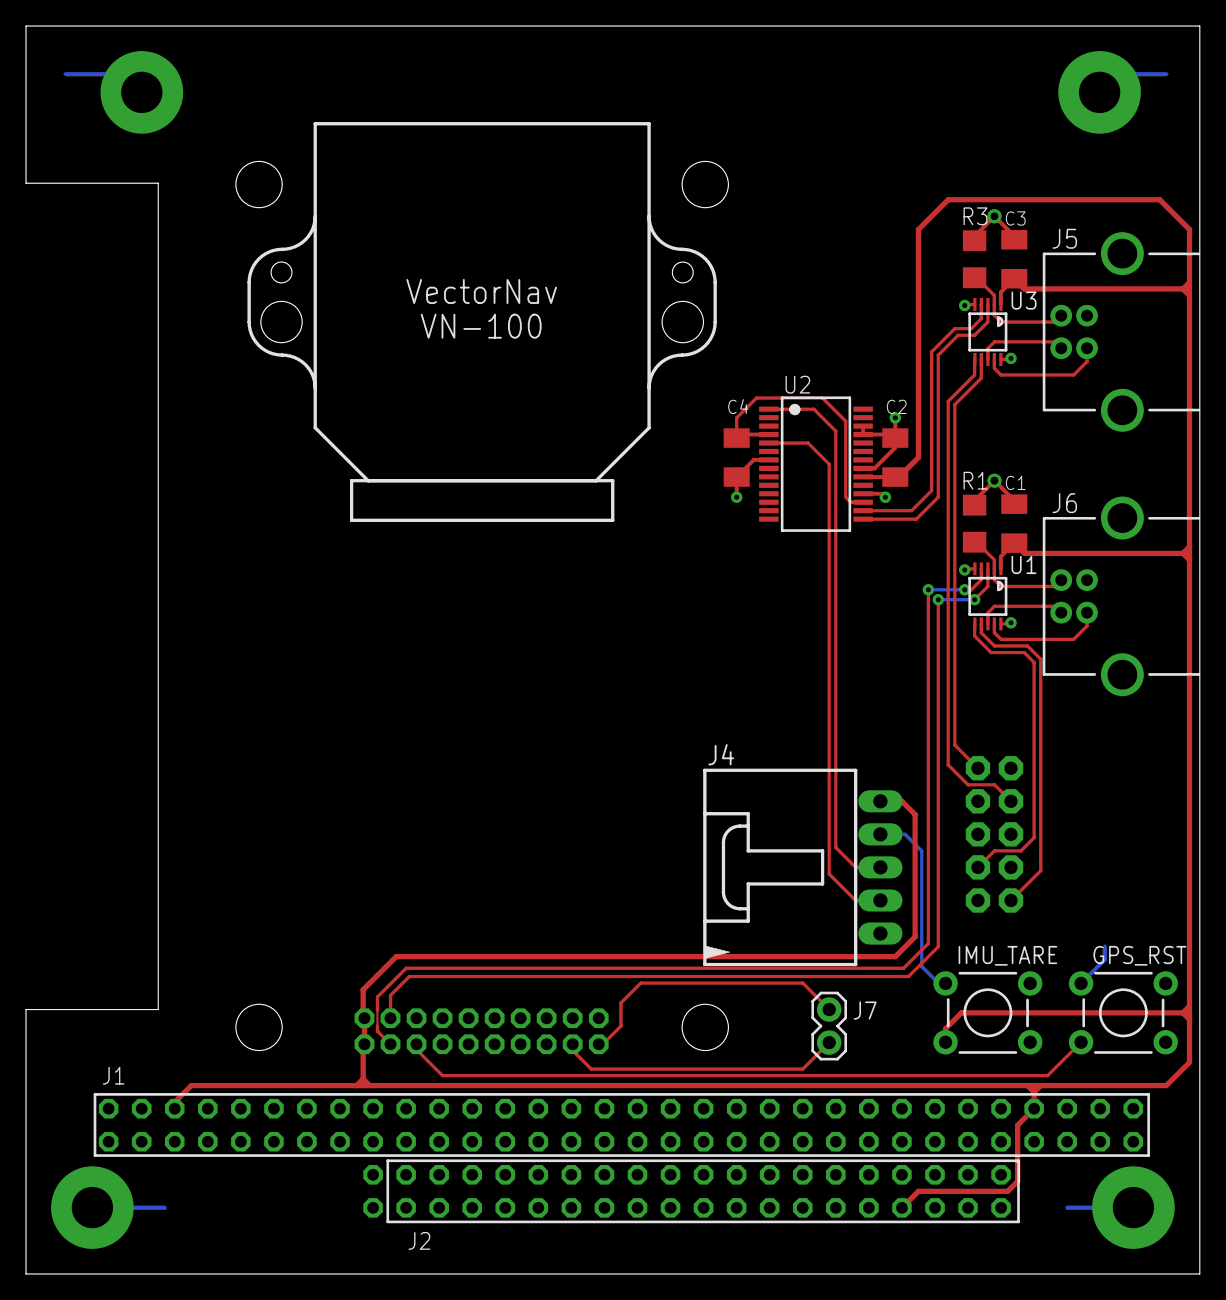
[picture p54: board UMN_HASP_2015_GPS-IMU_Board.brd from above]

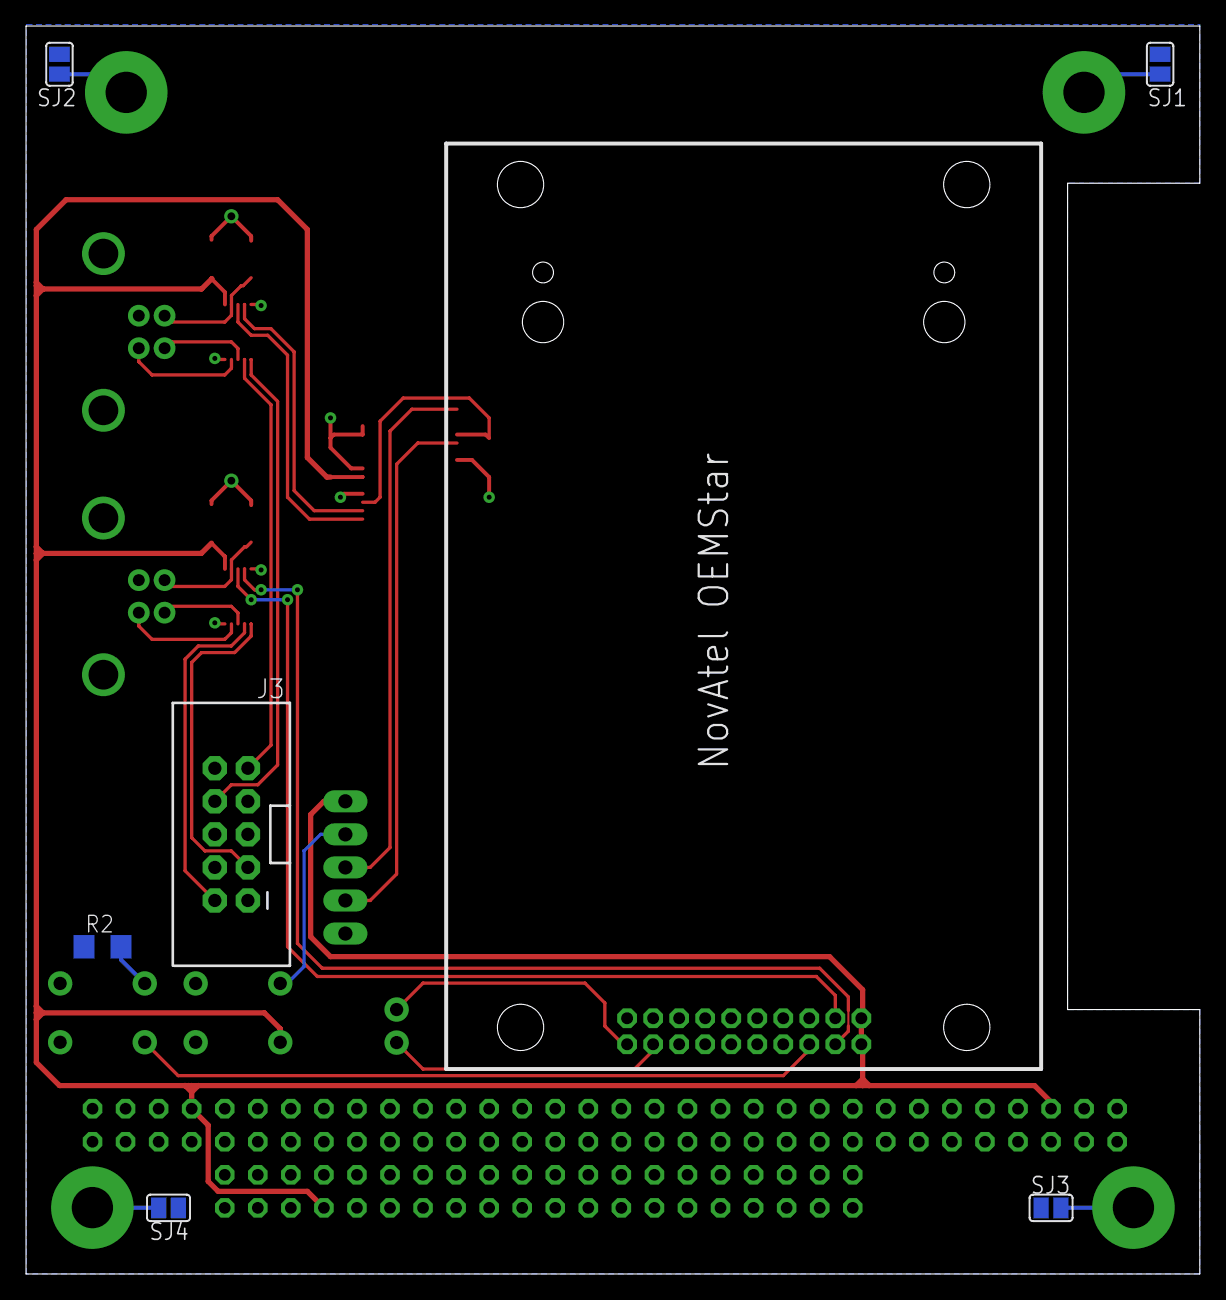
[picture p55: board UMN_HASP_2015_GPS-IMU_Board.brd from below]

Board: 2 copper layers, 90.2 x 95.9 mm, 24 parts (6 on the bottom side), 28 nets.
