HASP-UMN/2015/Hardware/HVPS/UMN_HASP_2015_HVPS.brd

## EAGLE design Hardware/HVPS/UMN_HASP_2015_HVPS.brd (2015-06-22)

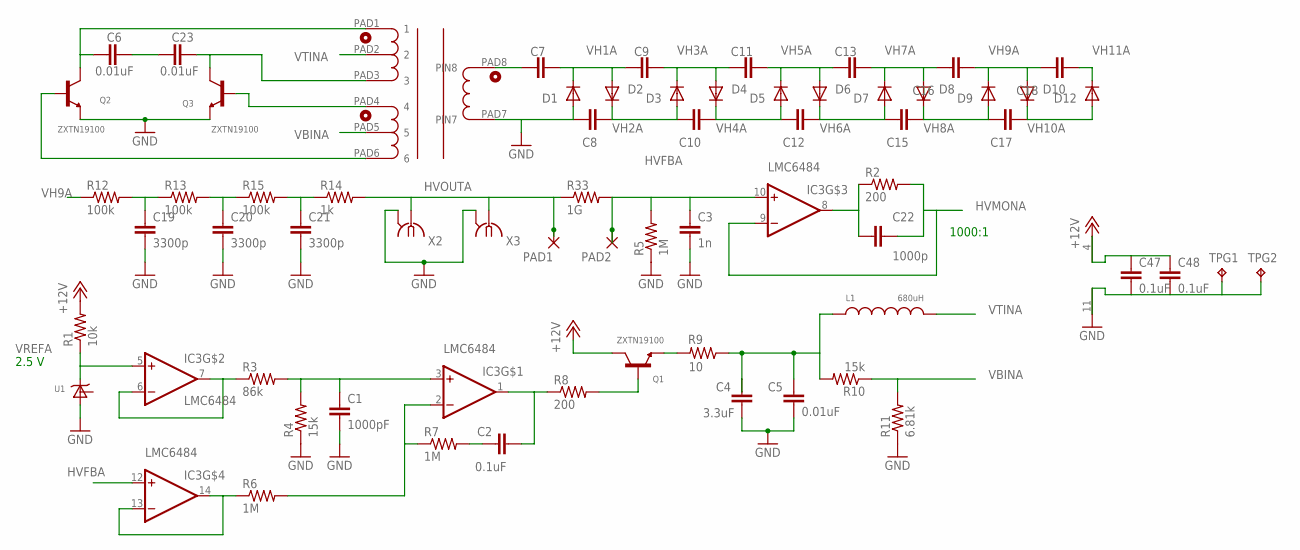
[picture p56: schematic UMN_HASP_2015_HVPS.sch, sheet 1, HVPS A]

Parts:
C1: 1000pF; C0603
C2, C47, C48: 0.1uF; C0603
C3: 1n; C0603
C4: 3.3uF; C0603
C5, C6, C23: 0.01uF; C0603
C7, C8, C9, C10, C11, C12, C13, C15, C16, C17, C18: C-EUC1206K; C1206K
C19, C20, C21: 3300p; C1206
C22: 1000p; C0603
D1, D2, D3, D4, D5, D6, D7, D8, D9, D10, D12: DIODE-DO-214AC; DO-214AC
IC3: LMC6484; SO14
L1: 680uH; INDUCTOR_SRR1280BOURNS
PAD1, PAD2: WIREPADSMD1,27-254; SMD1,27-2,54
Q1, Q2, Q3: ZXTN19100; SOT23_2CM_SQ_AREA
R1: 10k; R0603
R2, R8: 200; R0603
R3: 86k; R0603
R4, R10: 15k; R0603
R5, R6, R7: 1M; R0603
R9: 10; R2010
R11: 6.81k; R0603
R12, R13, R15: 100k; R0603
R14: 1k; R0603
R33: 1G; R2512
TPG1, TPG2: TPB1,27; B1,27
U1: ADR525; SOT23A
U$1: TDK_TRANSFORMER_RM6_CORE; SM_DCOILFORMER_RM6
X2, X3: BU-SMA-V-REVB; BU-SMA-V

Connections:
+12V: C47.1, C48.1, IC3.4 (V+), Q1.C, R1.2; also elsewhere on the board
GND: C1.2, C3.2, C4.2, C5.2, C8.1, C19.2, C20.2, C21.2, C47.2, C48.2, D1.A, IC3.11 (V-), Q2.E, Q3.E, R4.1, R5.1, R11.1, TPG1.TP, TPG2.TP, U1.2 (V-), U$1.PAD7 (PIN7), X2.2 (GND), X2.3 (GND), X2.4 (GND), X2.5 (GND), X3.2 (GND), X3.3 (GND), X3.4 (GND), X3.5 (GND); also elsewhere on the board
HVFBA: C3.1, IC3.10 (+IN), IC3.12 (+IN), PAD2.1, R5.2, R33.2
HVMONA: C22.1, IC3.9 (-IN), R2.2
HVOUTA: PAD1.1, R14.2, R33.1, X2.1, X3.1
unnamed: C22.2, IC3.8 (OUT), R2.1
unnamed: IC3.6 (-IN), IC3.7 (OUT), R3.1
unnamed: C1.1, IC3.3 (+IN), R3.2, R4.2
unnamed: C6.1, C23.2
unnamed: IC3.13 (-IN), IC3.14 (OUT), R6.1
unnamed: IC3.2 (-IN), R6.2, R7.1
unnamed: C6.2, Q2.C, U$1.PAD1 (1)
unnamed: C2.1, R7.2
unnamed: C2.2, IC3.1 (OUT), R8.1
unnamed: C4.1, C5.1, L1.P$1, R9.1, R10.2
unnamed: C7.1, U$1.PAD8 (PIN8)
unnamed: C23.1, Q3.C, U$1.PAD3 (3)
unnamed: C19.1, R12.2, R13.1
unnamed: C20.1, R13.2, R15.1
unnamed: C21.1, R14.1, R15.2
unnamed: Q1.E, R9.2
unnamed: Q1.B, R8.2
unnamed: Q3.B, U$1.PAD4 (4)
unnamed: Q2.B, U$1.PAD6 (6)
VBINA: R10.1, R11.2, U$1.PAD5 (5)
VH1A: C7.2, C9.1, D1.C, D2.A
VH2A: C8.2, C10.1, D2.C, D3.A
VH3A: C9.2, C11.1, D3.C, D4.A
VH4A: C10.2, C12.1, D4.C, D5.A
VH5A: C11.2, C13.1, D5.C, D6.A
VH6A: C12.2, C15.1, D6.C, D7.A
VH7A: C13.2, C16.1, D7.C, D8.A
VH8A: C15.2, C17.1, D8.C, D9.A
VH9A: C16.2, C18.1, D9.C, D10.A, R12.1
VH10A: C17.2, D10.C, D12.A
VH11A: C18.2, D12.C
VREFA: IC3.5 (+IN), R1.1, U1.1 (V+)
VTINA: L1.P$2, U$1.PAD2 (2)

Notes on the sheet:
2.5 V
1000:1

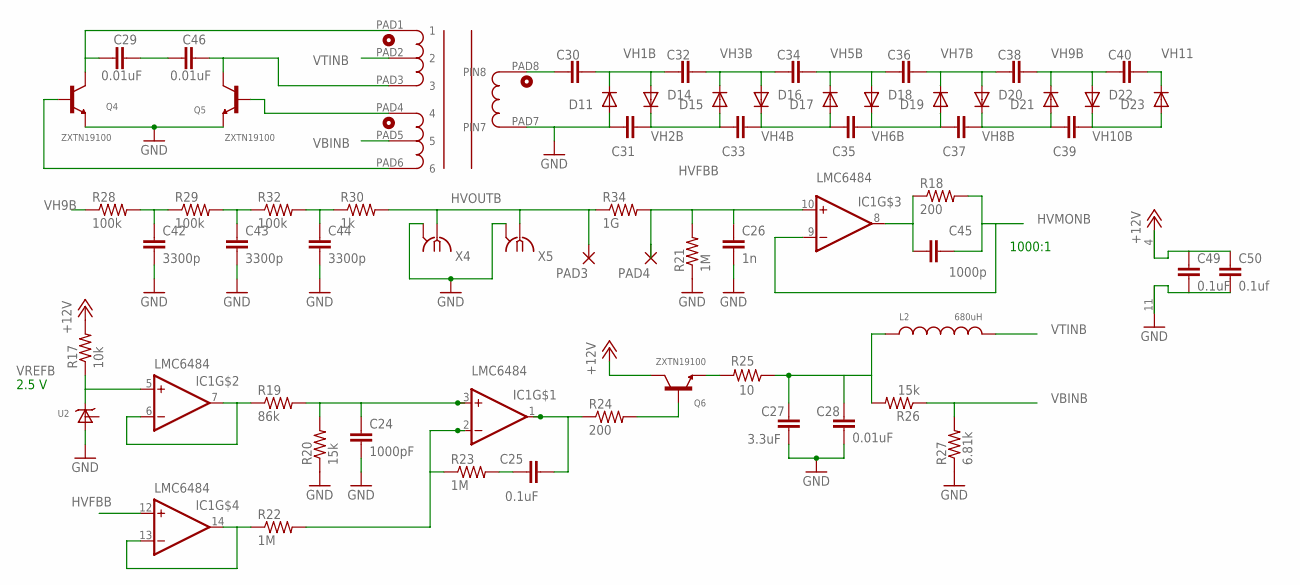
[picture p57: schematic UMN_HASP_2015_HVPS.sch, sheet 2, HVPS B]

Parts:
C24: 1000pF; C0603
C25, C49: 0.1uF; C0603
C26: 1n; C0603
C27: 3.3uF; C0603
C28, C29, C46: 0.01uF; C0603
C30, C31, C32, C33, C34, C35, C36, C37, C38, C39, C40: C-EUC1206K; C1206K
C42, C43, C44: 3300p; C1206
C45: 1000p; C0603
C50: 0.1uf; C0603
D11, D14, D15, D16, D17, D18, D19, D20, D21, D22, D23: DIODE-DO-214AC; DO-214AC
IC1: LMC6484; SO14
L2: 680uH; INDUCTOR_SRR1280BOURNS
PAD3, PAD4: WIREPADSMD1,27-254; SMD1,27-2,54
Q4, Q5, Q6: ZXTN19100; SOT23_2CM_SQ_AREA
R17: 10k; R0603
R18, R24: 200; R0603
R19: 86k; R0603
R20, R26: 15k; R0603
R21, R22, R23: 1M; R0603
R25: 10; R2010
R27: 6.81k; R0603
R28, R29, R32: 100k; R0603
R30: 1k; R0603
R34: 1G; R2512
U2: ADR525; SOT23A
U$2: TDK_TRANSFORMER_RM6_CORE; SM_DCOILFORMER_RM6
X4, X5: BU-SMA-V-REVB; BU-SMA-V

Connections:
+12V: C49.1, C50.1, IC1.4 (V+), Q6.C, R17.2; also elsewhere on the board
GND: C24.2, C26.2, C27.2, C28.2, C31.1, C42.2, C43.2, C44.2, C49.2, C50.2, D11.A, IC1.11 (V-), Q4.E, Q5.E, R20.1, R21.1, R27.1, U2.2 (V-), U$2.PAD7 (PIN7), X4.2 (GND), X4.3 (GND), X4.4 (GND), X4.5 (GND), X5.2 (GND), X5.3 (GND), X5.4 (GND), X5.5 (GND); also elsewhere on the board
HVFBB: C26.1, IC1.10 (+IN), IC1.12 (+IN), PAD4.1, R21.2, R34.2
HVMONB: C45.1, IC1.9 (-IN), R18.2
HVOUTB: PAD3.1, R30.2, R34.1, X4.1, X5.1
unnamed: IC1.6 (-IN), IC1.7 (OUT), R19.1
unnamed: C24.1, IC1.3 (+IN), R19.2, R20.2
unnamed: IC1.13 (-IN), IC1.14 (OUT), R22.1
unnamed: IC1.2 (-IN), R22.2, R23.1
unnamed: C25.1, R23.2
unnamed: C25.2, IC1.1 (OUT), R24.1
unnamed: C27.1, C28.1, L2.P$1, R25.1, R26.2
unnamed: Q6.E, R25.2
unnamed: Q6.B, R24.2
unnamed: C29.2, Q4.C, U$2.PAD1 (1)
unnamed: Q5.B, U$2.PAD4 (4)
unnamed: Q4.B, U$2.PAD6 (6)
unnamed: C30.1, U$2.PAD8 (PIN8)
unnamed: C42.1, R28.2, R29.1
unnamed: C43.1, R29.2, R32.1
unnamed: C44.1, R30.1, R32.2
unnamed: C45.2, IC1.8 (OUT), R18.1
unnamed: C29.1, C46.2
unnamed: C46.1, Q5.C, U$2.PAD3 (3)
VBINB: R26.1, R27.2, U$2.PAD5 (5)
VH1B: C30.2, C32.1, D11.C, D14.A
VH2B: C31.2, C33.1, D14.C, D15.A
VH3B: C32.2, C34.1, D15.C, D16.A
VH4B: C33.2, C35.1, D16.C, D17.A
VH5B: C34.2, C36.1, D17.C, D18.A
VH6B: C35.2, C37.1, D18.C, D19.A
VH7B: C36.2, C38.1, D19.C, D20.A
VH8B: C37.2, C39.1, D20.C, D21.A
VH9B: C38.2, C40.1, D21.C, D22.A, R28.1
VH10B: C39.2, D22.C, D23.A
VH11: C40.2, D23.C
VREFB: IC1.5 (+IN), R17.1, U2.1 (V+)
VTINB: L2.P$2, U$2.PAD2 (2)

Notes on the sheet:
2.5 V
1000:1

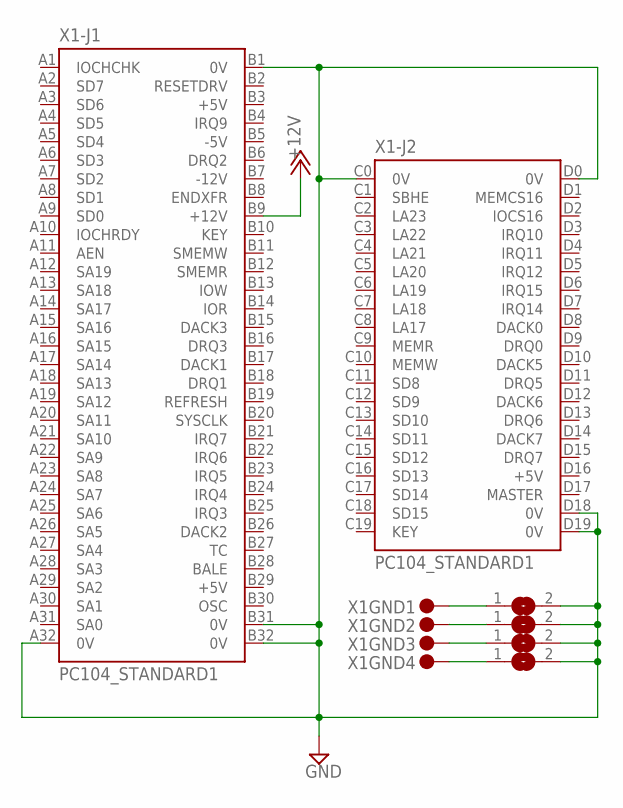
[picture p58: schematic UMN_HASP_2015_HVPS.sch, sheet 3, PC/104]

Parts:
SJ1, SJ2, SJ3, SJ4: SJ
X1: PC104_STANDARD1; PC104-STANDARD

Connections:
+12V: X1.B9 (+12V); also elsewhere on the board
GND: SJ1.2, SJ2.2, SJ3.2, SJ4.2, X1.A32 (0V), X1.B1 (0V), X1.B31 (0V), X1.B32 (0V), X1.C0 (0V), X1.D0 (0V), X1.D18 (0V), X1.D19 (0V); also elsewhere on the board
unnamed: SJ1.1, X1.GND@1 (1)
unnamed: SJ2.1, X1.GND@2 (1)
unnamed: SJ3.1, X1.GND@3 (1)
unnamed: SJ4.1, X1.GND@4 (1)

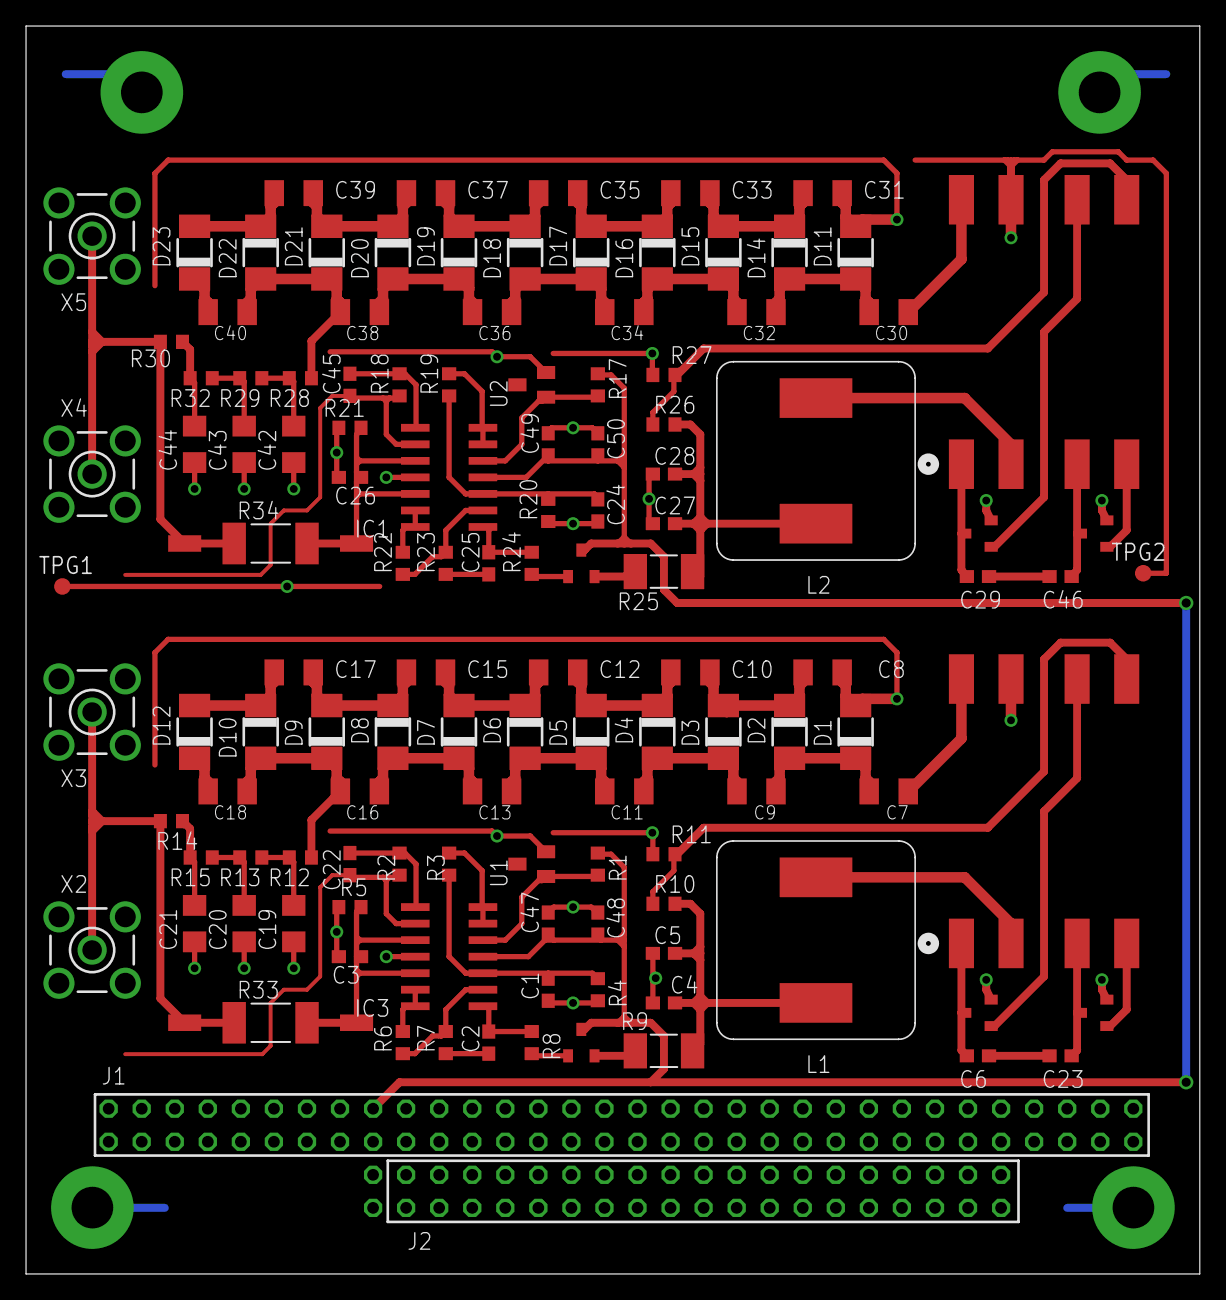
[picture p59: board UMN_HASP_2015_HVPS.brd from above]

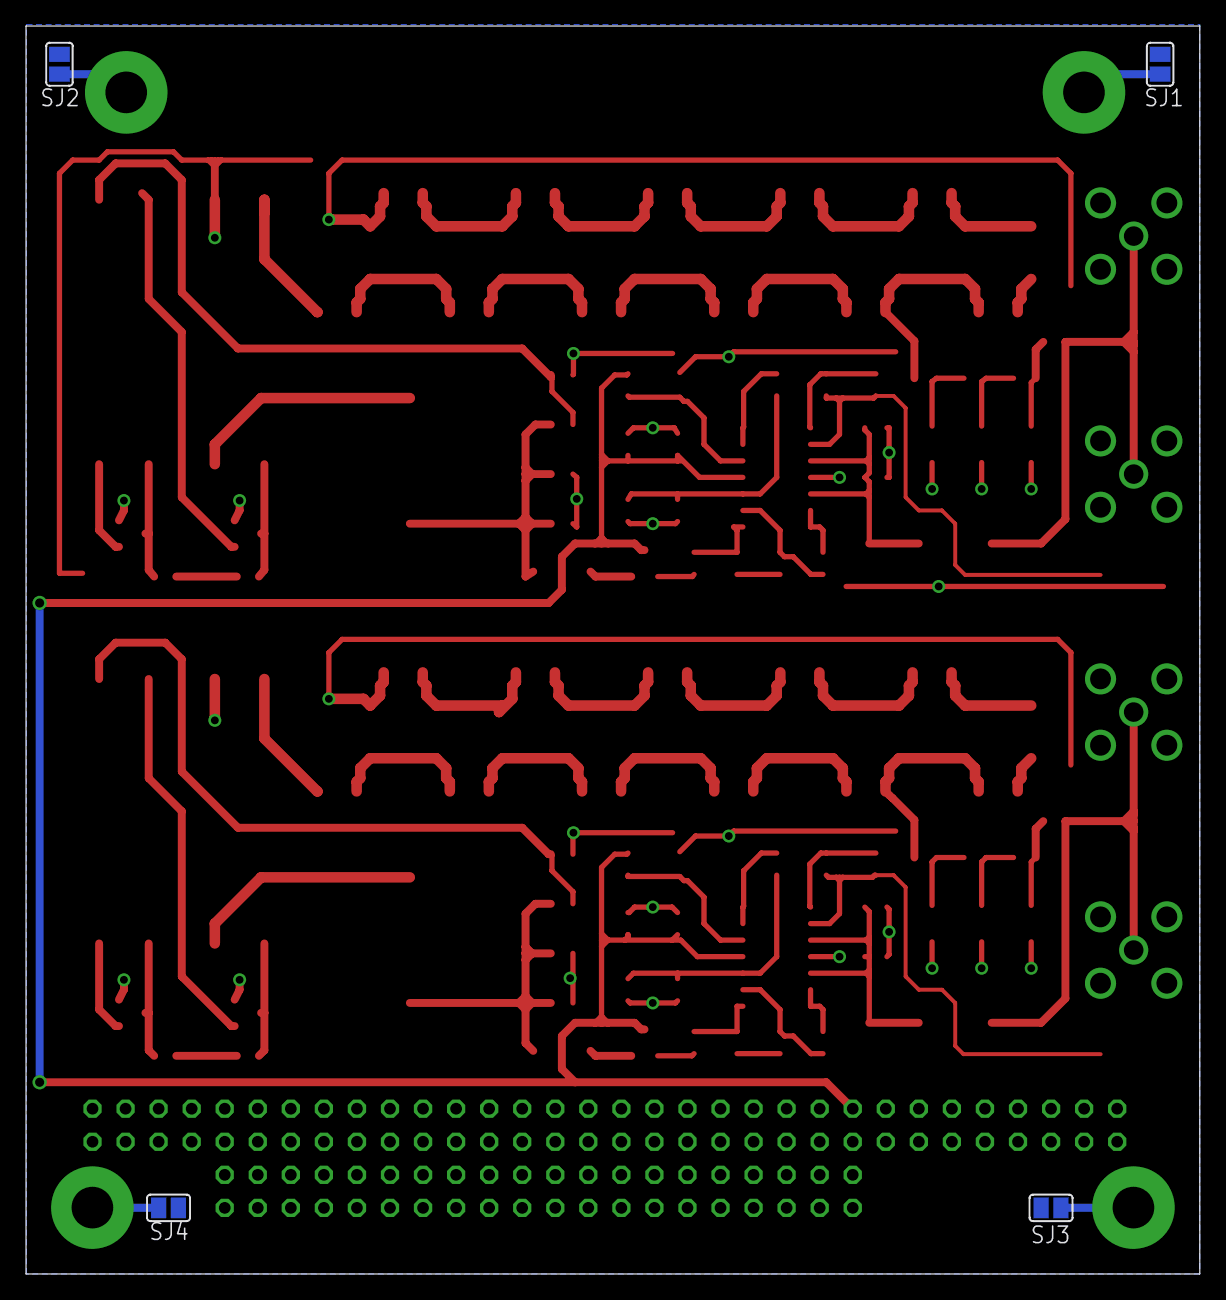
[picture p60: board UMN_HASP_2015_HVPS.brd from below]

Board: 2 copper layers, 90.2 x 95.9 mm, 131 parts (4 on the bottom side), 78 nets.
