HASP-UMN/2015/Tomcat/main.c

//  ***** HASP UNIVERISTY OF MINNESOTA 2015 *****
//  main.c
//  hasp
//
//  Created by Aron Lindell on 6/8/15.
//  Edited 6/19/2015 - Charlie Denis

// Include files
#include <stdio.h>
#include <stdlib.h>
#include <errno.h>
#include <time.h>
#include <termios.h>
#include <fcntl.h>
#include <unistd.h>
#include <sys/types.h>
#include <string.h>
#include <math.h>
#include <sys/io.h>
#include <signal.h>
#include <sys/wait.h>

#include "globaldefs.h"
#include "read_fifo_store_data.h"
#include "timing.h"
#include "VN100.h"
#include "gps_novatel.h"
#include "errorword.h"
#include "telemetry.h"


//Data structures
struct imu imuData;
struct gps gpsData;
struct photons photonData;

//Timestamps stored as longs
unsigned long t, t_0;
unsigned long imuStamp,gpsStamp,telStamp,eventStamp;
int imu_fd;

// buffer for reading from photon data fifo
#define 	     PHOTON_BUF_MAX 504
#define              BYTES_PER_PHOTON 12


//state machine state
typedef enum state{
    IDLE, RD_IMU, RD_GPS, TELEMETRY
}
state;

state checkState(state SMSTATE)
{
   long time = get_timestamp_ms();

    switch (SMSTATE) {
        case IDLE:

            if ( (time - imuStamp) >= 25){
                SMSTATE = RD_IMU;
            }
            else if ( (time - gpsStamp) >= 1000){
                SMSTATE = RD_GPS;
            }
            else if ( (time - telStamp) >= 5000){
                SMSTATE = TELEMETRY;
            }
            else
                SMSTATE = IDLE;

            break;

        case RD_IMU:

            //fprintf(stderr, "\nstate = RD_IMU\n");
            read_vn100(&imuData);
            imuStamp = get_timestamp_ms();
            SMSTATE = IDLE;
            break;

        case RD_GPS:

            fprintf(stderr, "\nstate = RD_GPS\n");
            read_GPS(&gpsData);
            gpsStamp = get_timestamp_ms();
            SMSTATE = IDLE;
            break;

        case TELEMETRY:

            fprintf(stderr, "\nstate = TELEMETRY\n");
            getErrorWord();
            send_telemetry(&imuData,&gpsData,&photonData);
            telStamp = get_timestamp_ms();
            SMSTATE = IDLE;
            break;

        default:
            fprintf(stderr, "\nstate = default\n");
            SMSTATE = IDLE;
            break;
    }

    return SMSTATE;

}

int main()
{

    // Initialize IMU
	init_vn100(&imuData);

    // Initialize GPS
	init_GPS(&gpsData);

    // Initialize Telemetry
    	init_telemetry();

    // Initialize Error Reporting
    	init_ErrorReporting();


	t_0 = get_timestamp_ms();
	eventStamp = t_0;
	gpsStamp = t_0;
	imuStamp = t_0;
	telStamp = t_0;

    photonData.counts_ch01 = 0;
    photonData.counts_ch02 = 0;
    photonData.counts_ch03 = 0;
    photonData.counts_ch04 = 0;


    // next fork a child to call read on the fifo device in while(1)

    pid_t childpid;
    if ( (childpid = fork()) < 0)
	{
		fprintf(stderr, "Fork failed\n");
	}

  	if (childpid == 0 )
	{
        //child code
		execl("./read_fifo_store_data", "read_fifo_store_data", (char*) 0);
		fprintf(stderr, "Child failed to execl command\n");
		return -1;
	}

    // Initialize Error Pipe
    init_ErrorPipe();

    // Initialize Telemetry Pipe
    init_telemetryPipe();


    state SMSTATE = IDLE;
//	int child_status;
    while (1)
    {
        t = get_timestamp_ms() - t_0;
        SMSTATE = checkState(SMSTATE);
/*		if ( waitpid(childpid, &child_status, WNOHANG) == childpid)// just for testing, not flight code
		{
			break;
		}
*/
    }

    // Close IMU Data File
	fclose(imuData.VN100File);
    return 0;
}
