HASP-UMN/2015/ATmega2560/Flight Version/ATmega2560/RTC_TIME_SET/RTC_TIME_SET.ino

//////////////////////////////////////////
//    DS3231 RTC Setup CODE             //
//    * To use:                         //   
//        1 upload to ATMEGA2560        //
//        2 run Serial Monitor          //      
//        3 follow prompts              //
//////////////////////////////////////////

#include <Wire.h>
#define DS3231 0x68 // DS3231 see data sheets

const char* days[] =
{"Sunday", "Monday", "Tuesday", "Wednesday", "Thursday", "Friday", "Saturday"};
const char* months[] =
{"January", "February", "March", "April", "May", "June", "July", "August","September", "October", "November", "December"};
 
// Initializes all values: 
byte second = 0;
byte minute = 0;
byte hour = 0;
byte weekday = 0;
byte monthday = 0;
byte month = 0;
byte year = 0;

void setup() {
  Wire.begin();
  Serial.begin(115200);
  delay(1000); // This delay allows the MCU to read the current date and time.
 
  Serial.print("The current date and time is: "); 
  printTime();
  Serial.println("Please change to newline ending the settings on the lower right of the Serial Monitor");
  Serial.println("Would you like to set the date and time now? Y/N");
  Serial.println("\t *Please Set Serial Monitor to Carriage Return");
 
  while (!Serial.available()) delay(10);
  if (Serial.read() == 'y' || Serial.read() == 'Y')
 
  // This set of functions allows the user to change the date and time
  {
    Serial.read();
    setTime();
    Serial.print("The current date and time is now: ");
    printTime();
  }
  Serial.println("Time set, Goodbye.");
}

// This set of codes is allows input of data
void setTime() {
  Serial.println("Setting Time...");
  Serial.println("\t *Please Set Serial Monitor to New Line and Carriage Return");
  Serial.print("Please enter the current year, 00-99. - ");
  year = readByte();
  Serial.println(year);
  Serial.print("Please enter the current month, 1-12. - ");
  month = readByte();
  Serial.println(months[month-1]);
  Serial.print("Please enter the current day of the month, 1-31. - ");
  monthday = readByte();
  Serial.println(monthday);
  Serial.println("Please enter the current day of the week, 1-7.");
  Serial.print("1 Sun | 2 Mon | 3 Tues | 4 Weds | 5 Thu | 6 Fri | 7 Sat - ");
  weekday = readByte();
  Serial.println(days[weekday-1]);
  Serial.print("Please enter the current hour in 24hr format, 0-23. - ");
  hour = readByte();
  Serial.println(hour);
  Serial.print("Please enter the current minute, 0-59. - ");
  minute = readByte();
  Serial.println(minute);
  second = 0;
  Serial.println("The data has been entered.");
 
  // The following codes transmits the data to the RTC
  Wire.beginTransmission(DS3231);
  Wire.write(byte(0));
  Wire.write(decToBcd(second));
  Wire.write(decToBcd(minute));
  Wire.write(decToBcd(hour));
  Wire.write(decToBcd(weekday));
  Wire.write(decToBcd(monthday));
  Wire.write(decToBcd(month));
  Wire.write(decToBcd(year));
  Wire.write(byte(0));
  Wire.endTransmission();
  // Ends transmission of data
}


byte readByte() {
  while (!Serial.available()) delay(10);
  byte reading = 0;
  byte incomingByte = Serial.read();
  while (incomingByte != '\n') {
    if (incomingByte >= '0' && incomingByte <= '9')
      reading = reading * 10 + (incomingByte - '0');
    else;
    incomingByte = Serial.read();
  }
  Serial.flush();
  return reading;
}

void printTime() {
  char buffer[3];
  const char* AMPM = 0;
  readTime();
  Serial.print(days[weekday-1]);
  Serial.print(" ");
  Serial.print(months[month-1]);
  Serial.print(" ");
  Serial.print(monthday);
  Serial.print(", 20");
  Serial.print(year);
  Serial.print(" ");
  if (hour > 12) {
    hour -= 12;
    AMPM = " PM";
  }
  else AMPM = " AM";
  Serial.print(hour);
  Serial.print(":");
  sprintf(buffer, "%02d", minute);
  Serial.print(buffer);
  Serial.println(AMPM);
}


void readTime() {
  Wire.beginTransmission(DS3231);
  Wire.write(byte(0));
  Wire.endTransmission();
  Wire.requestFrom(DS3231, 7);
  second = bcdToDec(Wire.read());
  minute = bcdToDec(Wire.read());
  hour = bcdToDec(Wire.read());
  weekday = bcdToDec(Wire.read());
  monthday = bcdToDec(Wire.read());
  month = bcdToDec(Wire.read());
  year = bcdToDec(Wire.read());
}

// Conversion Functions.
void loop(){}
byte decToBcd(byte val) {return ((val/10*16) + (val%10));}
byte bcdToDec(byte val) {return ((val/16*10) + (val%16));}
