HASP-UMN/2015/Tomcat/telepipe.c

// ***** HASP UNIVERISTY OF MINNESOTA 2015 *****
// telepipe.c

#include <stdlib.h>      // Standard C Library
#include <stdio.h>       // Standard I/O Library
#include <stdbool.h>     // Standard C Library for Boolean Capability
#include <math.h>        // Mathematical operations
#include <sys/stat.h>    // Named Pipes
#include <fcntl.h>       // I/O
#include <sys/ioctl.h>   // I/O
#include <unistd.h>      // Named Pipes

#include "globaldefs.h"
#include "telepipe.h"


static int fdTelemetryPipe;


void recordChannel(unsigned char channel){
    fprintf(stderr, "Start record channel\n");
    if(fdTelemetryPipe > -1){
        fprintf(stderr, "Write record channel\n");
        write(fdTelemetryPipe, &channel, 1);
    }
    else{
        fprintf(stderr,"############  TELEMETRY PIPE NOT OPEN  #############\n");  // For Debugging
    }
    return;
}


void init_telemetryPipe(){
    fdTelemetryPipe = open(TELEMETRY_FIFO, O_WRONLY);
    if(fdTelemetryPipe < 0){
        fprintf(stderr,"TELEMETRY PIPE failed to open\n");
    }
    else{
        fprintf(stderr,"TELEMETRY PIPE openned successfully.\n");
    }
    return;
}
