HASP-UMN/2015/Tomcat/read_fifo_store_data.h

// ***** HASP UNIVERISTY OF MINNESOTA 2015 *****
// read_fifo_store_data.h

#ifndef READ_FIFO_STORE_DATA_H_
#define READ_FIFO_STORE_DATA_H_

int read_fifo_store_data(int fifo_fd, int storage_fd, unsigned char* buf, size_t length);

#endif
