HASP-UMN/2015/Tomcat/serial.c

// ***** HASP UNIVERISTY OF MINNESOTA 2015 *****
// serial.c
// This file facilitates communication with the VN100 IMU
// Created on: Apr 3, 2015 at 3:16:34 PM   Author: John
// Edited 6/18/2015 Charles Denis

#include <errno.h>
#include <termios.h>
#include <unistd.h>
#include <string.h>
#include <stdio.h>

#include "serial.h"

int set_interface_attribs (int fd, int speed, int parity)
{
    struct termios tty;
    memset (&tty, 0, sizeof tty);
    if (tcgetattr (fd, &tty) != 0)
    {
        //error_message ("error %d from tcgetattr", errno);
        printf("error from tcgetattr\n");
        return -1;
    }

    cfsetospeed (&tty, speed);
    cfsetispeed (&tty, speed);

    tty.c_cflag = (tty.c_cflag & ~CSIZE) | CS8;     // 8-bit chars
    // disable IGNBRK for mismatched speed tests; otherwise receive break
    // as \000 chars
    tty.c_iflag &= ~IGNBRK;         // disable break processing
    tty.c_lflag = 0;                // no signaling chars, no echo,
                                    // no canonical processing
    tty.c_oflag = 0;                // no remapping, no delays
    tty.c_cc[VMIN]  = 0;            // read doesn't block
    tty.c_cc[VTIME] = 5;            // 0.5 seconds read timeout

    tty.c_iflag &= ~(IXON | IXOFF | IXANY); // shut off xon/xoff ctrl

    tty.c_cflag |= (CLOCAL | CREAD);// ignore modem controls,
                                    // enable reading
    tty.c_cflag &= ~(PARENB | PARODD);      // shut off parity
    tty.c_cflag |= parity;
    tty.c_cflag &= ~CSTOPB;
    tty.c_cflag &= ~CRTSCTS;

    if (tcsetattr (fd, TCSANOW, &tty) != 0)
    {
        //error_message ("error %d from tcsetattr", errno);
        printf("error from tcsetattr\n");
        return -1;
    }
    return 0;
}


void set_blocking (int fd, int should_block)
{
    struct termios tty;
    memset (&tty, 0, sizeof tty);
    if (tcgetattr (fd, &tty) != 0)
    {
        //error_message ("error %d from tggetattr", errno);
        printf("error from tggetattr\n");
        return;
    }

    tty.c_cc[VMIN]  = should_block ? 1 : 0;
    tty.c_cc[VTIME] = 5;            // 0.5 seconds read timeout

    if (tcsetattr (fd, TCSANOW, &tty) != 0)
	{
        printf("error setting term attributes\n");
		//error_message ("error %d setting term attributes", errno);
	}
	return;
}
