HASP-UMN/2015/Tomcat/serial.h

// ***** HASP UNIVERISTY OF MINNESOTA 2015 *****
// serial.h
// Created on: Apr 3, 2015 at 3:21:55 PM  Author: John

#ifndef SERIAL_H_
#define SERIAL_H_

int
set_interface_attribs (int, int, int);

void
set_blocking (int, int);

#endif /* SERIAL_H_ */
