HASP-UMN/2015/(commit log)

2015-06-17 Removed sensorData struct, cleaned up globaldefs.h
2015-06-17 first draft of irq driver
2015-06-18 Adding VN100.c/h to read the imu and serial.c/h to read from serial devices.
2015-06-18 files from tomcat working with imu
2015-06-18 Modified VN100 files to write to imu struct. General Cleanup
2015-06-19 Modified main.c to pass read_VN100() the imu struct.
2015-06-19 Moved six detector declarations from globaldefs.h to main.c so that globaldefs.h could be referenced in multiple files without having multiple declaration problems.
    [VN100.c, VN100.h, globaldefs.h, main.c]
2015-06-22 FT232RL BREAKOUT BOARD
    [FT232R-Breakout_v37.brd, FT232R-Breakout_v37.sch]
2015-06-22 Adding board/schematic files for HAXDT hardware
    [FT232R-Breakout_v37.brd, FT232R-Breakout_v37.sch]
2015-06-22 Moved FT232R-Breakout_v37/ to Hardware/ directory
    [FT232R-Breakout_v37.brd, FT232R-Breakout_v37.sch]
2015-06-22 Adding board/schematics for HAXDT hardware
    [UMN_HASP_2015_Front_End_Board1.brd, UMN_HASP_2015_Front_End_Board1.sch, UMN_HASP_2015_Front_End_Board2.brd, UMN_HASP_2015_Front_End_Board2.sch, UMN_HASP_2015_GPS-IMU_Board.brd, UMN_HASP_2015_GPS-IMU_Board.sch, UMN_HASP_2015_HVPS.brd, UMN_HASP_2015_HVPS.sch]
2015-06-23 FT232 folder ----> GNSS-IMU folder
    [FT232R-Breakout_v37.brd, FT232R-Breakout_v37.sch]
2015-06-26 PC/104 board screenshots
2015-06-29 added /modules and driver
2015-07-03 Bitmasking bug is corrected, PORT 7 is working
    [ATmega2560.ino]
2015-07-09 Worked on logging GPS data. In main.c, code for ISA bus still commented out for testing GPS and IMU.
2015-07-10 Improvements to gps_novatel. Addition of errorword to handles errors and to build an error word to be used in telemetry. errorword is still a work in progress.
    [VN100.c, errorword.c, errorword.h, gps_novatel.c, main.c]
2015-07-11 Latest version; revert to digitalWrite(). Not yet functional on CH3. May use PORTH method, but need to test trigger threshhold with greater ease
    [UMN_HASP_2015_Photon_Preprocessor.sch]
2015-07-13 Refined errorword.c and added error reporting to gps_novatel.c
    [errorword.c, errorword.h, gps_novatel.c, gps_novatel.h]
2015-07-13 Created utility to read from binary GPS data file and print pertinent data to the screen. Intended for testing of the gps.
2015-07-14 Improved errorword.c so it is now fully functional, improved gps_novatel to report errors more thoroughly. Set up VN100.c to report errors. Set up telemetry.c.
    [VN100.c, VN100.h, errorword.c, errorword.h, gps_novatel.c, main.c, telemetry.c, telemetry.h]
2015-07-15 Refined IMU code.
2015-07-16 Added error checking to the opening of the IMU data file.
    [VN100.c]
2015-07-20 ATmega2560 interrupt config
2015-07-24 timing changes
    square wave interrupts are causing problems.
    [ATmega2560.ino]
2015-07-28 fixed logic error in timing setup
    [ATmega2560.ino]
2015-07-28 Timing complete, not checked, updated other functions: see description notes.
    * added TIMING.h for all time declarations
    * Edited newEventCHx for time
    * added uSecStamp and TicStamp for each event
    * changed checksum passing to add both new variables instead of
    milliseconds
    * changed send_data to reflect new variables
    * Edited send_data function
    * replaced timeMs with uSecStamp and ticStamp.
    * added "startbyte" and second byte to temp
    [ATmega2560.ino, TIMING.h]
2015-07-30 Added timestamp to IMU based on time in GPS packets.
2015-07-30 Created AMTEL project for 32U4
    Using Atmel Studio to compile assembly level code for 32U4 chip to
    alleviate timing issues.
    [32U4.c, 32u4.h]
2015-07-31 Adding pipes for error reporting. Still in progress.
    [errorword.c, errorword.h, main.c, read_fifo_store_data.c]
2015-08-01 Added and tested named pipes to send error between two processes. Updated Error Reporting.
    [errorpipe.c, errorpipe.h, errorword.c, errorword.h, globaldefs.h, gps_novatel.c, main.c, read_fifo_store_data.c]
2015-08-03 Updated 2560. Fixed checksum.
    [ATmega2560.ino]
2015-08-04 added write control of irq enabling to driver
2015-08-04 removed debugging serial prints
2015-08-04 Final Flight Update
    Commented out all Serial Print data
2015-08-05 commented out reset channel counts
    [telemetry.c]
2015-10-27 Fixed bug in clock sync. function + removed unneeded delay from ISRs
    [ATmega2560.ino, RTC_TIME_SET.ino, TIMING.h]
